jordanbierbrier/capstone/README.md

# Synesthesia Wear

Developer Names:
- Abraham Taha
- Azriel Gingoyon
- Jordan Bierbrier
- Taranjit Lotey
- Udeep Shah

Date of project start:
September 6, 2022

This project is to create a wearable device that can detect specific sounds from the environment and notify the user.

The folders and files for this project are as follows:

- docs: Documentation for the project
- refs: Reference material used for the project, including papers
- src: Source code
- test: Test cases
