jordanbierbrier/capstone/docs/ProblemStatementAndGoals/ProblemStatement.tex

\documentclass[12pt, titlepage]{article}

\usepackage{booktabs}
\usepackage{tabularx}
\usepackage{hyperref}
\usepackage[table,xcdraw]{xcolor}
\usepackage{longtable}
\usepackage{multirow}
\usepackage{graphicx}
\usepackage{float}
\hypersetup{
    colorlinks,
    citecolor=black,
    filecolor=black,
    linkcolor=red,
    urlcolor=blue
}
\usepackage[round]{natbib}
\usepackage{ulem}

\input{../Comments}
\input{../Common}

\begin{document}

\title{Problem Statement and Goals: \progname} 
\author{\authname}
\date{\today}

\maketitle

\pagenumbering{roman}

\section*{Revision History}

\begin{tabularx}{\textwidth}{p{3cm}p{2cm}X}
\toprule {\bf Date} & {\bf Version} & {\bf Notes}\\
\midrule
9/26/2022 & 1.0 & Added Section 1\\
9/26/2022 & 1.1 & Added Sections 2,3\\
4/4/2023 & 1.2 & Updated All Sections for Feedback and Consistency\\
\bottomrule
\end{tabularx}

\newpage

\tableofcontents

\listoffigures

\listoftables

\newpage

\section*{Symbols, Abbreviations and Acronyms}

\renewcommand{\arraystretch}{1.2}
\begin{tabular}{l l} 
  \toprule		
  \textbf{symbol} & \textbf{description}\\
  \midrule 
  Age groups & (15-30, 31-50, 51-75, 75+)\\
  \bottomrule
\end{tabular}\\

\newpage

\pagenumbering{arabic}

\section{Problem Statement}

\subsection{Problem}
In this day and age, communication is a very significant part of our day to day lives.
\sout{So, people who have difficulty in recognizing sounds within their surroundings are not 
able to live their lives to their fullest. For instance, hard of hearing (HoH) individuals 
are not able to always respond promptly whenever their loved ones are calling their name or
when a doorbell rings out for a package delivery. As a result, this can be rather unfortunate
for the HoH individual as inconveniencing loved ones for another appeal or missing a delivery
are both not ideal scenarios to be in. This can especially be the case for life-and-death 
situations where the importance of sound awareness is highlighted. With all this in mind, 
a device which will monitor your surroundings for you would encourage confidence within 
the users to complete daily tasks as well as notably improve their quality of life.}
\textcolor{red}{So, for people who have difficulty hearing sounds in their environment, they are unable to respond 
appropriately when said sounds require their attention. For example, important alerts/sounds such as 
your name being called or a doorbell ring could all be missed if the person of interest is unable to notice 
these sounds when they occur. This can especially be the case for life-and-death situations (such as a fire alarm) 
where the importance of sound awareness is greatly highlighted. With that being said, such instances could be because 
the person had headphones plugged in (which diminish noise from their surroundings) or they are deaf/hard of hearing 
where they may struggle to recognize sounds in their environment. With all this in mind, a wearable device that improves 
its users' auditory awareness by monitoring their environments for specific sounds would definitely help alleviate the 
issues stated before. Furthermore, after said specific sounds are detected, the device would then provide the users with 
an appropriate feedback that helps let them know that their attention is required.}
\subsection{Inputs and Outputs}

\subsubsection {Inputs}
\begin{itemize}
    \item Environment Sounds
    \item App Settings/Configurations
\end{itemize}
\subsubsection {Outputs}
\begin{itemize}
    \item Haptic Feedback (Vibrations)
\end{itemize}

\subsection{Stakeholders}
\begin{itemize}
    \item Individuals who are hard of hearing, deaf or that are in an environment where hearing can be obstructed
    \item Dr.\ Martin Von Mohrenschildt (Project Supervisor)
    \item STRONE Developers (Creators of the project)
\end{itemize}

\subsection{Environment}
\subsubsection{Hardware}
\begin{itemize}
    \item Device can be configured through the use of a personal computer, laptop or phone.
\end{itemize}
\subsubsection{Software}
\begin{itemize}
    \item The application will be supported on both Mac and Windows operating systems.
    \item The application will be supported on IOS and Andrioid mobile devices.   
\end{itemize}

\section{Goals}
\subsection{\sout{Finished device can withstand above moderate environmental conditions such as moisture and heat} \textcolor{red}{Device can withstand normal environmental conditions}}
\begin{itemize}
    \item \sout{The device will be a wearable technology which makes it a necessity that the user does not need to worry about damage in average daily conditions.} \textcolor{red}{The device should not be damaged from daily conditions such as rain, heat, moisture, etc.}
   \end{itemize} 

 \subsection{\sout{Device can collect and process data in real time while filtering out noise} \textcolor{red}{The device will be able to identify key sounds in the environment}}  
 \begin{itemize}
    \item \sout{A core functional aspect of the device is to process a continuous stream of data and react once a key data point is found.} \textcolor{red}{Fire Alarm}
    \item \sout{This permits our device to provide the necessary sensory outputs to the user.} \textcolor{red}{Doorbell Ring}
    \item \textcolor{red}{Names}
  \end{itemize} 

 \subsection{\sout{Finished product can communicate with an external device} \textcolor{red}{User can customize their experience}}
 \begin{itemize}
    \item \sout{Having the ability to directly communicate with external devices will allow the device to be uniquely programmable by different users.} \textcolor{red}{Product will communicate with external devices so that users can customize their keywords}
 \end{itemize}

 \subsection{\sout{Data collected will be processed and then deleted in real time} \textcolor{red}{Real-Time Data Processing}}
 \begin{itemize}
    \item \sout{This allows the product to be used in multiple environments without the risk of privacy concerns for the user.} \textcolor{red}{No delays in results and data storage is not needed.}
\end{itemize}  

 \subsection{Finished product \sout{will retain all functionalities in a form factor that} is wearable}
 \begin{itemize}
    \item Device will need to be appropriately small such that it can be worn comfortably and non-intrusively by the user.
 \end{itemize}

 \subsection{Finished product will be rechargeable and
 reusable}
 \begin{itemize}
    \item This will expand the usability of the device and help market growth.
    \item This will also contribute to reducing e-waste since the finished product will have a longer lifespan.
 \end{itemize} 

 \subsection{The finished product will have \sout{sufficient distinct sensory outputs such that the user can distinguish between them} \textcolor{red}{numerous distinct feedbacks}}
 \begin{itemize}
    \item This allows the device to have multiple programmable key data points that the user can choose to be notified by.
    \item This will also act to expand the usability \sout{of the product} and programmability of the device by the user. 
 \end{itemize} 

\section{Stretch Goals}

\subsection{Finished product will have \sout{a} water resistance \sout{rating of IPX5}}
\begin{itemize}
    \item This will increase usability of the product.
    \item This will also avoid the possibility that the device will become malfunctional under \sout{certain} wet weather conditions.
 \end{itemize} 

\subsection{Finished product can actively filter out noise in particularly loud environments}
\begin{itemize}
    \item This will expand the environments where
    the product can function as intended.
    This will also lead to more reliable
    outputs from the device in situations
    where hearing is more obstructed by
    noises in the surroundings. 
    \textcolor{red}{These environments can be places like a construction site, at a concert, or at the gym.}
\end{itemize}

\subsection{Finished product will support \sout{over the air} firmware updates}
\begin{itemize}
    \item As the product develops and is used in
    real world applications we predict that the
    noise detection algorithm we use will keep
    improving. Having the option to upgrade
    prior devices with better signal processing
    through software will aid in extending the
    usability of older products.
    
\end{itemize}

\end{document}
