jordanbierbrier/capstone/docs/DevelopmentPlan/DevelopmentPlan.tex

\documentclass[12pt, titlepage]{article}

\usepackage{booktabs}
\usepackage{tabularx}
\usepackage{verbatim}
\usepackage{ulem}
\title{Development Plan\\\progname}

\author{\authname}

\date{}

\input{../Comments}
\input{../Common}

\begin{document}
\title{Development Plan: \progname} 
\author{\authname}
\date{\today}
	
\maketitle

\pagenumbering{roman}

\section*{Revision History}

\begin{tabularx}{\textwidth}{p{3cm}p{2cm}X}
\toprule {\bf Date} & {\bf Version} & {\bf Notes}\\
\midrule
9/26/2022 & 1.0 & Initial commit\\
9/26/2022 & 1.1 & Updated Workflow Plan Section\\
9/26/2022 & 1.2 & Updated Major Milestones\\
9/26/2022 & 1.3 & Updated Technology Section\\
4/4/2023 & 1.4 & Updated formatting and revised POC content\\
\bottomrule
\end{tabularx}

\newpage

\tableofcontents

\listoffigures

\listoftables

\newpage
\section*{\textcolor{red}{Symbols, Abbreviations and Acronyms}}

\renewcommand{\arraystretch}{1.2}
\begin{tabular}{l l} 
  \toprule		
  \textbf{symbol} & \textbf{description}\\
  \midrule 
  Age groups & (15-30, 31-50, 51-75, 75+)\\
  \bottomrule
\end{tabular}\\

\newpage

\pagenumbering{arabic}

\section{Team Meeting Plan}
The team will meet in person on Wednesdays at 4:30pm on a weekly basis. These meetings will typically be done in person at Thode Library or in the capstone project room. However, additional meetings or daily checkups will be scheduled on a per-need basis depending on the status of the project and upcoming deliverables. Additional meetings may either be held in person or virtually through the use of the team’s Discord server.

\section{Team Communication Plan}
The team will have two primary sources of communication which include a Discord server as well as a Facebook messenger group chat. The Discord server is used for hosting virtual meetings as well as sharing files and useful links. Communication will also occur through commit messages and issues when collaborating on deliverables through GitHub. The purpose of using GitHub will also be for team collaboration as well as changing history and reverting opportunities. 

\section{Team Member Roles}
Although we are split up into different roles, which are based on the workload and our skills, we will work closely with one another and review each other's work thoroughly. It is important to communicate with other team members as all of our modules will be linked together. Additionally, roles can change depending on the amount of work and time required. 
% Please add the following required packages to your document preamble:
% \usepackage{graphicx}
\begin{comment}
\begin{table}[]
	\centering
	\begin{tabular}{| m{5em} | m{4cm}| m{5cm} |}
	\hline
	Member						 & Role                                           & Description                                                                                                                                                                                                                \\ \hline
	Abraham Taha                 & Application Developer                          & This position is focused on creating a web application for the end user. This will allow the end user to interface with the hardware and change the sounds to detect.  \\ \hline
	Jordan Bierbrier             & Signal Processing / Embedded Systems Developer &                                                                                                                                                                                                      \\ \hline
	Taranjit Lotey               & Application Developer                          & Communication between application and hardware / backend development to send physical signals to user                                                                                                                      \\ \hline
	Azriel Gingoyon              & Hardware Developer                             & Cost-effective component research, wristband design, motor/microcontroller integration                                                                                                                                     \\ \hline
	Udeep Shah                   & Signal Processing / Embedded Systems Developer & Noise filtering, signal isolation resource optimization and power optimization                                                                                                                      \\ \hline
	\end{tabular}
\end{table}
\end{comment}

\subsection*{Jordan Bierbrier}
\textbf{Embedded Systems Developer Lead} - The role of this position is to create the software for the microcontroller.

\subsection*{Azriel Gingoyon}
\textbf{Hardware Developer} - The focus of this position is to handle and design all the hardware components for the project.

\subsection*{Taranjit Lotey}
\textbf{Application Developer} - The role of this position is to assist in the creation of the application for the end user.
                                
\subsection*{Udeep Shah}
\textbf{Embedded Systems Developer} - The focus of this position is to create the software for the microcontroller.

\subsection*{Abraham Taha}
\textbf{Application Developer Lead} - The focus of this position is to create the application for the end user.

\section{Workflow Plan}

\begin{itemize}
	\item Git will be used for collaborating, sharing, tracking and saving our work (code and documents). We will include a main branch, which will consist of the most updated working code. The main branch will connect sub-branches of various hardware components, ideally, each hardware component will have its own sub-branch which will be connected via code in the development branch.
	
	\item Branches will be used when editing or adding code and documents to the repository. Branches will follow a naming convention for consistency and coherency. They will be created based on issues, for example, IssueNumber-Description-Branch. As a result, this allows easy branch linking. Additionally, comments or questions found within an issue can easily be traced to a particular branch. 
	
	\item When a group member wants to merge a branch, a pull request must be created. Pull requests will consist of a comprehensive description of the incoming changes, and additional comments, such as tests conducted. 
	
	\item We will also be using a pre-product branch giving the capability to test the functionality of referencing branches within each other before making a pull request into main.
	
	\item \sout{There will be a continuous integration (CI) test to see if the incoming changes are acceptable, by passing a linter check, for example. Furthermore, reviewers will be added to assess the changes and leave any comments which will be documented to review and store thought processes at that current stage of development. Once the CI test passes and the reviewers are satisfied with the changes, the reviewers can accept the changes and the branch can be merged into main. 
	}
	\item \sout{We will track issues within GitHub using the Kanban board, which will reference the issue to a designated branch during the pull request. We can tag issues by priority (low, medium, high), by milestone (hardware, application, firmware, etc) and labels. Issues can be assigned to designated group members, and have reviewers to check up on status and work. 
	}
\end{itemize}

\section{Proof of Concept Demonstration Plan}

The major areas where the project could face issues include: 
\begin{itemize}
	\item \textbf{Sound recognition} - We might not be able to isolate or classify signals accurately. This is especially hard when there is a lot of background noise. \textcolor{red}{This is the hardest part of our project where we are likely to face issues or make certain compromises on. Our POC will focus mainly on achieving or testing the feasibility of different sound recognition methods.}
	% \item \textbf{Vibration motor} - There is a risk of the motor not being powerful enough to get the user’s attention. This may seem easy to tackle by increasing the size and power of the motor but this issues a new issue of power consumption and size increase.
	\item \textbf{Integration of hardware onto a small footprint} - \sout{This is the biggest risk with our project}. We might not be able to fit all the components i.e the microcontroller, motor, microphone and battery in the small footprint that we desire. \textcolor{red}{Though given the limited resources and our team's tight budget, this will be lightly considered.} \sout{The reason why this is hard to tackle is that the smaller we go with our hardware, especially microcontroller and battery, the more cautious we have to be with power consumption and resource allocation. }
	\item \textbf{Bluetooth communication} - There is a  risk that we might not be able to implement the Bluetooth communication, especially with the amount of data we are sending.  
	\item \textbf{User Application} - There is a risk that the application developed will not be cohesive with the functionality of the device. 
\end{itemize} 
The risks associated with our project may change as our development is still ongoing. 
%Our proof of concept (PoC) will try to focus on the integration of major features into a small footprint (still bigger than the final prototype). The main features of the PoC will be sound recognition for three different sounds, vibration alerts and app communication. The proof of concept targets the above risks. Sound recognition will be first tested on a computer using the computer microphone and then transferred to our PoC. The vibration motor also will be tested out on a person through the thickness of a wristband. The PoC will also give us an idea of how small we can compress the device without losing functionality. The successful demonstration of the PoC will certainly reduce the likelihood of not being able to deliver on a final product.
Our proof of concept will try to individually implement a working example of the above features. The main goal of the POC will be to extract features from an audio file. The other part will be to develop a classification model based on the extracted features of a sample set of audio files.
We will also test out the sending and receiving of data using Bluetooth. Also, we will be creating a preliminary user application to showcase future features and expected useability. 

\section{Technology}

\begin{itemize}
	\item \textbf{Programming Languages} - C will be used for the embedded software on the microcontroller for the signal processing. A potential drawback of using C is that the libraries used for classification can be quite low level, making it difficult to integrate within our code. Although, by using C, we can assure that our code will be more efficient since it is programmed at a lower level. Additionally, Java will be used to create the application for the end user. It will be easy for our team members to review the C and Java code, since their syntax is quite similar.
	\item \textbf{Integrated Development Environment (IDE)} - Visual Studio Code will be used for software development, and primarily for the application. A benefit of using Visual Studio Code is that it includes several extensions, such as linters and git tracking. \sout{To add, Eclipse will be used for embedded programming.} \textcolor{red}{Also, Android studio will be used for development of the android application.} A potential issue will be using different IDEs for software, although they are two separate modules.
	\item \textbf{Linters} - Linters will be used to keep the code format consistent throughout our various modules. For C, we will use the Clang Format linter. For Java, we will use the Checkstyle linter.
	\item \textbf{CI} - \sout{CI will be included within our project. We will apply the linter during the CI to see if there are any issues with the format or obvious errors. Additionally, the C code can be compiled and built during the CI. The latter CI step may be redundant, as you can build the C code locally, although this will be determined after it is tested.}
	\item \textbf{Hardware} - Hardware that will be used include a microcontroller, analog-to-digital converter, microphone, motor, and a battery. The risks with the hardware components are finding small enough components that meet our goals. Additionally, we need to find a microcontroller with high enough processing power.
	\item \textbf{Testing} - Unit tests will be conducted on the modules that are added to the project. Unit tests will be done in both C and in Java.
\end{itemize}

\section{Coding Standard}
\begin{itemize}
	\item Leave concise and appropriate comments.
	\item Name variables in Camel case.
	\item Implement exception handling wherever possible.
	\item Do not use the same identifier for multiple purposes.
	\item Use proper indentation.
	\item Conform similar pieces of code into a function.
	\item Test the code whenever possible.
	\item Avoid lengthy lines of code.
\end{itemize}
\section{Project Scheduling}

The project will mainly be scheduled according to deadlines where a lot of effort
will be made to ensure that members will have enough time to complete tasks.
In terms of project scheduling software, we will be using Google Calendar.
The calendar will be populated with all of the project deadlines, as found in the
course outline, and shared with the team members. When decomposing large
tasks into smaller ones, the team will try to meet up in-person or virtually to
first analyze the task, discuss our thoughts/findings, and then have a vote to try
to account for everyone’s opinions as much as possible. During the analyzes, we
will create a list of the overall goal of the task and subgoals that can be summed
up to achieve the overall goal. For deciding who does what, the team will try to
meet up in-person or virtually to discuss firstly who wants to do what while also
keeping in mind the skills/expertise/knowledge of each individual. After taking
all of this into consideration, we will discuss, have a vote, and allocate the tasks
where splitting of tasks can be considered if need be. Furthermore, different
sizes of the tasks will also be taken into consideration and final decisions on task
allocation will also be dependent on equal shares of the work being completed by
each team member. In terms of our people resources, we believe that the most
effective and realistic way to use our people is to assign them tasks that best
suit their skills while also maintaining motivation by allowing team members to
try tasks that can expand their skill sets.
\subsection*{Major Milestones}

\begin{itemize}
	\item Researching required hardware components for the device.
	\begin{itemize}
		\item This encompasses finding components such as a vibration motor that fits under certain size constraints, a microcontroller that can support a sound recognition implementation, a bluetooth module for communication with software and a microphone for taking signal inputs. 
	\end{itemize}
\end{itemize}

\begin{itemize}
	\item Purchasing the hardware components.
	\begin{itemize}
		\item This is important for having the necessary time to get a working prototype of the device and get an understanding of our hardware. 
	\end{itemize}
\end{itemize}

\begin{itemize}
	\item Creating a communication path between the hardware and the software.
	\begin{itemize}
		\item Essential for determining which user chosen inputs our device will create outputs for. 
	\end{itemize}
\end{itemize}

\begin{itemize}
	\item Creating a PoC that provides a working model of the core requirements.
	\begin{itemize}
		\item This will demonstrate that the core requirements of our project are attainable before creating a finalized version of the device. 
	\end{itemize}
\end{itemize}

\begin{itemize}
	\item Implementing a graphical user interface that can be used to configure the hardware by individual users.
	\begin{itemize}
		\item This will give the users of the product a path to customize the device to their preferred use case without the need for a technical background. 
	\end{itemize}
\end{itemize}

\end{document}
