jordanbierbrier/capstone/docs/VnVReport/VnVReport.pdf

Verification and Validation Report: SE 4G06,

# TRON 4TB6

### Team 26, STRONE Jordan Bierbrier Azriel Gingoyon Taranjit Lotey Udeep Shah Abraham Taha

### April 6, 2023

## Revision History

Date | Version | Notes
3/7/2023 | 1.0 | Added Section 1, 2, and 3 - Purpose,
| | Scope, and Background
3/7/2023 | 1.1 | Added Section 4 - Functional Require-
| | ments Evaluation
3/7/2023 | 1.2 | Added Section 5 - Nonfunctional Require-
| | ments Evaluation
3/8/2023 | 1.3 | Added Section 6 - Unit Testing
4/4/2023 | 1.4 | Updated for final rev

i

## Contents

1 Purpose | 1
2 Scope | 1
3 Background | 1
4 Verification Plan | 1
5 Functional Requirements Evaluation | 2
6 Nonfunctional Requirements Evaluation | 7
7 Safety Requirements Testing | 17
8 Unit Testing | 20
9 Changes Due to Testing | 25
10 Traceability Matrices | 26
11 Appendix | 30

ii

## List of Figures

1 | Detection time for sound inputs | 30
2 | Histogram of 50 testing runs | 31

## List of Tables

1 | Functional Requirement Tests | | 7
2 | Manual Nonfunctional Requirement Tests | | 8
3 | Stress Nonfunctional Requirement Tests | | 9
4 | Performance Nonfunctional Requirement Tests | 12
5 | Security Nonfunctional Requirement Tests | 13
6 | Recovery Nonfunctional Requirement Tests | 14
7 | Visual Nonfunctional Requirement Tests | 15
8 | Load Nonfunctional Requirement Tests | 15
9 | Regulation Nonfunctional Requirement Tests | 16
10 | Upgrade Nonfunctional Requirement Tests | 17
11 | Safety Requirement Tests | 20
12 | Unit Tests | 25
13 | Traceability Between Test Cases and Requirements | 28
14 | Traceability between modules and unit tests | 29

iii

## Symbols, Abbreviations and Acronyms

symbol description

Age groups (15-30, 31-50, 51-75, 75+)

iv

## 1 Purpose

This VnV report’s establishment is to support development of the product Synesthesia Wear. Furthermore, the actions taken in the document are linked with testing to ensure reliability and robustness of the product for adequate detection of particular sounds.

## 2 Scope

The focus of this document is on the output results of Synesthesia Wear when given arbitrary test inputs. Furthermore, black box testing will be used on important aspects of the output and input rather than how the results are being generated. Lastly, these tests will be based on certain implementations we have put into place to handle unexpected inputs.

## 3 Background

Synesthesia wear is designed with a mobile application which allows customization to occur from their mobile devices and allows users to toggle certain sounds on and off to improve usability of the watch. Synesthesia wear will be able to detect key words and sounds that are customized to the users to aid them with their lack of hearing. As a result, this helps them know when someone is calling their name, during emergencies, and many other situations within their daily lives.

## 4 Verification Plan

### 4.1 SRS Verification Plan

- Review by teammates: The SRS was reviewed by teammates working in groups of two. This was done in groups so that teammates can discuss between each other to verify and validate our SRS. This also helped to iron out the previous issues and feedback we had received from our peers.
- Review by stakeholders: The key functional requirements and some key non-functional requirements were discussed with external stake-

1

holders. Some non-functional requirements were not discussed as they were not deemed to be important. The external stakeholders that were consulted for our project were Dr. Martin von. Mohrenschildt and Katherine Hesson-Bolton. Both offered valuable information for our project. Dr. Martin von. Mohrenschildt was consulted at the start and the middle of the project while Katherine Hesson-Bolton was consulted throughout the project.

### 4.2 Design Verification Plan

- Review by teammates: The design was reviewed by all the teammates together in a library meeting room. The feedback from our peers and the initial design goals were considered.
- Review by stakeholders: The design was also reviewed by our professor and our TAs during revision 0 demonstration. A lot of feedback about our design was received then, which has resulted in a couple of changes in key areas of our project.

## 5 Functional Requirements Evaluation

Id | Ref | Description | Input | Expected Result

Actual
Result

Result

Continued on next page

2

Id | Ref | Description | Input | Expected Result | Actual Result | Result
FRT1 | FR1, FR2 | Testing ability to differentiate sounds | Five different sounds | Device pro-duces five different feedbacks | Vibration motor was able to produce different feedbacks when con-figured with 5 different feedback settings | Pass
FRT2 | FR1 | Testing in different environments | Same sound in dif-ferent environ-ments | Same feed-back in all enviroments | Feedback was the same in different environ-ments | Pass
FRT3 | FR1 | Testing at dif-ferent ranges | Same sound at spec-ified dis-tances | Same feed-back at specified distances | Farther distances led to inconsis-tencies in the feedback | Fail

Continued on next page

3

Id | Ref | Description | Input | Expected Result | Actual Result | Result
FRT4 | FR1 | Testing its ability to ig-nore ambient noise | No input | No output | No vi-brations are occur-ing when back-ground noise is present in the envi-ronment | Pass
FRT5 | FR2 | Testing its ability to classify cor-rectly | Different spec-ified words | Feedback based on correct classi-fication | Feedback is correct with re-spect to the con-figured sound clas-sification settings | Pass
FRT6 | FR2 | Testing vari-ability in speech | Same word said by four different people | Same feed-back for all | Some inconsis-tencies in feedback for peo-ple with less train-ing data samples | Fail

Continued on next page

4

Id | Ref | Description | Input | Expected Result | Actual Result | Result
FRT7 | FR2 | Testing its ability to ignore high amplitude random sounds | Random not spec-ified sounds | No haptic feedback | No feed-back occurred for the random sound samples | Pass
FRT8 | FR3 | Testing newly set classifica-tions | A newly set classifi-cation sound | The speci-fied haptic feedback | The cor-rect feed-back for the newly configured sound occurred | Pass
FRT9 | FR3 | Testing removed classifications | A re-moved classifi-cation sound | No feedback | No feed-back took place for the clas-sification sound that was removed | Pass
FRT10 | FR3 | Testing re-boot and memory retention | Power switched on and off and test FRT5 run again | Feedback based on correct classi-fication | Correct feedback still oc-curred after the device was rebooted | Pass

Continued on next page

5

Id | Ref | Description | Input | Expected Result | Actual Result | Result
FRT11 | FR4 | Testing hap-tic feedback with the device worn | Specified sound | Haptic feed-back based on the sound’s classification | The ap-propriate feedback happened even when the device was being worn | Pass
FRT12 | FR4 | Testing vari-ability in hap-tic feedbacks | Three different spec-ified sounds | Different hap-tic feedbacks that convey the specified sounds | Proper feedbacks with re-spect to each input sound occurred | Pass
FRT13 | FR4 | Testing differ-ent wearable orientations | FRT12 run on different orien-ations | All orienta-tions give consistent output | The same feed-back was present for any device orientation that was used | Pass
FRT14 | FR4 | Testing in-tensity of feedback wearing dif-ferent clothes of varying thickness | FRT12 run on three different clothes | All clothes give consis-tent results | The thicker clothes lead to inconsis-tencies in feedback | Fail

Continued on next page

6

Id | Ref | Description | Input | Expected Result | Actual Result | Result
FRT15 | FR5 | Testing real-time applica-tion of device | Specified sound | Correct clas-sification within one second | Feedback had oc-curred within one second after an in-put sound had been said aloud | Pass

Table 1: Functional Requirement Tests

## 6 Nonfunctional Requirements Evaluation

### 6.1 Manual

Id | Ref | Description | Input | Expected Result | Actual Result | Result
NFRT3 | NFR1 | Testing but-ton function-ality based on button colour | Open Appli-cation | Different coloured buttons perform different functionali-ties | Buttons with simi-lar colour performed similar functions | Pass
NFRT6 | NFR1 | Testing usability, accessability, findability of application and device | N/A | Achieve av-erage score of 8 from 10 participants (rated out of 10) | | TBD

Continued on next page

7

Id | Ref | Description | Input | Expected Result | Actual Result | Result
NFRT7 | NFR2 | Testing user interface’s consistency in appearance | N/A | Achieve av-erage score of 4 out of all questions from partic-ipants | | TBD
NFRT12 | NFR4 | Testing abil-ity to config-ure different keywords on application | Click keyword selec-tion button | Keyword configura-tion screen | Reached keyword config-uration screen on application | Pass
NFRT13 | NFR4 | Testing abil-ity to select language of use on application | Preferred Lan-guage | Application translated to preferred language | | TBD
NFRT14 | NFR4 | Testing abil-ity to select language of use on al-ready set-up device | Change Lan-guage | Application translated to chosen language | | TBD
NFRT15 | NFR4 | Testing ac-curacy of translated languages on application | Team trans-lates manuals | Translated manuals | | TBD

Table 2: Manual Nonfunctional Requirement Tests

### 6.2 Stress

8

Id | Ref | Description | Input | Expected Result | Actual Result | Result
NFRT11 | NFR3 | Check if you can configure an unrec-ognizable keyword | Unreco-gnizable keyword | Keyword not sup-ported | Keyword not sup-ported | Pass
NFRT24 | NFR11 | Feed 6 sam-ples 50 times each with random noise added. Check if correctly classified 90 percent of the time | Sound clips | 90 percent correct clas-sification | 82 percent classifi-cation. See Fig-ure 2 in Appendix | Fail
NFRT25 | NFR12 | Check the av-erage battery life of the de-vice by timing when 10 dif-ferent device runs out of battery | 10 fully charged devices | Average battery life of 10 devices is more than 12 hours | | TBD
NFRT29 | NFR16 | Checking the durability of the device in-cluding mate-rial wear, bat-tery etc | Device | Lifetime of device should be 5 years | | TBD

Table 3: Stress Nonfunctional Requirement Tests

### 6.3 Performance

9

Id | Ref | Description | Input | Expected Result | Actual Result | Result
NFRT1 | NFR1 | Checking what the initial state of application is. | Open Appli-cation | Home Page of Applica-tion | Home Page of Applica-tion | Pass
NFRT2 | NFR1 | Can users find the pairing but-ton of the application. | Open the Appli-cation, Click pair button | User clicks pair button under 10 seconds | Users found pairing buttons under 10 seconds | Pass
NFRT4 | NFR1 | Checking if application correctly goes to pairing page. | Open the Appli-cation, Click pair button | Pairing page of Application | Pairing page of Applica-tion | Pass
NFRT5 | NFR1 | Checking if application correctly goes to keyword selection page. | Open the Appli-cation, Click keyword selec-tion button. | Keyword Selection page of Application | Keyword Selection page of Applica-tion | Pass

Continued on next page

10

Id | Ref | Description | Input | Expected Result | Actual Result | Result
NFRT8 | NFR3 | Check to see if the applica-tion connects to the device through blue-tooth out of scope | Open appli-cation, click pair button on both device and applica-tion | Device pairs to Phone | Device Pairs to Phone | Pass
NFRT16 | NFR5 | Checking if users can pair a device to phone in under 5 minutes | Open appli-cation, click pair button on both device and applica-tion | 3/4 Users fully pair device in under 5 minutes | 4/4 Users pair de-vice under 5 minutes | Pass
NFRT19 | NFR9 | A sound will be fed to the device that includes a keyword device should be able to provide feed-back in under 1 second 8/10 times | Sound that in-cludes a keyword | 8/10 key-words detected in under 1 second | 9/10 Key-words detected. See Fig-ure 1 in Appendix | Pass

Continued on next page

11

Id | Ref | Description | Input | Expected Result | Actual Result | Result
NFRT20 | NFR9 | Checking how fast the UI of application responds to user input | User In-put | Average of 100 inputs is under 1ms | | TBD
NFRT21 | NFR9 | Checking that appli-cation can separately connect to 5 independent devices | Pairing button on both applica-tion and device | 5/5 devices pair in under 1 minute | All 5 paired in under 1 minute each | Pass
NFRT30 | NFR17 | Let 10 people use device for 3 days record how many say it inhibits their lives | unpaired device and un-opened applica-tion | 8/10 par-ticipants do not the device to inhibit their lives | | TBD
NFRT32 | NFR17 | Check to see if users can install the application on IOS and Android | Click Install | installed application on IOS and Android | Installed on An-droid | Fail

Table 4: Performance Nonfunctional Requirement Tests

12

### 6.4 Security

Id | Ref | Description | Input | Expected Result | Actual Result | Result
NFRT9 | NFR3 | Checking if application pairs to de-vice that is not in pairing mode | Click pair Button | Device not found | Device not found | Pass
NFRT10 | NFR3 | Check if user can Login to application without a registered account | Invalid Login Credin-tials | Account not found | Account not found | Pass

Table 5: Security Nonfunctional Requirement Tests

### 6.5 Recovery

Id | Ref | Description | Input | Expected Result | Actual Result | Result
NFRT18 | NFR8 | Check to see if a initially paired device will automat-ically repair when taken out of range than put back into range | Take device in/out of range | device should rapair 90 percent of the time | device re-paired 100 percent of the time | Pass

Continued on next page

13

Id | Ref | Description | Input | Expected Result | Actual Result | Result
NFRT22 | NFR9 | Checking to see how long it takes a paired device to repair when brough back into range. | place device back into range | Average time of re-connection should be 10 seconds or less | Average time was 6 seconds | Pass

Table 6: Recovery Nonfunctional Requirement Tests

### 6.6 Visual

Id | Ref | Description | Input | Expected Result | Actual Result | Result
NFRT17 | NFR6 | people from different age groups will be shown icons found in application and asked if they can identify their meaning | N/A | All 5 icons named by 3/4 partic-ipants of each age group | | TBD
NFRT23 | NFR10 | Check if bat-tery is visual on the final device | N/A | Battery should not be visible | Battery is not visible | Pass

Continued on next page

14

Id | Ref | Description | Input | Expected Result | Actual Result | Result
NFRT31 | NFR17 | Check if the device is ad-justable such that it fits on different sized wrists | Adjust size | Should fit wrists of size 6-8.5 inches | Fits speci-fied Wrist sizes | Pass
NFRT34 | NFR25 | Check if the code has anything that would be offensive to any groups | N/A | There should not be anything offensive present | Nothing that is offensive was found | Pass

Table 7: Visual Nonfunctional Requirement Tests

### 6.7 Load

Id | Ref | Description | Input | Expected Result | Actual Result | Result
NFRT26 | NFR12 | Device will be turned on for a duration of 5 hours during which keywords will be fed at randon time intervals. Test passes if device re-acts at each interval | Sound clips | Device should react at each of teh 5 random intervals | device re-acts at 5/5 intervals | Pass

Table 8: Load Nonfunctional Requirement Tests

15

### 6.8 Regulation

Id | Ref | Description | Input | Expected Result | Actual Result | Result
NFRT35 | NFR26 | Team of lawyers will check if the project as a whole corre-sponds with all legal ru-lations and requirements. | N/A | Project fol-lows all le-gal require-ments | | TBD

Table 9: Regulation Nonfunctional Requirement Tests

### 6.9 Upgrade

Id | Ref | Description | Input | Expected Result | Actual Result | Result
NFRT27 | NFR12 | Helper code will be used to check if application is currently up if appli-cation goes down the developers will recieve an email | N/A | Application should have a continous uptime of 1 year | | TBD

Continued on next page

16

Id | Ref | Description | Input | Expected Result | Actual Result | Result
NFRT28 | NFR15 | Check if products sup-ports up to 10 keywords 2 years after launch. | 10 key-words | product will support at minimum 10 keywords | | TBD
NFRT33 | NFR20 | Try and us-ing the device 24 hours after a major up-date has been pushed to the application | Input a sound | Device should re-tain 100 percent functional-ity | | TBD

Table 10: Upgrade Nonfunctional Requirement Tests

## 7 Safety Requirements Testing

Id | Ref | Description | Input | Expected Result | Actual Result | Result
SRT1 | SIR1 | The powered device will be checked for live current at all possible contact loca-tions with the user’s hand. | Multimeter probe | No live cur-rent | No live current detected | Pass

Continued on next page

17

Id | Ref | Description | Input | Expected Result | Actual Result | Result
SRT2 | SIR2 | The device auto-shutoff feature will be checked, to protect against abnormal current char-acteristics. | VCC con-nected to 10 volts | The con-troller detects it and isolates itself | The con-troller was able to protect itself | Pass
SRT3 | SR3 | Check if the powered device stays within the allocated temperatures. | Thermocouple probe | Temperature difference is less than 5 degrees | Temperature difference was 3 degrees | Pass
SRT4 | SR4 | Check if the data and functionality of the device are retained if the power is cutoff abruptly. | Power discon-nected and con-nected | The device restarts correctly with any loss of func-tionality | The device restarted correctly | Pass
SRT5 | ACR1 | Check if the user can up-date the in-tensity of the vibration de-vice. Out of scope | N/A | N/A | N/A | TBD

Continued on next page

18

Id | Ref | Description | Input | Expected Result | Actual Result | Result
SRT6 | ACR2 | Check if the application can handle invalid in-puts and not break. | Invalid inputs | No reaction | No reac-tion | Pass
SRT7 | ACR3 | Check if the application is able to alert the user if an incompatible device has been used. Out of scope | N/A | N/A | N/A | TBD
SRT8 | IR3 | Check if the device syncs automati-cally when it is con-nected to the application. | New connec-tion | Settings up-dated | Settings updated | Pass
SRT9 | IR4 | Check if the application prevents the user from selecting the same vibration for two different classes. | Same vibra-tion setting for two different classes | Error mes-sage | Did not allow the change | Pass

Continued on next page

19

Id | Ref | Description | Input | Expected Result | Actual Result | Result
SRT10 | IR5 | Check if the application tries to sync only when it needs to. | Random appli-cation move-ment | No sync re-quest until a change in settings | Correct output | Pass
SRT11 | IR6 | Check if the device can handle a sound of 90dB without breaking. | 90 dB keyword sound | Correctly classified and retains functional-ity | Correct classifica-tion | Pass
SRT12 | IR7 | Check if the application can handle incorrect Bluetooth signals. | Corrupted Blue-tooth trans-mission received | Error mes-sage | Does not make any change | Pass
SRT13 | IR8 | Check if the device will alert the user if the phone has been randomly disconnected. | Abrupt discon-nection | Haptic and visual feed-back to the user | No output | Fail

Table 11: Safety Requirement Tests

## 8 Unit Testing

The following test cases were derived from the unit test section shown in Synesthesia Wear’s VnVPlan.pdf Document (https://github.com/jordanbierbrier/capstone/blob/main/docs/VnVPlan/VnVPlan.pdf) as well as the modules shown in the MIS.pdf Document. (https://github.com/jordanbierbrier/capstone/blob/main/docs/Design/SoftDetailedDes/MIS.pdf) Furthermore, inapplicable tests from the VnVPlan were not included in the following table as they were not feasible with our current implementation. To make the unit tests applicable we will make im-

20 provements to the sound classification module and bluetooth communication

Id | Ref | Description | Input | Expected Result | Actual Result | Result
UT1 | M4, M9 | Testing accu-racy of the microphone to detect sounds | 3 Dif-ferent Sample Record-ings | 3 Distinct Sample Recordings in mem-ory buffer that match the inputs respectively | The de-tected sounds matched the input sounds | Pass
UT3 | M8 | Testing bluetooth’s ability to send signals accurately | Sample classifi-cation signal asserted on software | Feedback signal as-serted on hardware | According to the classifi-cation signal, the correct feedback signal was sent to the vibration motor | Pass

Continued on next page

21

Id | Ref | Description | Input | Expected Result | Actual Result | Result
UT4 | M7 | Testing clas-sification module’s ability to accurately categorize sound data | Stored samples of sound data in the memory buffer | Accurately classified Sound Data | The clas-sification of the in-put sound samples were ac-curately catego-rized with a con-fidence level of 80% or more | Pass
UT5 | M7 | Testing clas-sification module’s ability to change its sound clas-sification settings | New Classi-fication settings | Classification settings have been changed on the app | The set-tings displayed on the set-tings page match the newly inputted classifi-cation settings | Pass

Continued on next page

22

Id | Ref | Description | Input | Expected Result | Actual Result | Result
UT6 | M4, M7 | Testing feed-back mod-ule’s ability to transmit accurate feed-back signals according to the settings | Feedback signal is asserted | Vibration detected in the bracelet that co-incides with the feedback signal | Vibration motor went off appropri-ately with respect to the settings configured on the app | Pass
UT9 | M2, M8 | Testing blue-tooth connec-tion ability | Enable blue-tooth connec-tion | Bluetooth connection connected in under a minute | Bluetooth connec-tion was estab-lished within 10 seconds | Pass

Continued on next page

23

Id | Ref | Description | Input | Expected Result

Actual
Result

Result

UT10 | M2, M9 | Testing blue- tooth connec- tion’s ability when devices go in and out of range | Separate the con- nected devices
10 | or
| | | more metres away, wait at
least | 5
| | | seconds, then bring the devices closer together

Bluetooth
will disconnect and
reconnect
when | de-
vices | are
back | in
range | to
each other

Bluetooth
was | un-
able | to
automatically
reconnect
when devices went
back in
range

Fail

UT11 | M4 | Testing noise filtering mod-
ule’s | ability
to | remove
| | noise from a sample sound

Digital
data
with
one or
more
sounds
Same | dig-
ital | sound
recording
but with
less noise
The | out-
put | still
had noise
but notably less
compared
to the
original
sound file

Pass

Continued on next page

24

Id | Ref | Description | Input | Expected Result | Actual Result | Result
UT15 | M5 | Testing app interface’s ability to re-spond quickly to a user input | User in-put | User In-terface response within 1ms | The app was appropri-ately able to respond as soon as a but-ton was clicked or an input was submitted | Pass
UT16 | M5 | Testing app interface’s ability to respond the same across differ-ent systems (Android, Windows, IOS) | User In-put | Same User Interface response on all the different devices | N/A (The app has not yet been im-plemented on differ-ent IOS systems) | N/A

Table 12: Unit Tests

## 9 Changes Due to Testing

Test results marked as Fail require revisions in future implementations.

### 9.1 Changes Due to Requirement Tests

- Add capability to detect sounds at greater distance (>15m)
- Update sound detection model performance by being more generalizable (i.e. detect sound from different individuals)

25

- Increase accuracy by adding sound clips with various environmental sounds.
- Change the confidence level of sound detection
- Intensity of haptic feedback

### 9.2 Changes Due to Unit Tests

- Add further bluetooth capability to reconnect device with mobile application after device goes in and out of range
- Increase sensitivity of microphone
- Allow for auto bluetooth connection

## 10 Traceability Matrices

All of our tests can be traced back to either functional requirements, nonfunctional requirements and modules.

Tests | Requirements
FRT1 | FR-2
FRT2 | FR-1, FR-2, FR-8
FRT3 | FR-1, FR-8
FRT4 | FR-1
FRT5 | FR-2, FR-8
FRT6 | FR-1, FR-2, FR-6, FR-7, FR-8
FRT7 | FR-1, FR-2, FR-8
FRT8 | FR-3, FR-8
FRT9 | FR-2, FR-3, FR-4
FRT10 | FR-2, FR-3, FR-4
FRT11 | FR-3
FRT12 | FR-2, FR-5
FRT13 | FR-4

26

FRT14 | FR-6
FRT15 | FR-6
FRT16 | FR-6
FRT17 | FR-6
FRT18 | FR-1, FR-2, FR-7
FRT19 | FR-1, FR-2, FR-4, FR-5, FR-7
NFRT1 | NFR-1
NFRT2 | NFR-1
NFRT3 | NFR-1
NFRT4 | NFR-1
NFRT5 | NFR-1
NFRT6 | NFR-1
NFRT7 | NFR-2
NFRT8 | NFR-3
NFRT9 | NFR-3
NFRT10 | NFR-3
NFRT11 | NFR-3
NFRT12 | NFR-4, NFR-25
NFRT13 | NFR-4
NFRT14 | NFR-4
NFRT15 | NFR-4
NFRT16 | NFR-5, NFR-7
NFRT17 | NFR-6
NFRT18 | NFR-8
NFRT19 | NFR-9
NFRT20 | NFR-9
NFRT21 | NFR-9
NFRT22 | NFR-9
NFRT23 | NFR-10
NFRT24 | NFR-11

27

NFRT25 | NFR-12
NFRT26 | NFR-12
NFRT27 | NFR-12
NFRT28 | NFR-15
NFRT29 | NFR-16
NFRT30 | NFR-17
NFRT31 | NFR-17
NFRT32 | NFR-17, NFR-21
NFRT33 | NFR-20
NFRT34 | NFR-25
NFRT35 | NFR-26, NFR-27
SRT1 | SR1
SRT2 | SR2
SRT3 | SR3
SRT4 | SR4
SRT5 | ACR1
SRT6 | ACR2
SRT7 | ACR3
SRT8 | IR3
SRT9 | IR4
SRT10 | IR5
SRT11 | IR6
SRT12 | IR7
SRT13 | IR8
Table 13: Traceability Between Test Cases and Requirements

28

Modules | Unit Tests
| T1 | T3 | T4 | T5 | T6 | T9 | T10 | T11 | T15 | T16
Login Module M1
Bluetooth connection Module M2 | | | | | | X | X

Keyword Selection Module M3

Output Sig-nal Module M4 | X | | | | X | | | X
Profile Module M5 | | | | | | | | | X | X

Battery Status Module M6

Sound Clas-sification Module M7 | | | X | X
Bluetooth Commu-nication Module M8 | | X | | | X | X
Microphone Module M9 | X | | | | | | X

Table 14: Traceability between modules and unit tests.

29

## 11 Appendix

### 11.1 Test Results

### Response Time

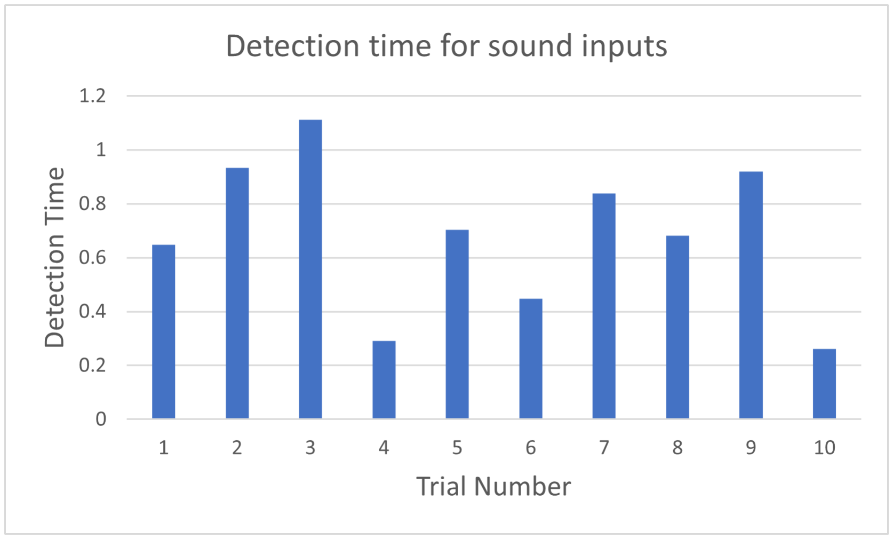
[picture p12: figure]

Figure 1: Detection time for sound inputs

30

### Model Accuracy Histogram


Figure 2: Histogram of 50 testing runs

### 11.2 Reflection

After reviewing both the VnV Plan and the VnV Report, it is clear that there are numerous differences between the predicted outputs shown within the VnV plan and the experimental results found in the VnV report. For example, functional requirement test 3 (FRT3) had a ’fail’ result in the VnV report compared to the VnV plan which had predicted the same haptic feedback at different distances. With this in mind, these kinds of differences indicate that some of the results were not part of the initial expectations and that the Synesthesia Wear team needs to work on finding ways to remove these inconsistencies to further improve and solidify the product.
In another regard, some of the differences were found to be based on surveys which will be conducted after the final revision is completed. An example is nonfunctional requirement test 17 (NFRT17) where a survey will

31 be taken for people in different age groups for icons found in the application. The icons are an aesthetic aspect to the app that have not been implemented yet, but by the time this test is run, they will be included before the survey is performed.
With all this in mind, to improve upon the differences between the two documents, the team will collaboratively brainstorm ideas for fixes/solutions to inconsistent results and possibly try to come up with even more test cases such that it prevents undesirable results from occurring in the first place. For example, testing that invalid sounds are being blocked so that it prevents undesirable haptic feedback from occurring to begin with. Questions that would arise from this train of thought would be concerns like ’what would be considered an invalid keyword?’. Furthermore, thinking about the consequences for the test failures and what the back up plan would have to be in those situations. Lastly, trying to look for alternative options to get the desired output would also be something that needs to be considered.

### 11.3 Synthesis

To conduct our tests, data was required to be collected. Our functional requirement, nonfunctional requirement, and unit tests were carried out to determine the quality and effectiveness of our project. A majority of our tests passed, some were not able to be tested at this point in the development of our project. Additionally, a few tests failed. These are areas in which we will focus our next revision to improve. For example, we could make our sound classification model more robust, since the data we collected (experiments we ran) did not pass expected results. Overall, our goal is to have all of our test results as passes.

32
