jordanbierbrier/capstone/docs/Design/SoftDetailedDes/MIS.pdf

# Module Interface Specification: SE 4G06, TRON 4TB6

### Team 26, STRONE Jordan Bierbrier Azriel Gingoyon Taranjit Lotey Udeep Shah Abraham Taha

### April 5, 2023

## Revision History

Date | Version | Notes
1/18/2023 | 1.0 | Added Content
4/5/2023 | 1.1 | Updated for feedback and consistency

i

## Contents

1 Introduction | 1
2 Notation | 1
3 Module Decomposition | 2
4 MIS of Login Module Design Decision - Removed | 3
5 MIS of Bluetooth Connection Module (M2) | 5
6 MIS of Keyword Selection Module (M3) | 7

ii

7 MIS of Output Signal Module (M4) | 9
8 MIS of Profile Module Design Decision - Removed | 10
9 MIS of Battery Status Out of Scope | 13
10 MIS of Battery Status Sound Classification (M5) | 15

iii

10.4 Semantics | | 15
| 10.4.1 State Variables | | 15
| 10.4.2 Environment Variables | | 15
| 10.4.3 Assumptions | | 15
| 10.4.4 Access Routine Semantics | | 16
| 10.4.5 Local Functions | | 16
11 MIS of Bluetooth Communication Module (M6) | 17
11.1 Module | | 17
11.2 Uses | | 17
11.3 Syntax | | 17
| 11.3.1 Exported Constants | | 17
| 11.3.2 Exported Access Programs | | 17
11.4 Semantics | | 17
| 11.4.1 State Variables | | 17
| 11.4.2 Environment Variables | | 17
| 11.4.3 Assumptions | | 17
| 11.4.4 Access Routine Semantics | | 17
12 MIS of Microphone Module (M7) | 19
13 MIS of Profile Module | 19
13.1 Module | | 19
13.2 Uses | | 19
13.3 Syntax | | 19
| 13.3.1 Exported Constants | | 19
| 13.3.2 Exported Access Programs | | 19
13.4 Semantics | | 19
| 13.4.1 State Variables | | 19
| 13.4.2 Environment Variables | | 19
| 13.4.3 Assumptions | | 19
| 13.4.4 Access Routine Semantics | | 19
14 Appendix | 21

## List of Figures

## List of Tables

1 | Data Notations | | 1
2 | Module Hierarchy | | 2

iv

## Symbols, Abbreviations and Acronyms

See SRS Documentation at SRS.pdf Document Link. (https://github.com/jordanbierbrier/capstone/blob/main/docs/SRS/SRS.pdf)

v

## 1 Introduction

The following document details the Module Interface Specifications for Synesthesia Wear, a wearable product device that assists users by using signal processing on gathered sounds to provide appropriate feedback (via vibrations) to the user according to inputted sound configuration settings. As a result, this gives the users peace of mind knowing that if their attention is needed (doorbell, ring, name call, etc.), Synesthesia Wear will be able to alert them.
Complementary documents include the System Requirement Specifications and Module Guide. The full documentation and implementation can be found at Team 26 Capstone GitHub Repository. (https://github.com/jordanbierbrier/capstone)

## 2 Notation

The structure of the MIS for modules comes from Hoffman and Strooper (1995), with the addition that template modules have been adapted from Ghezzi et al. (2003). The mathe-matical notation comes from Chapter 3 of Hoffman and Strooper (1995). For instance, the symbol := is used for a multiple assignment statement and conditional rules follow the form (c1 ⇒ r1|c2 ⇒ r2|...|cn ⇒ rn).
The following table summarizes the primitive data types used by SE 4G06, TRON 4TB6 STRONE.
Data Type | Notation Description
character | char | a single symbol or digit
integer | Z | a number without a fractional component in (-∞, ∞)
natural number N | a number without a fractional component
| | in [1, ∞)
real | R | any number in (-∞, ∞)

Table 1: Data Notations

The specification of SE 4G06, TRON 4TB6 STRONE uses some derived data types: sequences, strings, and tuples. Sequences are lists filled with elements of the same data type. Strings are sequences of characters. Tuples contain a list of values, potentially of different types. In addition, SE 4G06, TRON 4TB6 STRONE uses functions, which are defined by the data types of their inputs and outputs. Local functions are described by giving their type signature followed by their specification.

1

## 3 Module Decomposition

The following table is taken directly from the Module Guide Document (https://github.com/jordanbierbrier/capstone/blob/main/docs/Design/SoftArchitecture/MG.pdf) for this project.

Level 1 | Level 2
Hardware-Hiding | Module
(M1)

Behaviour-Hiding Module

Login Module (Design Decision was made to remove authentication/login aspects of the project)
Bluetooth connection Module (M2)
Keyword Selection Module (M3)
Output Signal Module (M4)
Profile Module
Battery Status Module Out of Scope

Software Decision Module

Sound Classification Module (M5) Bluetooth Communication Module (M6) Microphone Module (M7)

Table 2: Module Hierarchy

2

## 4 MIS of Login Module Design Decision - Removed

### 4.1 Module

Login Type

### 4.2 Uses

N/A

### 4.3 Syntax

### 4.3.1 Exported Constants

N/A

### 4.3.2 Exported Access Programs

Name | In | Out | Exceptions
authorize | keyInput | Authorized
login | keyInput | | Not A Character
switchCue | keyInput | | Not Cueable

### 4.4 Semantics

### 4.4.1 State Variables

Authorized: Authorized is a boolean that is true when the correct credentials are entered and false otherwise.

### 4.4.2 Environment Variables

keyInput: {key.Enter, key.AlphabetCharacters, key.LeftClick}

### 4.4.3 Assumptions

The Synesthesia Wear application is successfully installed on the user’s device and the login page has loaded onto the screen.

### 4.4.4 Access Routine Semantics

switchCue(key.LeftClick):

- transition: mouseLocation.navigate()

3

- output: None
- exception: Not Cueable

login(key.AlphabetCharacters):

- transition: username.addCharacter() or password.addCharacter()
- output: None
- exception: Not A Character

authorize(key.Enter):

- transition: login.submit()
- output: Authorized
- exception: None

4

## 5 MIS of Bluetooth Connection Module (M2)

### 5.1 Module

Bluetooth Connection Module (M2)

### 5.2 Uses

N/A

### 5.3 Syntax

### 5.3.1 Exported Constants

N/A

### 5.3.2 Exported Access Programs

Name | In | Out | Exceptions
Find Device | Boolean onClick | Device ID Array | device NotFound
Connect Device | (Boolean, onClick De- vice ID)

### 5.4 Semantics

### 5.4.1 State Variables

- known Device: Device ID N
- Paired Device

### 5.4.2 Environment Variables

N/A

### 5.4.3 Assumptions

We assume that the mobile device that the user has the application on has a bluetooth module.

5

### 5.4.4 Access Routine Semantics

Find Device(Boolean onClick):

- transition: (Onclick ≡ True) =⇒ Found Devices = =⇒ Found Devices.Add(known Devices) =⇒ Found Devices.Add(device id1)
- output: Found Devices(known Device, device id1, device id2 . . . device idN)
- exception: Device NotFound

Connect Device(Boolean onClick):

- transition: (Onclick ≡ True) =⇒ Paired Device = device id2
- output: None
- exception: None

6

## 6 MIS of Keyword Selection Module (M3)

### 6.1 Module

Keyword Selection Type (M3)

### 6.2 Uses

- Profile Module (Design Decision - Removed)
- Bluetooth Communication Module (M6)

### 6.3 Syntax

### 6.3.1 Exported Constants

N/A

### 6.3.2 Exported Access Programs

Name | In | Out | Exceptions
save | keyInput | Saved | Mouse Not On Save Button
keyword | keyInput | | Not A Character
switchCue | keyInput | | Not Cueable

### 6.4 Semantics

### 6.4.1 State Variables

Saved: Saved is a boolean that is true when the “Save” button has been pressed and false otherwise.

### 6.4.2 Environment Variables

keyInput: {key.AlphabetCharacters, key.LeftClick}

### 6.4.3 Assumptions

The Synesthesia Wear application is successfully installed on the user’s device, the user was able to log into the app, and the sound configuration settings page is loaded onto the screen.

7

### 6.4.4 Access Routine Semantics

switchCue(key.LeftClick):

- transition: mouseLocation.navigate()
- output: None
- exception: Not Cueable

keyword(key.AlphabetCharacters)char:

- transition: keyword.addCharacter()
- output: None
- exception: Not A Character

save(key.LeftClick):

- transition: keyword.save()
- output: Saved
- exception: Mouse Not On Save Button

8

## 7 MIS of Output Signal Module (M4)

### 7.1 Module

Output Signal Module (M4)

### 7.2 Uses

- Sound Classification Module (M5)

### 7.3 Syntax

### 7.3.1 Exported Constants

N/A

### 7.3.2 Exported Access Programs

Name | In | Out | Exceptions
onVolt | (Boolean, Class Id) | | Null class

### 7.4 Semantics

### 7.4.1 State Variables

current Volt: Integer of the current voltage being supplied to the motor

### 7.4.2 Environment Variables

N/A

### 7.4.3 Assumptions

We are assuming that when this module is called that the battery has sufficient charge to power the motor for the called upon number of requests

### 7.4.4 Access Routine Semantics

onVolt(Boolean onOFF, Class id Current):
- transition: Count = Current | While count ! = 0 =⇒ (current volt ≡ 0 ∧ onOFF)
=⇒ current Volt = 5 | count − = count | current Volt = 0
- output: None
- exception: Class id ≡ Null

9

## 8 MIS of Profile Module Design Decision - Removed

### 8.1 Module

Profile Module

### 8.2 Uses

Login Module

### 8.3 Syntax

### 8.3.1 Exported Constants

N/A

### 8.3.2 Exported Access Programs

Name | In | Out | Exceptions
Set First Name | String | | Type Error
Set Last Name | String | | Type Error
Get First Name | | String | Null Exception
Get Last Name | | String | Null Exception
change Password | String | | Type Error
Change Username | String | | Type Error
Get Username | | String | Null Exception

### 8.4 Semantics

### 8.4.1 State Variables

- first name
- last name
- password
- username

### 8.4.2 Environment Variables

key input(keyboard)

10

### 8.4.3 Assumptions

We are assuming that the user has either a touchscreen keyboard or an external keyboard.

### 8.4.4 Access Routine Semantics

Set first name(String Name):

- transition: first name = Name
- output: None
- exception: Type Error

Set last name(String Name):

- transition: last name = Name
- output: None
- exception: Type Error

Get first name():

- transition: None
- output: First name
- exception: Null Exception

Get last name():

- transition: None
- output: last name
- exception: Null Exception

Change password(String Name):

- transition: password = Name
- output: None
- exception: Type Error

Change username(String Name):

- transition: username = Name
- output: None

11

- exception: Type Error

Get username():

- transition: None
- output: username
- exception: Null Exception

12

## 9 MIS of Battery Status Out of Scope

### 9.1 Module

Battery Status

### 9.2 Uses

Indicator N/A

### 9.3 Syntax

### 9.3.1 Exported Constants

N/A

### 9.3.2 Exported Access Programs

Name | In | Out | Exceptions
Low | Bat-
tery
N/A | Low Status | Low | Bat-
tery
Battery
Level
N/A | Percentage | Battery
Status

### 9.4 Semantics

### 9.4.1 State Variables

N/A

### 9.4.2 Environment Variables

keyOutput : key.Low Battery, key.Battery Status

### 9.4.3 Assumptions

Battery will always have some charge on it.

### 9.4.4 Access Routine Semantics

- transition: N/A
- output: Battery level
- exception: N/A

13

### 9.4.5 Local Functions

- get level(int level)
- battery condition(int cond)

14

## 10 MIS of Battery Status Sound Classification (M5)

### 10.1 Module

Sound Classification (M5)

### 10.2 Uses

Categorize detected sounds

- Keyword Selection (M3)
- Bluetooth Communication (M6)
- Microphone (M7)

### 10.3 Syntax

### 10.3.1 Exported Constants

N/A

### 10.3.2 Exported Access Programs

Name | In | Out | Exceptions
Sound level | Microphone | decibels | High/Low Level

### 10.4 Semantics

### 10.4.1 State Variables

N/A

### 10.4.2 Environment Variables

keyOutput : key.microphone N keyOutput : key.decibels N

### 10.4.3 Assumptions

Surrounding sound levels are null compared to required input level.

15

### 10.4.4 Access Routine Semantics

- transition: N/A
- output: decibels
- exception: N/A

### 10.4.5 Local Functions

- sound level(float volume)
- sorting volume()

16

## 11 MIS of Bluetooth Communication Module (M6)

### 11.1 Module

BTComuModule Bluetooth Communication (M6)

### 11.2 Uses

None

### 11.3 Syntax

### 11.3.1 Exported Constants

DataTx:{ BT.send()}

### 11.3.2 Exported Access Programs

Name | In | Out | Exceptions
RecvNewClass | DataRx | - | Class Full
RmClass | DataRx | - | Class Empty
UpdatePref | DataRx | - | -
SendBattV | BattV | DataTx | -

### 11.4 Semantics

### 11.4.1 State Variables

None

### 11.4.2 Environment Variables

BattV: {AnalogRead(BatteryVolt)}
DataRx: {BT.recieve(T1),BT.recieve(T2),BT.recieve(T3)}N

### 11.4.3 Assumptions

Connection with the application is already establised. Bluetooth tries to automatically reconnect if the application is disconnected.

### 11.4.4 Access Routine Semantics

RecvNewClass():

- transition: if(DataRx == T1) then addclass(dataRx)

17

- output: None
- exception: Class Full

RmClass():

- transition: if(DataRx == T2) then rmclass(dataRx)
- output: None
- exception: Class Empty

UpdatePref():

- transition: if(DataRx == T3) then prefchange(DataRx.class,DataRx.pref)
- output: None
- exception: None

SendBattV(BattV):

- transition: None
- output: DataTx == BattV
- exception:

18

## 12 MIS of Microphone Module (M7)

## 13 MIS of Profile Module

### 13.1 Module

MicroMod Microphone (M7)
Bluetooth Communication (M6)

### 13.2 Uses

None

### 13.3 Syntax

### 13.3.1 Exported Constants

None

### 13.3.2 Exported Access Programs

Name | In | Out | Exceptions
updateData SoundIN,CLKINT | SoundData | -

### 13.4 Semantics

### 13.4.1 State Variables

SoundData - Array of sound inputs recorded at every sample interval

### 13.4.2 Environment Variables

SoundIN: { Digital.Read(Digital Microphone) }R CLKINT: {clk.interupt(sample time)}

### 13.4.3 Assumptions

Clock interrupt is already set up to issue interrupts every 1/(sample frequency)

### 13.4.4 Access Routine Semantics

- transition: N/A
- output: decibels

19

- exception: N/A

20

## References

Carlo Ghezzi, Mehdi Jazayeri, and Dino Mandrioli. Fundamentals of Software Engineering. Prentice Hall, Upper Saddle River, NJ, USA, 2nd edition, 2003.

Daniel M. Hoffman and Paul A. Strooper. Software Design, Automated Testing, and Maintenance: A Practical Approach. International Thomson Computer Press, New York, NY, USA, 1995. URL http://citeseer.ist.psu.edu/428727.html.

## 14 Appendix

21
