jordanbierbrier/capstone/docs/Design/SystDesign/SystDes.pdf

# System Design: SE 4G06, TRON 4TB6

### Team 26, STRONE Jordan Bierbrier Azriel Gingoyon Taranjit Lotey Udeep Shah Abraham Taha

### April 5, 2023

## Revision History

Date | Version | Notes
1/15/2023 | 1.0 | Added Template
1/16/2023 | 1.1 | Added sections 1, 2, 3
1/17/2023 | 1.2 | Added sections 4, 5, 6
1/18/2023 | 1.3 | Added sections 7, 8, 9, 10, Appendices
4/5/2023 | 1.4 | Updated for feedback and consistency

i

## Contents

1 Introduction | 1
2 Purpose | 1
3 Scope | 1
4 Project Overview | 3
5 System Variables | 6
6 User Interfaces | 8
7 Design of Mechanical Hardware | 10
8 Design of Electrical Components | 14
9 Design of Communication Protocols | 18
10 Timeline | 19

ii

Appendices | 22
A Mechanical Hardware | 22
A.1 Enclosure Drawings | | 22
A.2 Lid Drawings | | 23
A.3 Assembly | | 24
B Reflection | 24

## List of Figures

1 | System Context Diagram | | 3
2 | Component Diagram | | 5
3 | User Interface Mobile | | 9
4 | Enclosure isometric figures | | 10
5 | lid isometric figure | | 11
6 | Assembly isometric figure | | 12
7 | Exploded view of the assembly | | 13
8 | Complete electrical schematic | | 15
9 | Arduino schematic | | 16
10 | Battery system schematic | | 17
11 | Vibration motor schematic | | 18
12 | Bluetooth Connection between device and microcontroller | | 19
13 | Timeline | | 20

## List of Tables

1 | Requirements and Design Connections Table | | 6
2 | Monitored Variables Table | | 6
3 | Controlled Variables Table | | 7
4 | Constant Variables Table | | 7
5 | List of non-electrical components required | | 10
6 | Electrical Components List | | 14
7 | STRONE Member Responsibilities | | 20

iii

## Reference Material

This section records information for easy reference.

### Abbreviations and Acronyms

symbol | description

SE 4G06, TRON 4TB6 Explanation of program name

iv

## 1 Introduction

Synesthesia Wear is a wearable product device that assists users with certain vocal tasks that need attention. These tasks can be generic or custom to the user as needed. improves users’ auditory awareness of their surroundings. Furthermore, the product will use signal processing to gather and analyze information to determine the best and most appropriate feedback (via vibrations) to send to the user. As a result, this gives the users peace of mind knowing that if their attention is needed (doorbell, ring, name call, etc.), Synesthesia Wear will be able to alert them.

## 2 Purpose

The purpose of this document is to be able to identify and elaborate on all aspects of design involved in the creation of the Synesthesia Wear system. This involves decomposing the system into different categories and components that all have an impact on the system’s overall design and functionality.
To add on, this document is intended to be viewed in conjunction with the MG.pdf (https://github.com/jordanbierbrier/capstone/blob/main/docs/Design/SoftArchitecture/MG.pdf) (Software Architecture Design) and the MIS.pdf (https://github.com/jordanbierbrier/capstone/blob/main/docs/Design/SoftDetailedDes/MIS.pdf) (Detailed Design) documents so that readers may have a full comprehension on the many aspects of Synesthesia Wear’s design in its entirety.

## 3 Scope

### 3.1 Document Scope

As stated before, this document will split up the system design into different categories and components such that the readers may be able to better understand each components impact on the system’s functionality/completeness.

With the above in mind, the scope of this document will involve:

- Project Overview: This section goes over the system’s behaviour, undesired event handling, system components, and requirement-design connections.
- System Variables: As its name suggests, this section goes over variables/aspects to the system that has the potential to change.
- User Interfaces: This section involves elaborating on the interfaces that users interact with when using the Synesthesia Wear system.
- Design of Mechanical Hardware: In this section, details on what will be built, fabrication, materials, and drawings/sketches for mechanical components will be discussed in further detail.

1

- Design of Electrical Components: Similar to design of hardware, this section will instead involve details regarding electrical components.
- Design of Communication Protocols: For this section, details on the communication protocols used in the Synesthesia Wear system will be discussed.
- Timeline: This section will go over the schedules of all remaining tasks for Rev 0 and which team member will be responsible for each task’s completion.

### 3.2 Assumptions

The system is designed with the following assumptions:

A1 | Each user has a device and WIFI capable of installing the Synesthesia Wear application.
Rationale | Without a device and/or internet connection, the user will be unable to benefit from using Synesthesia Wear.
A2 | The users set their sound configurations to realistic daily-life sounds.
Rationale | The system would be inaccurate when trying to process imaginary or rare sounds with a lack of audio samples (like a meteor crash).

The following are in reference to the critical assumptions in Synesthesia Wear’s HazardAnalysis.pdf (https://github.com/jordanbierbrier/capstone/blob/main/docs/HazardAnalysis/HazardAnalysis.pdf) document:

A3 | The battery will not need to be replaced during product lifespan.
Rationale | It is undesirable and annoying for users if they had to replace the battery frequently during use.
A4 | The microphone is not blocked and has realistic access to the environment.
Rationale | If the microphone is intentionally blocked or put into an en-vironment that hinders its detection (anechoic chamber), it is unreasonable to expect accurate results.

2

### 3.3 System Context

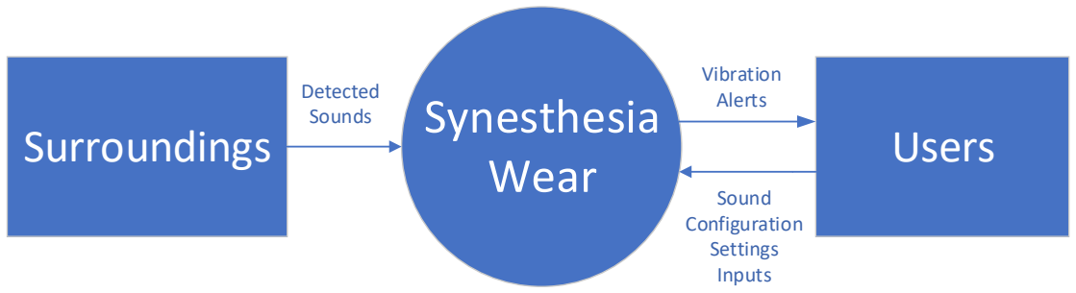
[picture p14: figure]
Synesthesia Wear Surroundings; Detected Sounds; Users; Vibration Alerts; Sound Configuration Settings Inputs

Figure 1: System Context Diagram

## 4 Project Overview

### 4.1 Normal Behaviour

When starting off, the users should strap the Synesthesia Wear bracelet onto either of their wrists as it was intended. Afterwards, users would have to install the Synesthesia Wear app onto a device of their choice and possibly look through the app to get more familiar with its features and user interface. When ready, the user would then input their desired sound configuration settings into the app and then save them so that the app can send these settings over to the bracelet for configurations. Once recieved, the bracelet can then start to detect for sounds where its built-in microcontroller will process these sounds and try to match it with the sounds configured in the settings. Lastly, once a detected sound has “accurately” (according to Machine Learning Algorithm) matched a configured sound, a vibration alert signal will be sent to the built-in vibration motor which will notify the user that their attention is needed.

### 4.2 Undesired Event Handling

Currently, there are only a few undesired events that can be indentified. However, as time progresses, more undesired events will be recognized and dealt with appropriately. So for now, any undesired events not yet discovered will be resolved by setting the Synesthesia Wear system into a dormant state and alerting the user. This makes it so that potential system issues are prevented while also keeping the user informed that the system is in a dormant state and needs a reset for continued use.

With the above in mind, an undesired event that has been identified is in regards to the bracelet trying to detect/process sounds before sound configuration settings have been set.

3

To deal with this, similar to unidentified events, the Synesthesia Wear system will be created such that it is in a dormant/inactive state until sound configuration settings have been inputted. However, one exception would be that there is no need to alert the user for a reset since they have just started using Synesthesia Wear in its refreshed/new state.

Another undesired event would be in regards to the components breaking or malfunctioning. In these cases, the system will be made such that it tests connections/signals between components (like microncontroller, application, etc.) and alerts the user when a connection test has consistently failed. Afterwards, the user would need to contact the Synesthesia Wear team and they would then try to fix the components or order new parts to replace the broken ones.

A third undesired event would be in regards to intentionally covering/hindering the bracelet to detect sounds via holding the bracelet or going into a anechoic (soundless) chamber. In this situation, the microphone in the bracelet will be unable to accurately detect sounds in the environment while its functionality is obstructed. With this in mind, it is believed that there is not really any resolution needed for this situation considering once the user reenters a “normal” or unhindered environment, so long as the components are undamaged, the system’s functionality should still work as intended.

4

### 4.3 Component Diagram

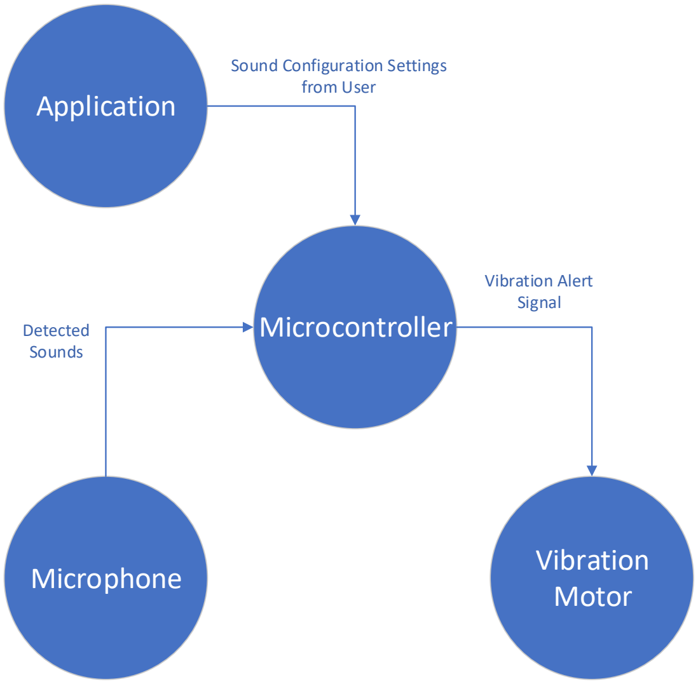
[picture p15: figure]
Microcontroller; Vibration Motor; Application; Microphone; Sound Configuration Settings from User; Detected Sounds; Vibration Alert Signal

Figure 2: Component Diagram

### 4.4 Connection Between Requirements and Design

The following requirements were taken from Synesthesia Wear’s SRS.pdf (https://github.com/jordanbierbrier/capstone/blob/main/docs/SRS/SRS.pdf) document:

5

Requirements | Design Decision
Capability to pick up sounds. | Need to purchase and integrate a mi-crophone.
Capability to classify different sounds. | Need to purchase and integrate a pro-grammable microcontroller that can run machine learning classification al-gorithms.
Ability to set/change sound classifica-tions. | Need to create an application that al-lows users to change classification set-tings.
Ability to effectively give the user feed-back on a sound classification match. | Need to purchase and integrate a vibra-tion motor into the Synesthesia Wear bracelet.
Battery of the device should be shielded to prevent any direct contact with the user. | Need to design/build/purchase a case around the bracelet where the battery will be stored to prevent damage and any contact between user and battery.
The product dimensions should allow fitment on wrist of the user. | Need to purchase and integrate a small microcontroller with built-in modules (bluetooth, microphone, etc.) to reduce product dimensions such that the product dimensions are reduced as much as possible.

Table 1: Requirements and Design Connections Table

## 5 System Variables

### 5.1 Monitored Variables

Monitored Name | Monitored Type | Description
detectedSounds | Sound | Sounds in the environment are being monitored and collected via a microphone in the Synesthesia Wear bracelet.

Table 2: Monitored Variables Table

6

### 5.2 Controlled Variables

Controlled Name | Controlled Type | Description
keyword(s) | String/Word | The keywords are se-lected, viewed, inputted, or changed via the Sound Configuration Settings on the Synesthesia Wear application.
feedback | Vibrations | The vibrations are con-trolled since they only occur once the detected and key-word sounds match to a cer-tain degree.
loginInfo (Design Decision was made to remove login aspects of the project) | Strings/Words | The username and password of the users. This information can be viewed, set, and changed whenever the user desires.

Table 3: Controlled Variables Table

### 5.3 Constant Variables

Constant Name | Constant Type | Description
power | Power | The power required from the battery to activate the Synesthesia Wear bracelet.
deviceOS | Operating System | The operating system of the device that has the Synes-thesia Wear application in-stalled.

Table 4: Constant Variables Table

7

## 6 User Interfaces

### 6.1 System Context

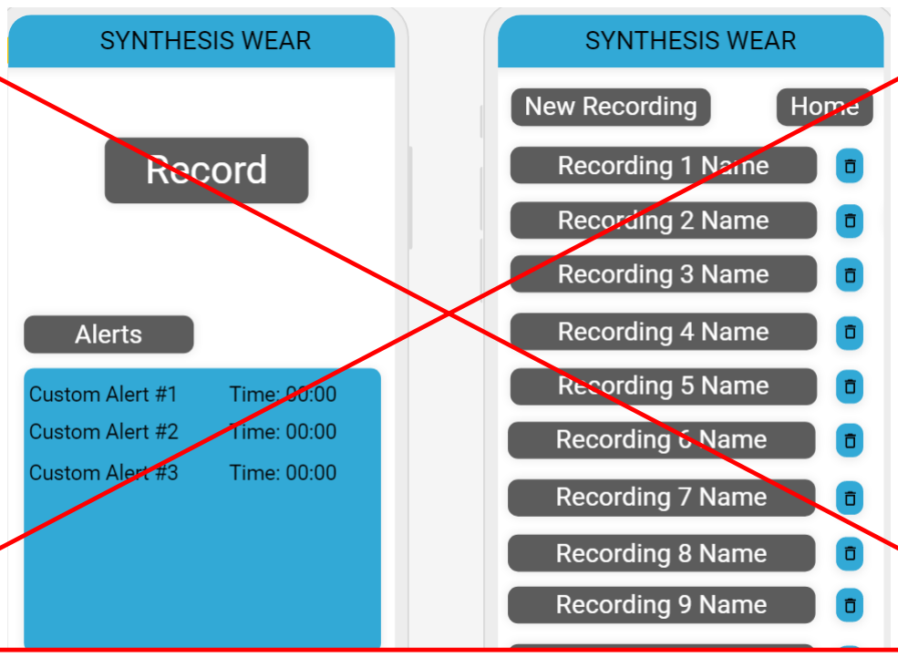
[picture p16: figure]

Record | Allows users to record new audio to be stored
Alters | Notifies user of which alter and the timing
New Recording | Alternative button to change a existing recording
Recording Name | Name of stored recording
Delete | Deletion of stored recording
Home | To go back to main screen

8

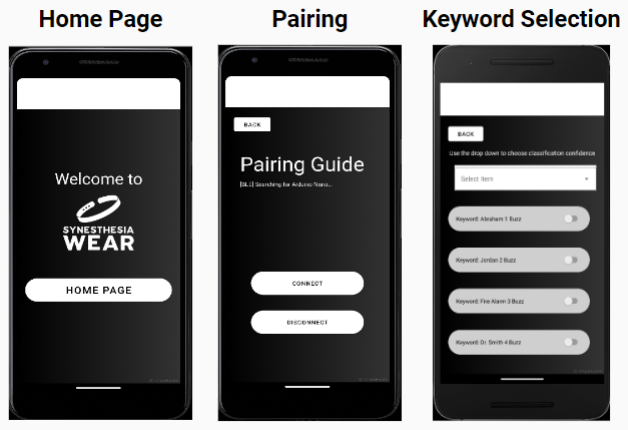
[picture p17: figure]

Figure 3: User Interface Mobile

Home Page | Button that transitions to other features of the app
Connect/Disconnect Buttons that enable or disable the connection between app and hardware
Back | Button that reverts the current page to the previous page
Select Item | Drop down menu that provides a list of numbers for the minimum confi- dence level that the sound classification must adhere to
Keyword | Keywords that are toggled on/off to enable/disable them in the sound classification of the device

9

## 7 Design of Mechanical Hardware

For our project there is limited mechanical hardware required. Most of the components are electrical componets. Regardless the non-electrical componets required are. For our project, most of the components are electrical components where there is some mechanical hardware required. With this in mind, the necessary non-electrical components are:

S.No Component | Material Link | Cost
1 | Base enclosure | PLA | In house | 5
2 | Base lid | PLA | In house | 3
3 | 20mm Watch strap Silicon | shorturl.at/hEFM1 16.99
4 | Super glue | Glue | shorturl.at/CFG09 | 6.27

Table 5: List of non-electrical components required

### 7.1 Base Enclosure

This is the main housing for all the electrical components. It houses the microcontroller, the vibration motor, the battery and the battery management system. It will be 3D printed using PLA as the Material. This housing also provides the additional ability to attach 20 mm watch straps to it. Below are two isometric views of the Base enclosure.


Figure 4: Enclosure isometric figures

There are specifc slots for all the major componets components like the microcontroller, vibration motor, battery, etc. There are also cutouts for the usb C charging port for the battery and a cutout for the battery enable switch. For a detailed drawing refer to the

10

Appendix. The drawing does not show all the dimensions for clarity reasons but it does show the outer dimensions. An explosed exploded diagram with all the components will be shown later in the section.

### 7.2 Enclosure lid

This is the lid for the enclosure that was shown above. It will also be made in house on a 3D printer with PLA plastic. It will be secured to the enclosure using super glue once proper functioning of all the components is achieved. Below is an isometric diagram for view of the lid.

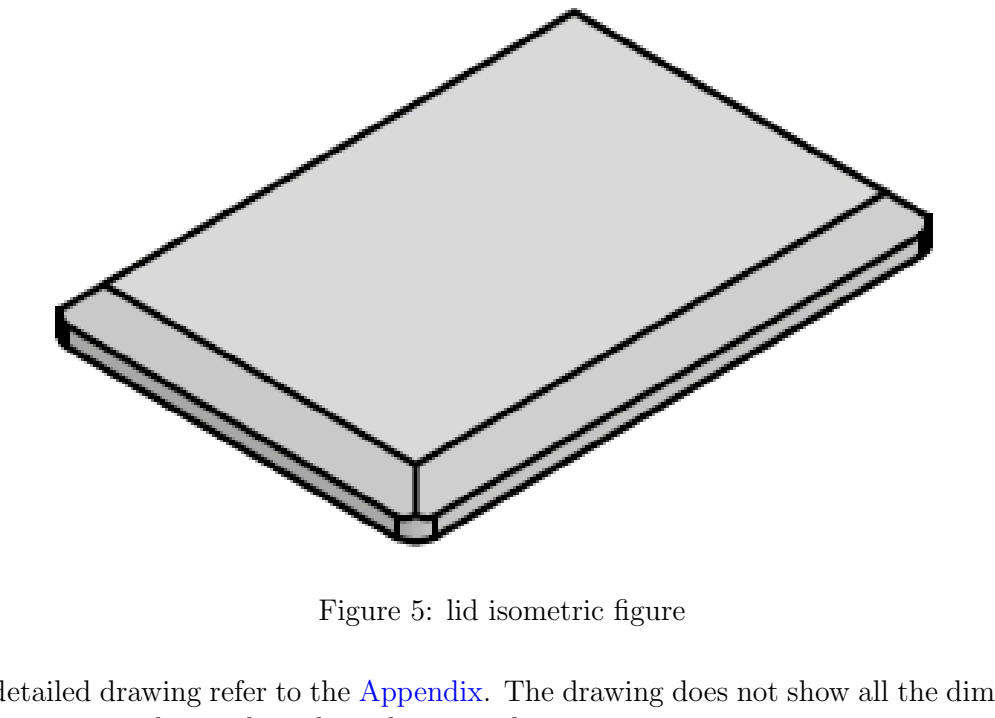
[picture p18: figure]
Figure 5: lid isometric figure

For a detailed drawing refer to the Appendix. The drawing does not show all the dimensions for clarity reasons but it does show the outer dimensions.

### 7.3 Watch straps

A pair of standard 20 mm watch straps will be aquired from external sources. For the material, we have selected silicone rubber as it would be the most durable along with it being cost effective. It is estimated to cost 16.99 CAD. This will attach to the base enclosure using standard 1.5 mm spring jumper lugs that come included with the watch straps. This should enable the user to have the device mounted on the user their wrist without the user having to carry it in the user’s hand their hands.

11

### 7.4 Super glue

Super glue will be used to secure most of the componets in place either directly or indirectly. For the lid it can be directly attached using super glue. However, for the PCBs they have to be attached using plastic dowels with a lid and super glue. There are already holes placed in the enlosure for these fastners fasteners. The use of threaded fasterners was Threaded fasteners were not used due to the difficulty of adding threads accuratly accurately to the plastic enclosure. The disadvange of using the super glue along with the plastic dowels is that once secured, they are permenent.

### 7.5 Complete assembly

The entire hardware is enclosed All of the hardware is contained between the enslosure and the lid. An isometric view of the complete assembly is shown below.

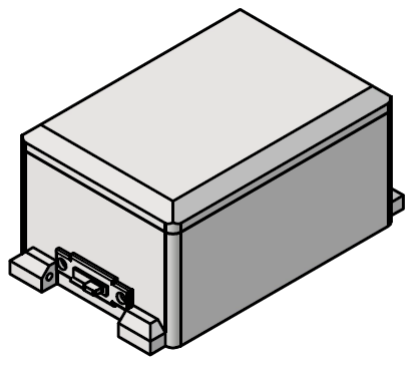
[picture p19: figure]

Figure 6: Assembly isometric figure

The exploded assembly is shown below.

12


Figure 7: Exploded view of the assembly

For a detailed drawing refer to the Appendix. The drawing does not show all the dimensions for clarity reasons but it does show the outer dimensions.

13

## 8 Design of Electrical Components

A list of electrical components required is listed below.

Component | Amount | Cost (in CAD$) | Dimensions | Link
Arduino Nano 33 BLE | 2 | 80 | 48 * 18 | https://www.amazon.ca/Arduino-Nano-33-BLE-Sense/dp/B07WV5GF17 (https://www.amazon.ca/Arduino-Nano-33-BLE-Sense/dp/B07WV5GF17)
Lithium-Ion Polymer (LiPo) Battery (3.7V 1000mAh) | 1 | 10 | 50*32*5 | https://www.canadarobotix.com/products/588 (https://www.canadarobotix.com/products/588)
0.1 microfarad capacitor | 2 | 1.11 | 5*3 | https://rb.gy/vyewya
Resistor 1000 ohm | 1 | NA | 5*3 | At home
Resistor 20 ohm | 1 | NA | 5*3 | At home
Vibration motor | 5 | 10 | 10*2 | https://www.amazon.ca/dp/B089NTLLWB?ref =cm sw r apin dp YEQ7CS0SNQV7HKHZZVFD (https://www.amazon.ca/dp/B089NTLLWB?ref_=cm_sw_r_apin_dp_YEQ7CS0SNQV7HKHZZVFD)
Transistor NPN - PN2222 | 1 | NA | 5*3 | At home
Diode - IN4007 | 1 | NA | 5*3 | At home
Power Management module | 2 | 17.5 | 35*22 | https://www.digikey.com/en/products/detail/sparkfun-electronics/PRT-14411/1568-1723-ND/7725301 (https://www.digikey.com/en/products/detail/sparkfun-electronics/PRT-14411/1568-1723-ND/7725301)
E-Switch Slide switch | 1 | 1.04 | 19*6*5 | https://www.shorturl.at/jMN791

Table 6: Electrical Components List

### 8.1 Complete electrical layout

The entire electrical system can be split into 3 parts

- Microcontroller
- Battery System
- Vibration motor and related electrical components

The complete layout of the electrical componets components are shown below, explanations for the components will come in the later sections.

14

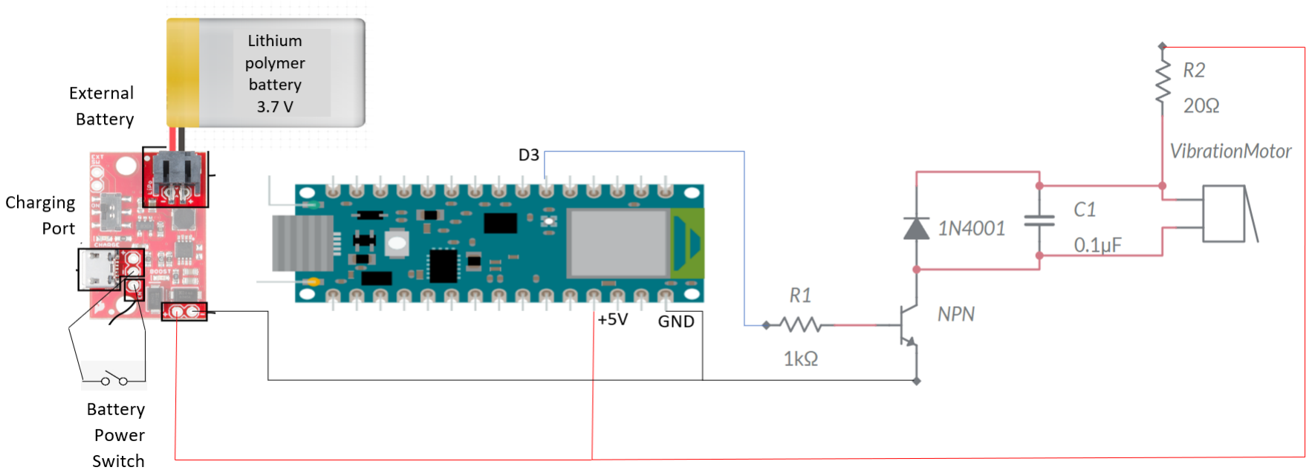
[picture p20: figure]

Figure 8: Complete electrical schematic

### 8.2 Microcontroller

The microcontroller is responsible for most of the the application of the device. It will handle audio dectection, audio processing classification and bluetooth communication. The microcontroller selected is an Arduino nano 33 BLE. This was selected as it is relatively compact with bluetooth and microphone already built into the device. It will be supplied by an external power source of 5V connected directly to the +5V and GND of the Arduino. A digital pin (D3) will be used to control the vibration motor. Below is the schematic of the microcontroller.

15

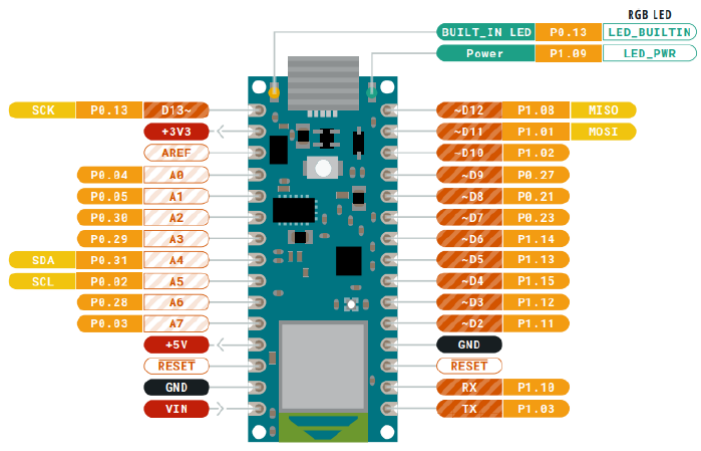
[picture p21: figure]

Figure 9: Arduino schematic

### 8.3 Battery/Power System

The Arduino will be powered by a 5 Volt battery system that can supply up to 1A of current. This should be well within the operating region of the Arduino. The battery system consists of a 3.7 Volt 1000mAh LiPo battery, a SparkFun LiPo Charger/Booster and a small slide switch. The 3.7 Volt LiPo was selected as it is small enough to fit within the design and has enough capacity for a day of usage. The SparkFun LiPo Charger/Booster is used to boost the voltage from 3.7 to 5 Volts as since that is required by the Arduino. It also provides the additional benifit benefit of protecting the battery from high currents. The battery can also be charged using the usb C port on the SparkFun LiPo Charger/Booster. A switch will be soldered on to the enable pin of the charger/booster, this will to provide a way to isolate the battery from the microcontroller and can act like a reset switch. The Ardunio power input will have to be soldered onto the booster output connection. The battery can either be attached using a JST connector or can be soldered on. Below is the schematic for the battery system.

16


Figure 10: Battery system schematic

### 8.4 Vibration motor and related components

The user will be alerted using the vibration motor that is recessed into the enclosure. The vibration motor needs a significant amount of current that the digital output pin cannot supply. Hence the digital pin is just used as an enable pin and the current for the motor is drawn from the 5V pin. To achieve this, an NPN transistor (PN2222) is used as a switch with the digital output pin being its enable enabler. Resistors are also used to limit the current draw of the motor. A capacitor is used to protect from high current impluses impulses and a diode is used to protect the Arduino from backflow in case the motor stalls. The schematic for the circuit is given below. The components will be soldered together with little some wires and while heat shrink will be used over them to prevent shorts. The componets components will be placed next to the vibration motor which is right below the battery booster board.

17


Figure 11: Vibration motor schematic

## 9 Design of Communication Protocols

In regards to communication protocols, the only relevant aspect of Synesthesia Wear would revolve around the bluetooth functionality of the system. As stated in Table ??, the microcontroller used for Synesthesia Wear has a built-in bluetooth module that was purchased for the purposes of reducing product dimensions as much as possible. With this in mind, the system was set up so that this same bluetooth module would be able to connect to the Synesthesia Wear application on the user’s device and thus be able to communicate between each other.

18

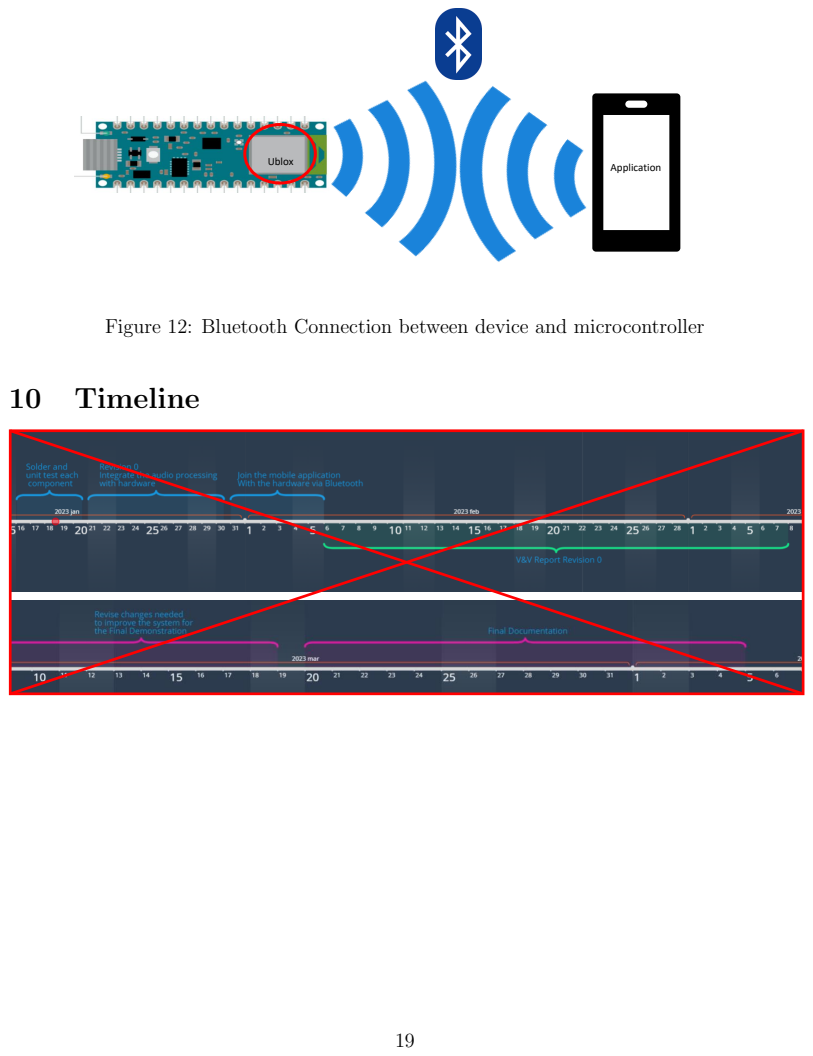
[picture p22: page 24]
Ublox; Application; 10 Timeline

Figure 12: Bluetooth Connection between device and microcontroller

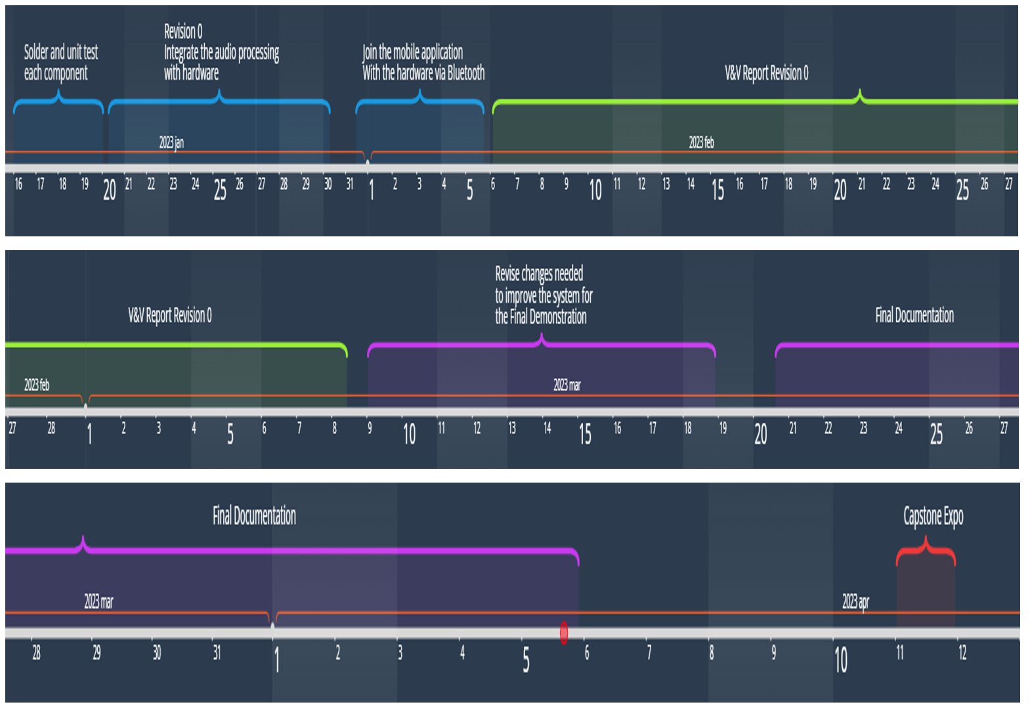
[picture p23: figure]

Figure 13: Timeline

Jordan Bierbrier | Sound classification module development: responsible for getting the machine learning model properly implemented and trained.
Azriel Gingoyon | Sound classification module development: responsible for getting de-sirable sound recognition functionality integrated with the hardware
Taranjit Lotey | Mobile App development: responsible for getting the application pages properly designed and implemented.
Udeep Shah | Hardware Development: responsible for 3D printing as well as putting all of the hardware together.
Abraham Taha | Mobile App Development: responsible for getting the bluetooth con-nection and application features working.

Table 7: STRONE Member Responsibilities

20

### 10.1 Solder and Unit Testing

- Connect and test micro controller with vibrating motor.
- Use module ”Start” as part of Arduino library to test the vibrating motor.
- Use module ”Record” as part of Arduino library to test the microphone.

### 10.2 Integrate Audio Processing

Listed in order of high priority:

- Create module ”Bluetooth Connection”, establish a successful connection
- Create module ”Output Signal”, what will be the output signal for each signal
- Create module ”Sound Classification”, category categories of sound produced
- Create module ”Battery Status”, indication of low battery status
- Create module ”Microphone”, collect the audio recording

### 10.3 Mobile Application and Hardware Connection

- Create module ”Login”, create a personalized login (Design decision was made to remove Authentication/Login aspects of the project)
- Create module ”Keyword Selection”, categorize the recordings
- Create module ”Profile Module”, load the user data
- Create module ”Bluetooth Communication”, communication integrator

21

# Appendices

## A Mechanical Hardware

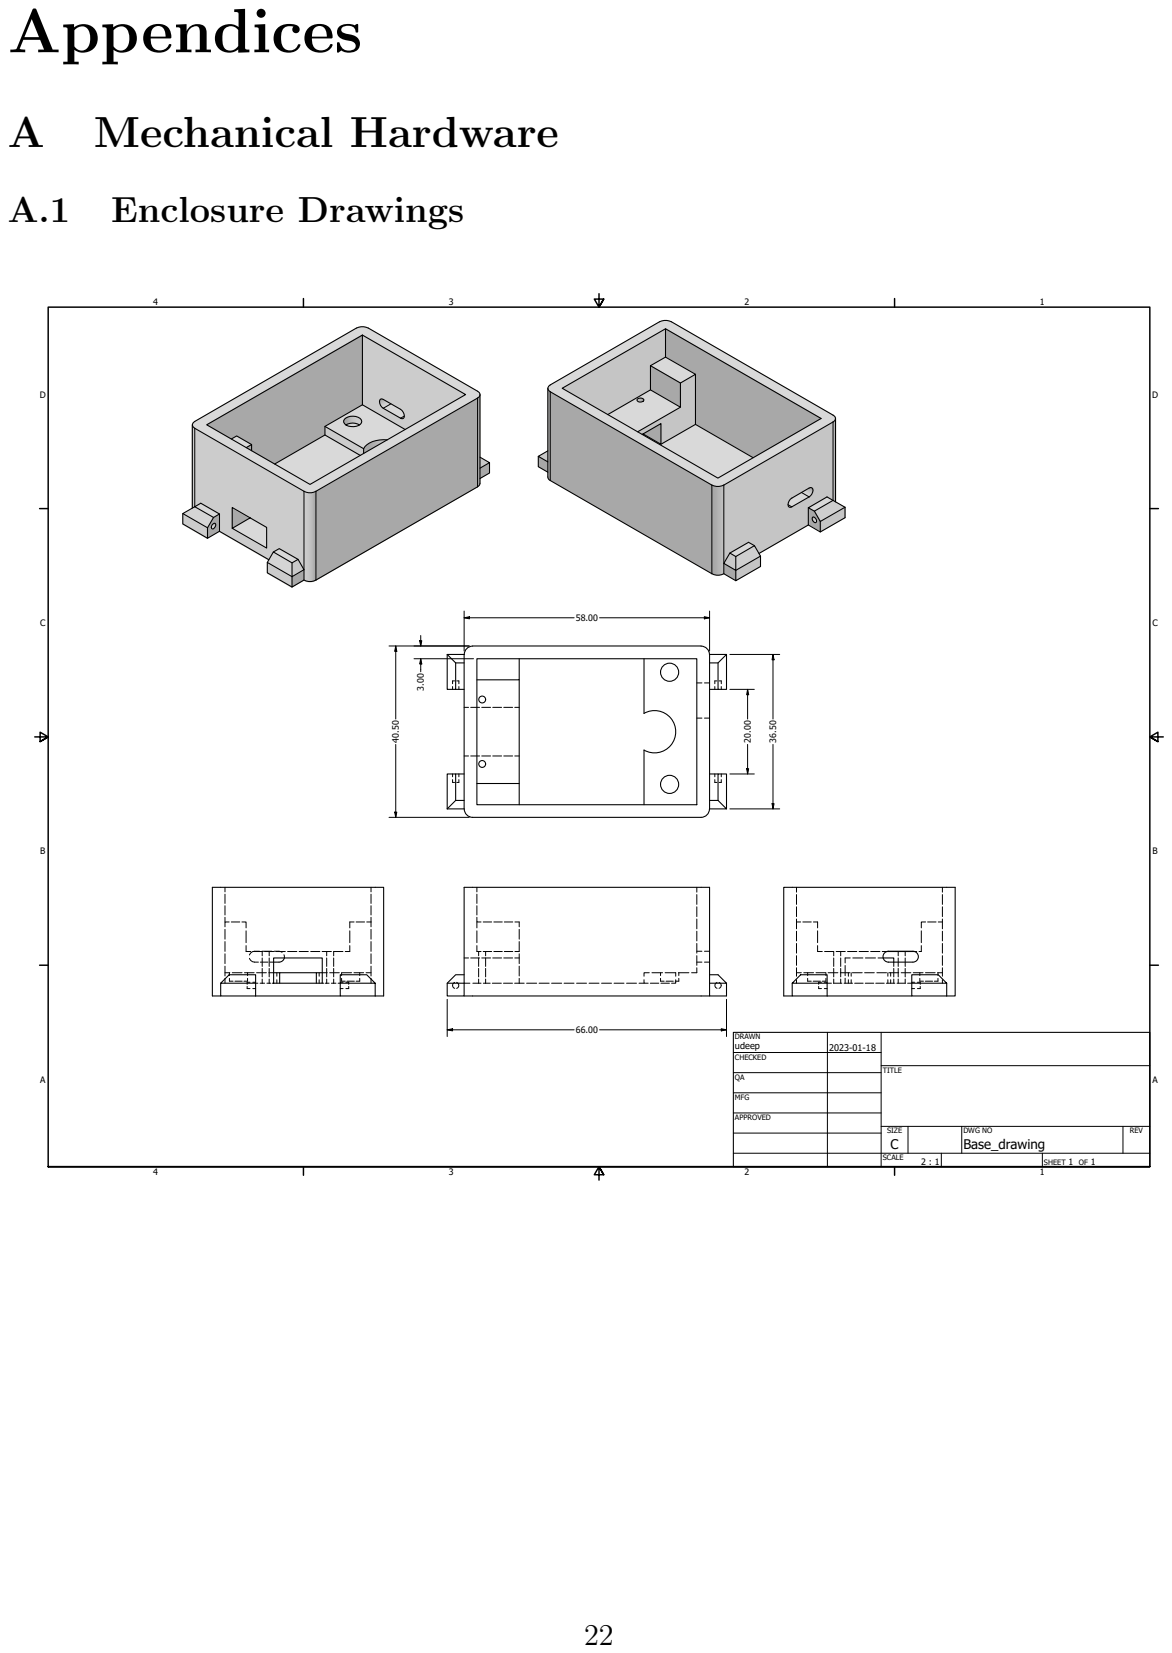
[picture p24: page 27]
Enclosure Drawings; SHEET 1 OF 1; DRAWN; CHECKED; MFG; APPROVED; udeep; DWG NO Base_drawing; TITLE; SIZE C; SCALE; REV

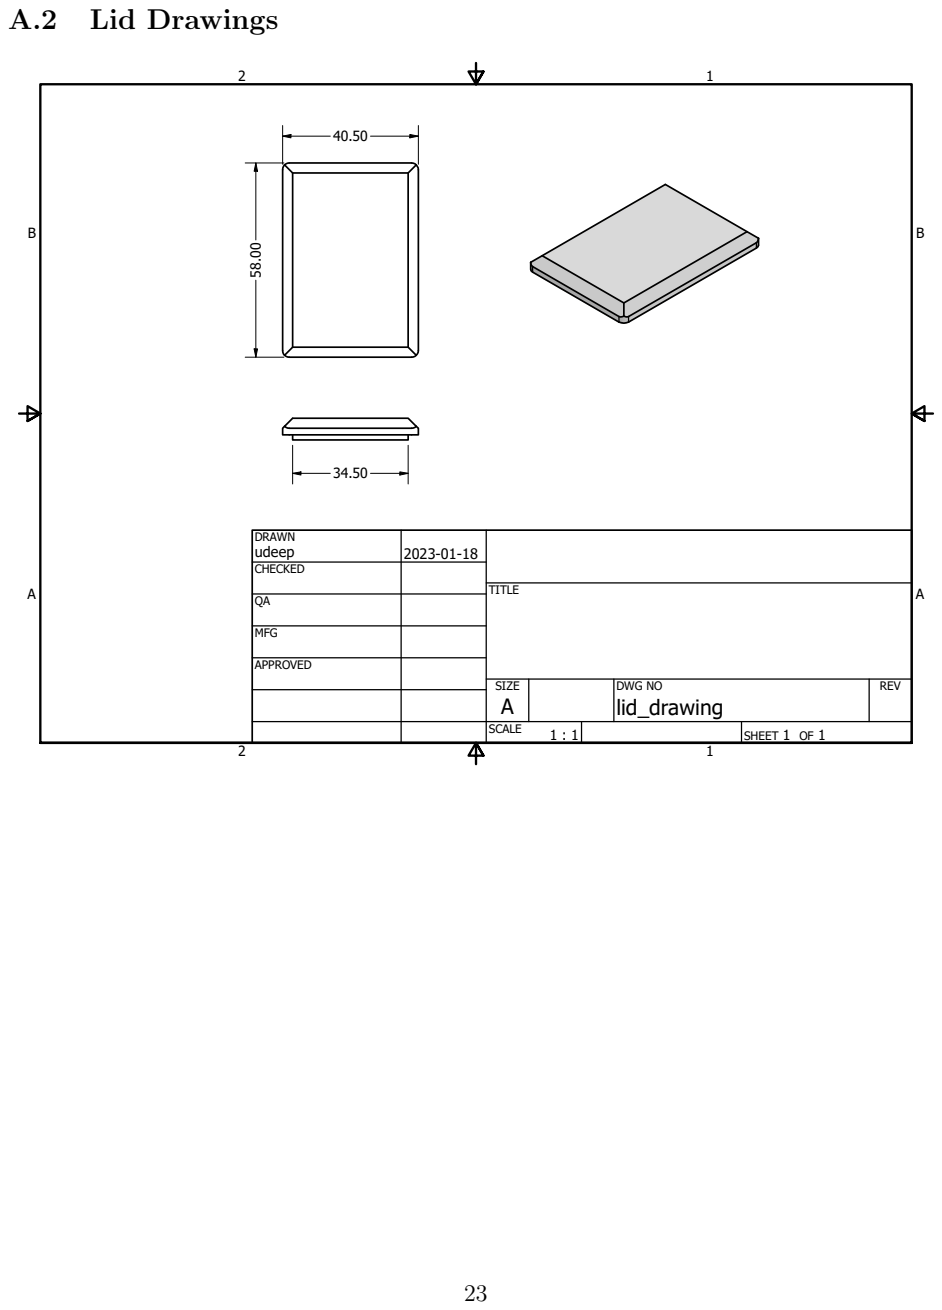
[picture p25: page 28]
Lid Drawings; DRAWN; CHECKED; MFG; APPROVED; udeep; TITLE

SIZE A | | DWG NO lid_drawing | REV

SCALE 1 : 1 | | SHEET 1 OF 1

### A.3 Assembly

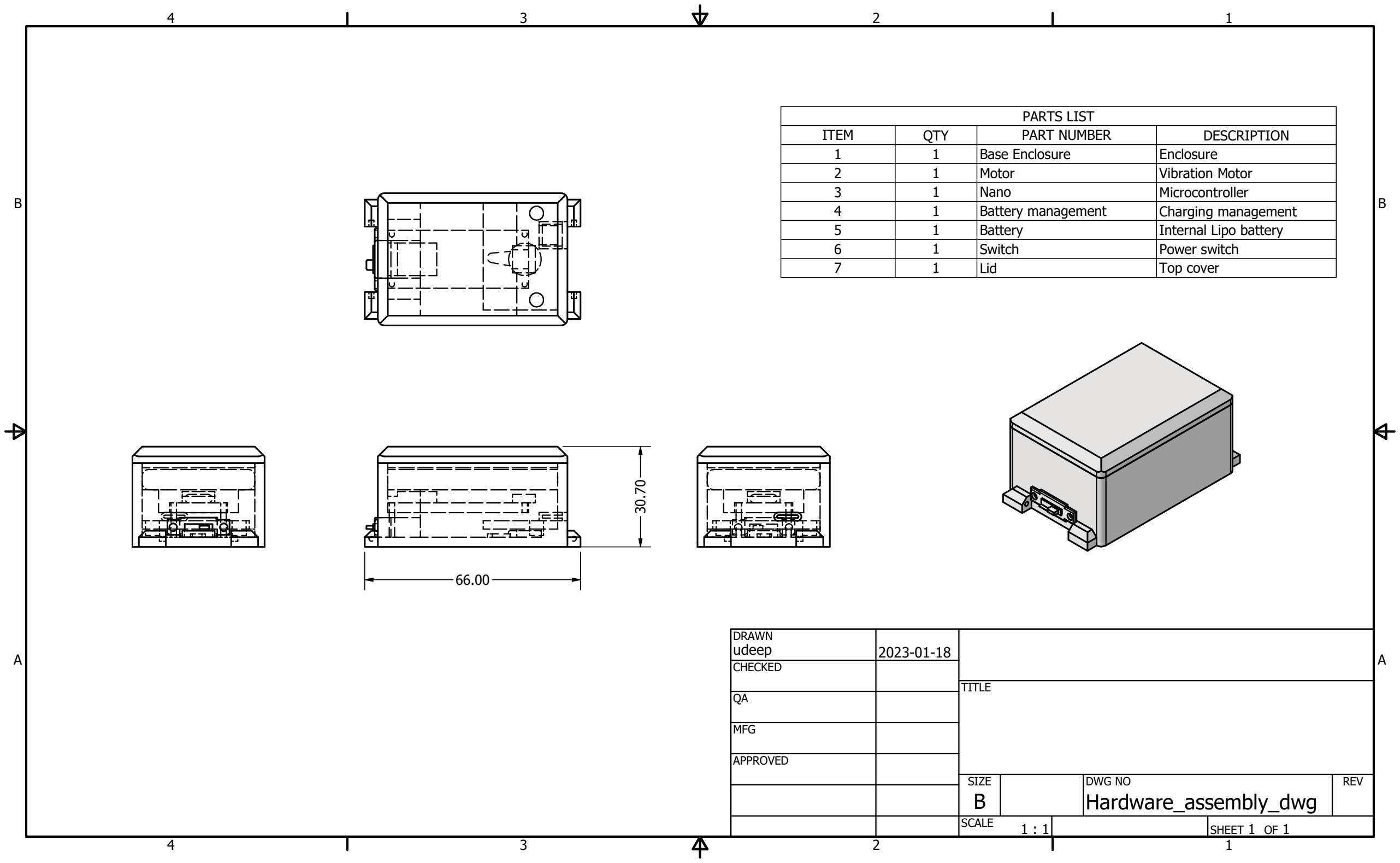
[picture p26: figure]
PARTS LIST; ITEM; QTY; PART NUMBER; DESCRIPTION; Base Enclosure; Enclosure; Motor; Vibration Motor; Nano; Microcontroller; Battery management; Charging management; Battery; Internal Lipo battery; Switch; Power switch; Lid; Top cover; SHEET 1 OF 1; DRAWN; CHECKED; MFG; APPROVED; udeep; DWG NO Hardware_assembly_dwg; TITLE; SIZE B; SCALE; REV

## B Reflection

1. Limitations of the design

Currently the product is quite bulky in terms of size as it is at least 6.5cm in length, 6cm in width, and 3cm in height. It might not seem like much but the final goal was to make the product the size of a small watch instead of a large bulky object. Furthermore, the system cannot function for a long time (at most a day) because the vibration motor and the microphone draw a significant amount of current. Lastly, there are also severe limitations in terms of maintainabilty because once the product is assembled, it cannot be separated.

If given enough resources, a custom PCB with inbuilt bluetooth, microphone, motor, charging slot, and LiPo support can be acquired. This would make the overall design more efficient, both in terms of power and size. Furthermore, maintainabilty can be increased by changing the enclosure to an insulated metal enclosure with threaded inserts to hold all the components in place.

2. Other Solutions

24

A potential design solution could have been to use the microphone and processor of a phone to do the sound recording and classification. It would then send a signal to the microcontroller if any distinct sounds were detected. Furthermore, the benefit of this is that the actual hardware could have been smaller and more compact. On another note, this solution has a drawback where the microphone might not be able to hear sounds accurately since the phone might be inside someone’s trousers or be too far away from the user (i.e phone is charging). With the above in mind, this solution relies heavily on the smartphone, but having this design work efficiently for all phone types might not be feasible.

Another design solution would be to use the microphone on the hardware and to then transmit the sound to the smartphone. From there, the sound will be processed and classified before transmitting the classifed signal back to the microcontroller. With this in mind, this does not have the disadvantage of the smartphone being stuck in trousers as the microphone is near the user while the Synesthesia Wear bracelet is being worn. Lastly, an additional benefit is that the microcontroller can be less powerful and thus more power-efficient. However, the major disadvantage to this is that the smartphone needs to be in range all of the time.

In comparison, the current design does all of the processing, recording, and sound classification on the hardware itself which results in a bit more of a bulky bracelet. Furthermore, it only communicates with the smartphone when the user desires to update their preferences. Thus, this is a major advantage of this design because it can work independently (after initial configuration) and does not have to rely on an external smartphone. With this in mind, this was the main reason this design was selected since the product would be independent and self-sufficient.

25
