jordanbierbrier/capstone/docs/Presentations/FinalPresentation/Synthesia Wear.pdf

# Synesthesia Wear

Feel the Sound

# Agenda

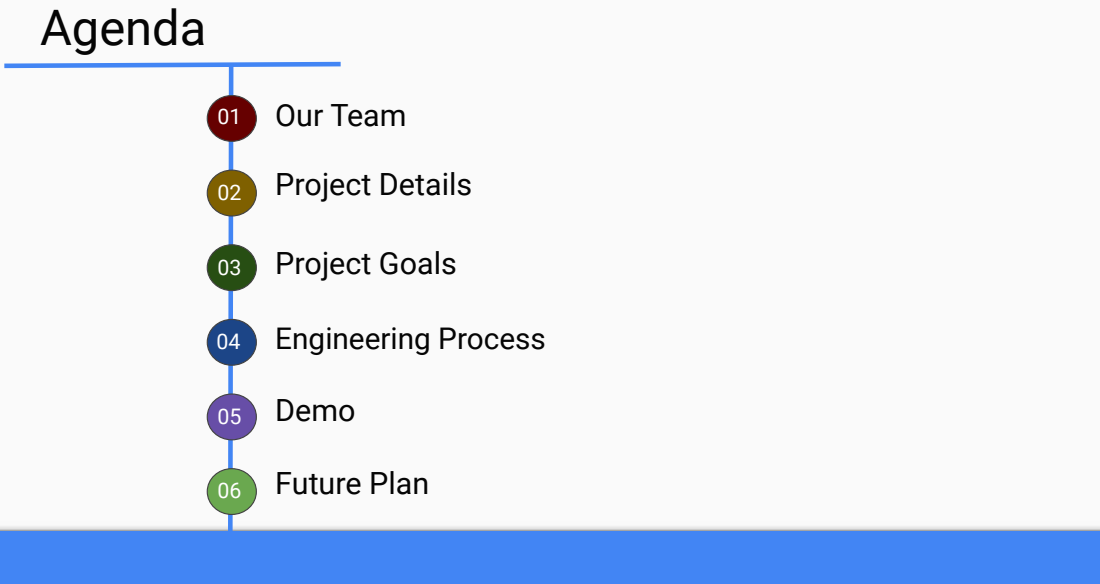
[picture p30: page 2]
Our Team; Project Details; Project Goals; Engineering Process; Demo; Future Plan

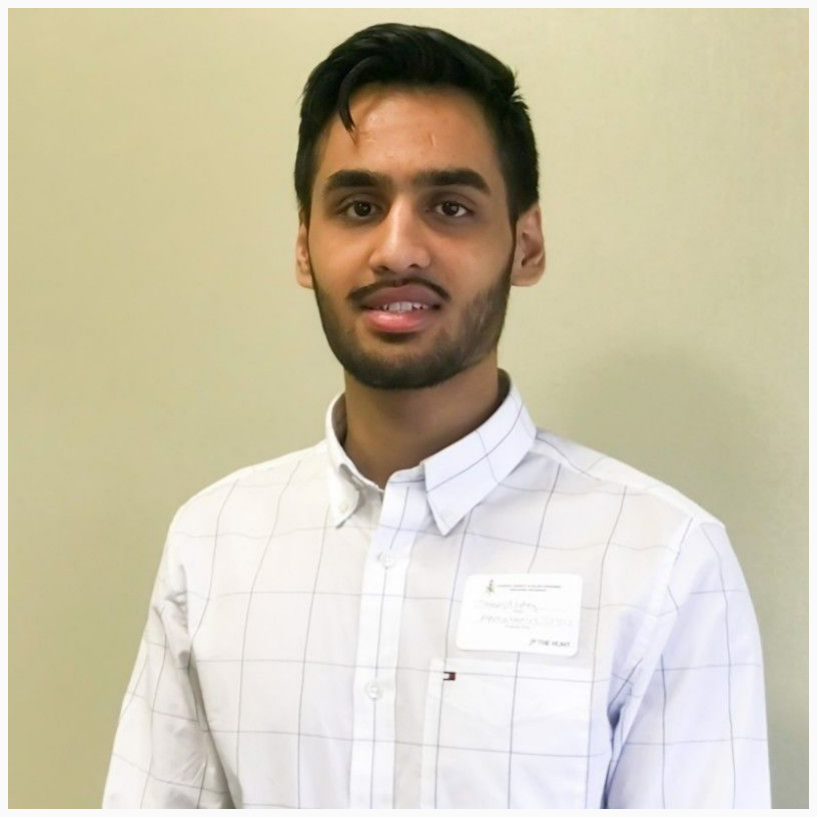
[picture p31: figure]

Taranjit Lotey

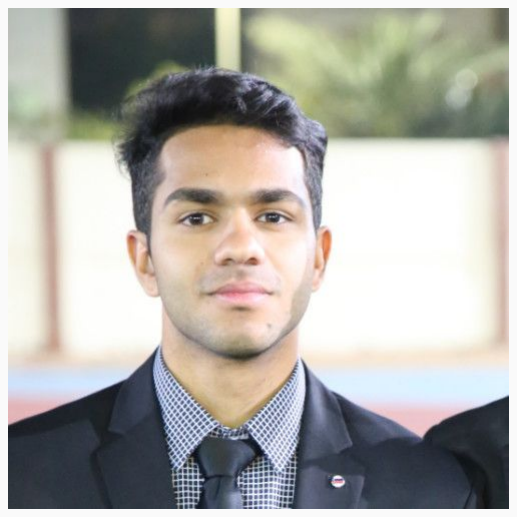
[picture p32: figure]
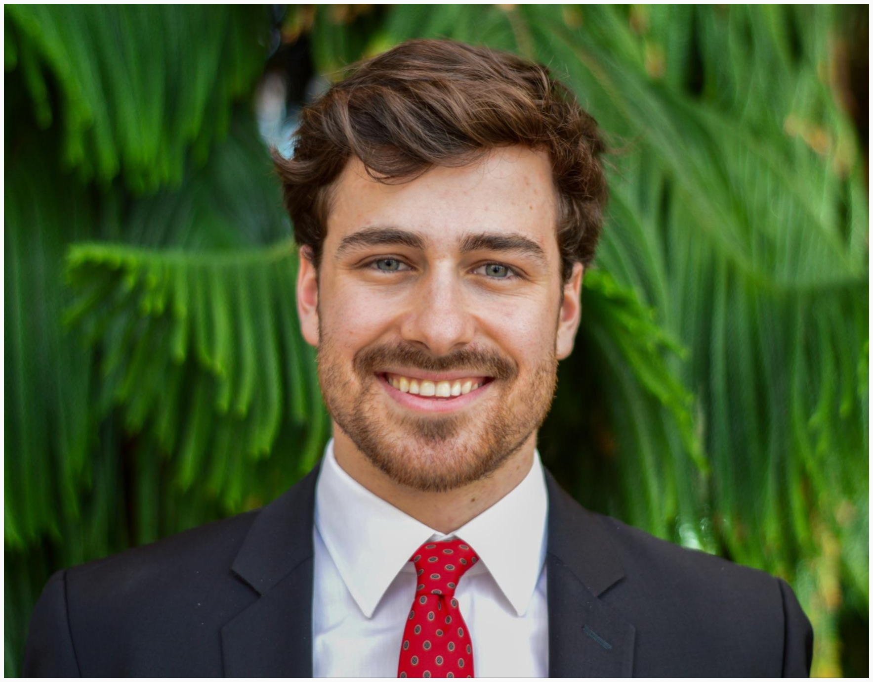
[picture p33: figure]
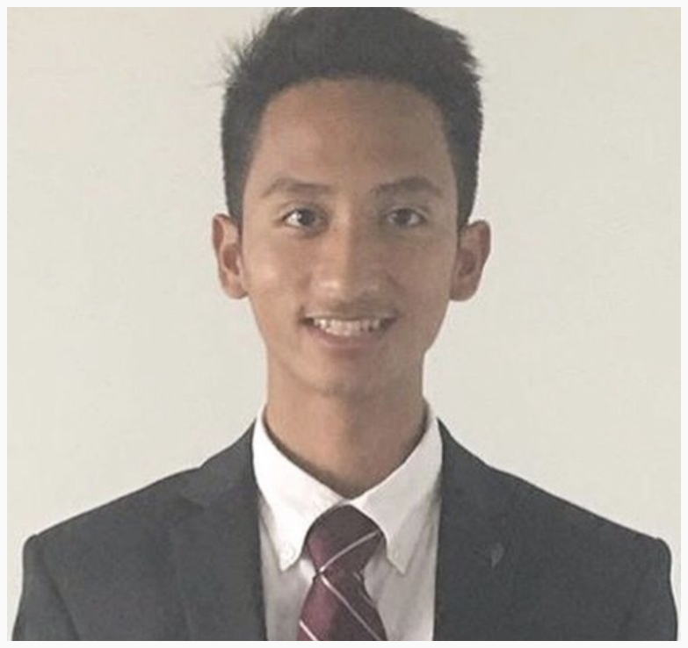
[picture p34: figure]

Jordan Bierbrier | Azriel Gingoyon | Udeep Shah

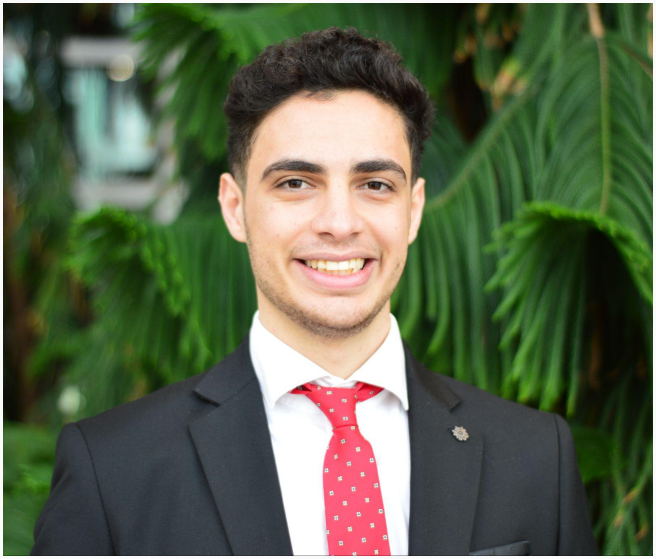
[picture p35: figure]

Abraham Taha

# Meet the Team!

# Problem

- Communication is crucial in daily life
- People who are Deaf or hard of hearing may struggle to recognize sounds in their environment
- Lead to missing important alerts / sounds
- Name called
- Fire alarm
- Doorbell

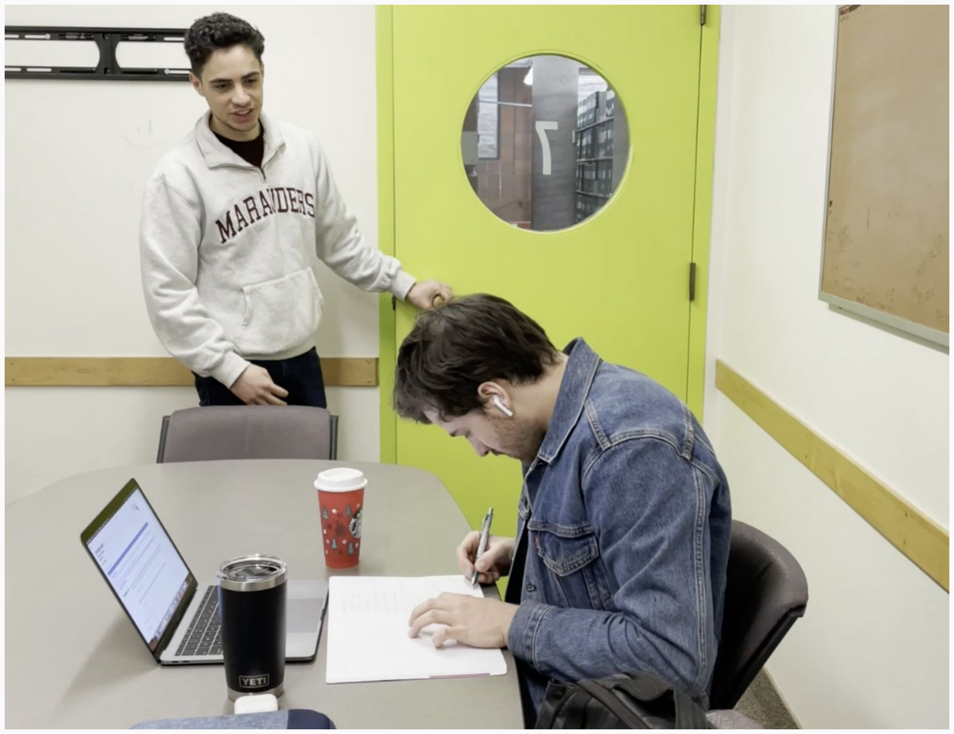
[picture p36: figure]
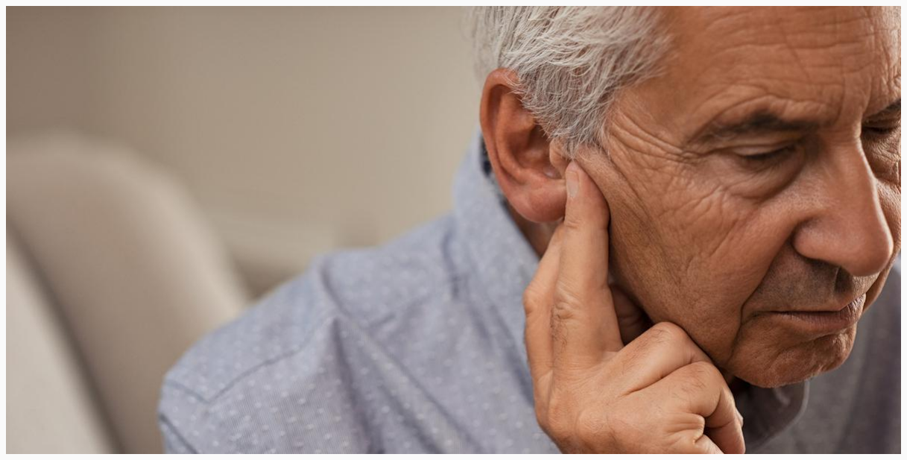
[picture p37: figure]

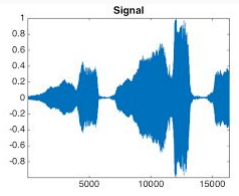
[picture p38: figure]

Create device that monitors environment for specific sound and alerts user (increase auditory awareness)

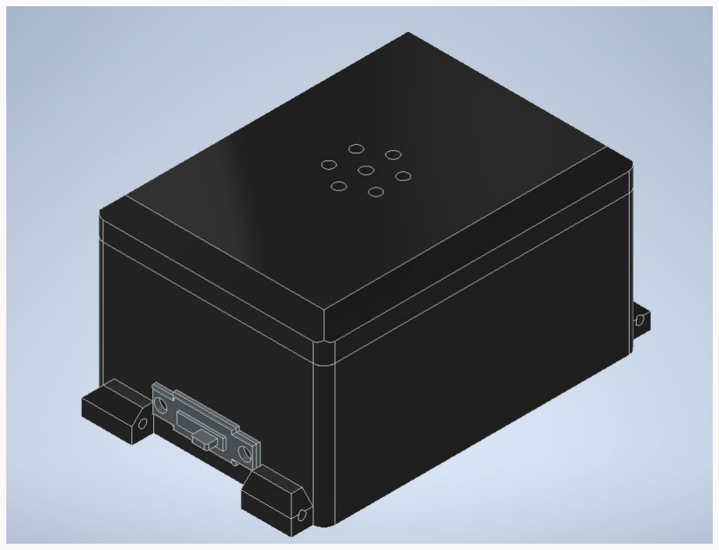
[picture p39: figure]

- Software → Sound Recognition
- Physical Device → Notification
- Application → Interface

# Abstract Solution

Preliminary Technologies

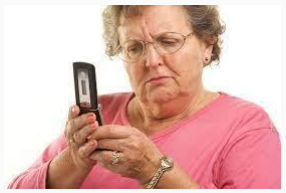
[picture p40: figure]

Project Goals | Inexpensive

## Portable

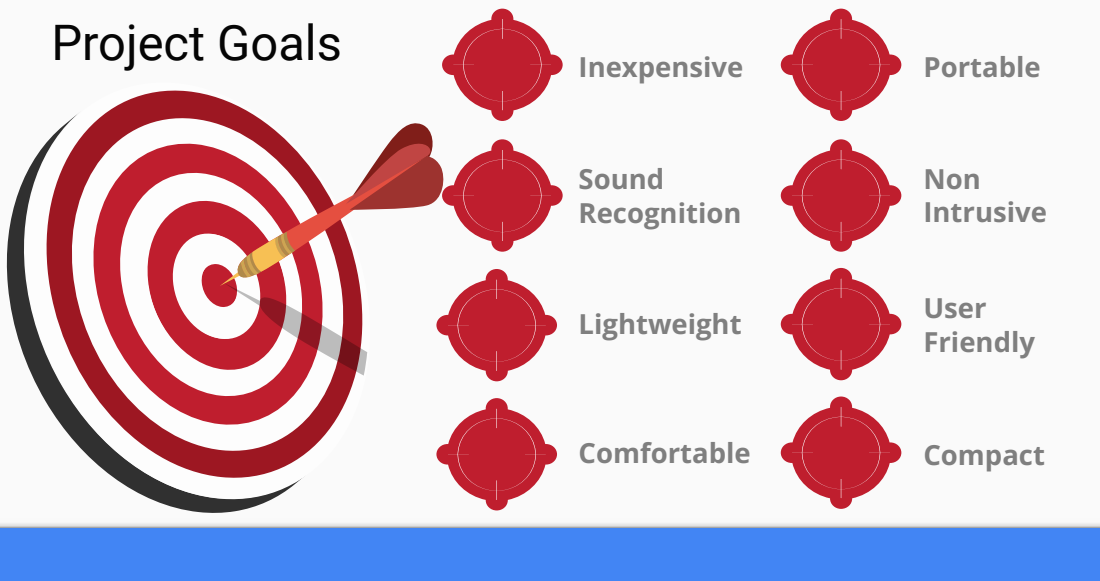
[picture p41: page 6]
Sound Recognition; Lightweight; Comfortable; Non Intrusive; User Friendly; Compact

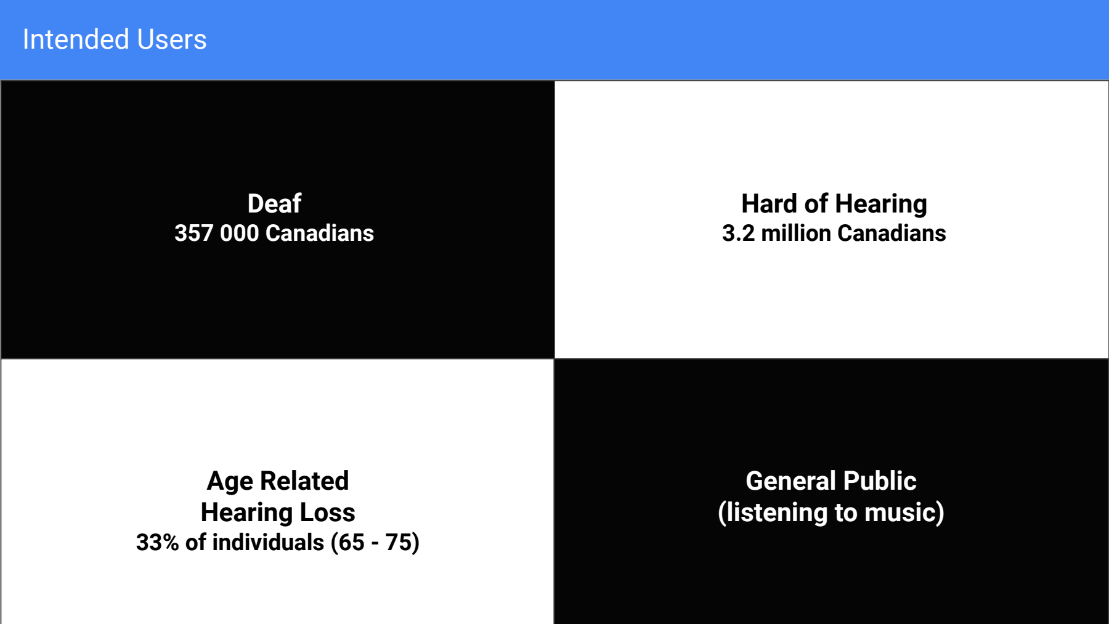
[picture p42: figure]
Intended Users; Hard of Hearing 3.2 million Canadians; Age Related Hearing Loss 33% of individuals (65 - 75); Deaf 357 000 Canadians; General Public (listening to music)

# The Engineering Process

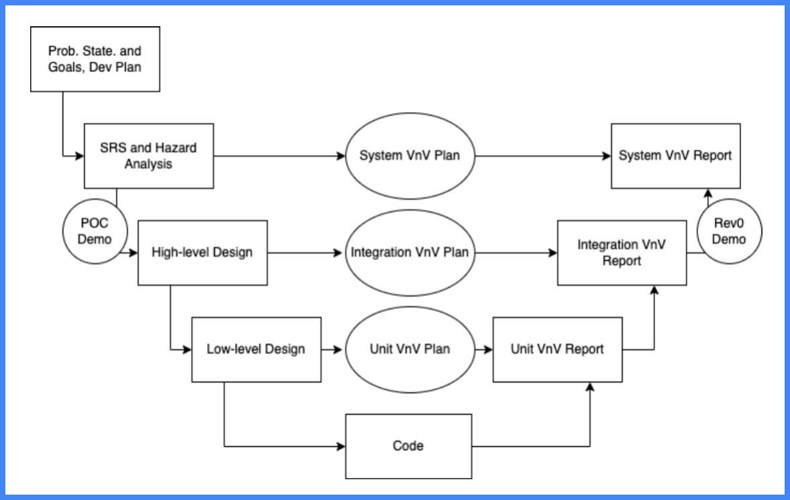
[picture p43: figure]

# Initial Stages

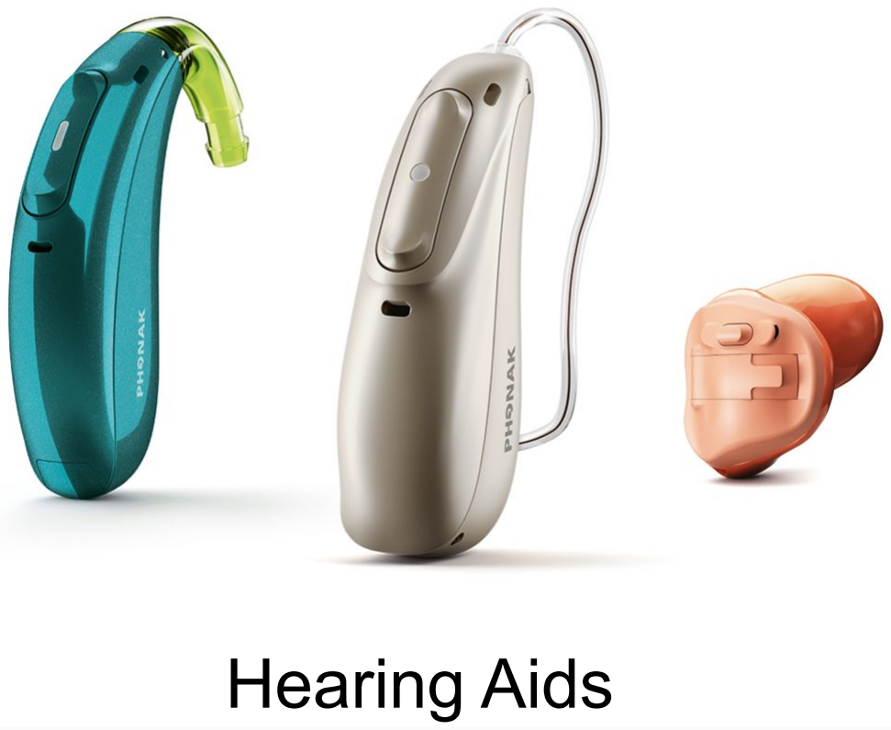
[picture p44: figure]
Hearing Aids
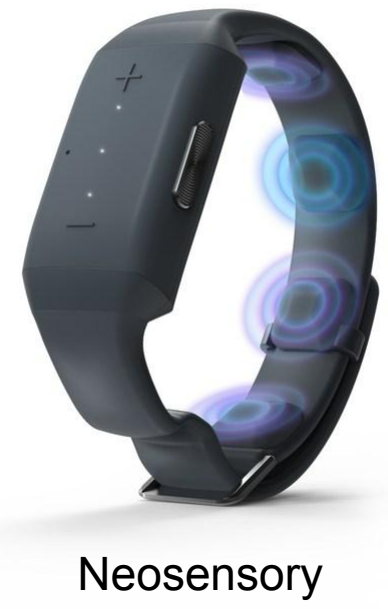
[picture p45: figure]
Neosensory

- Researched current solutions
- Spoke with relevant experts
- Katherine Hesson-Bolton
- Dr. Martin von Mohrenschildt
- Initial design decisions
- Classify specific sounds
- Mobile application for user interface
- Bracelet

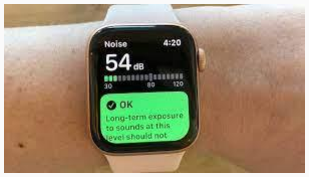
[picture p46: figure]

Apple Watch

# Proof-of-Concept

- Python script to extract MFCCs and detect sound
- Interactive Android App
- Feedback
- Real-Time Sound Processing
- Hardware
- Connectivity (via Bluetooth)

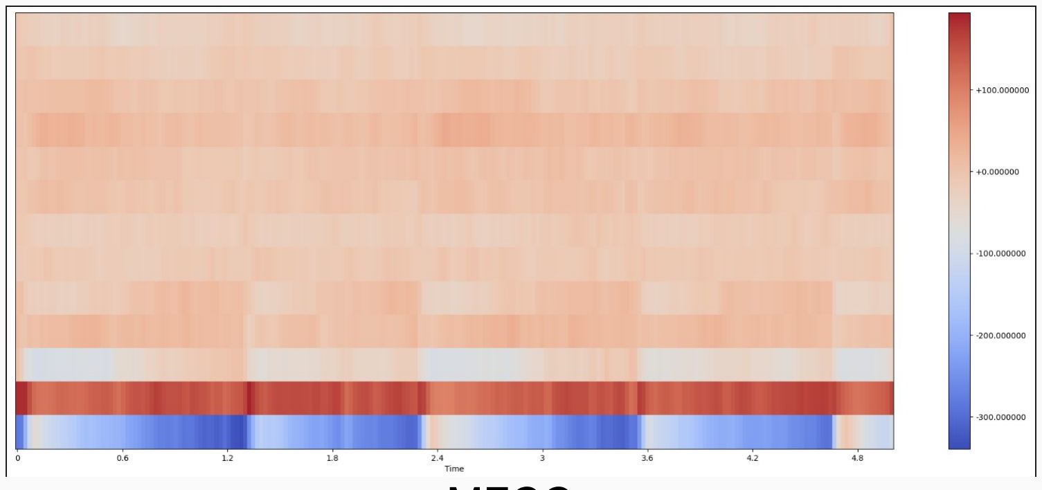
[picture p47: figure]

MFCCs

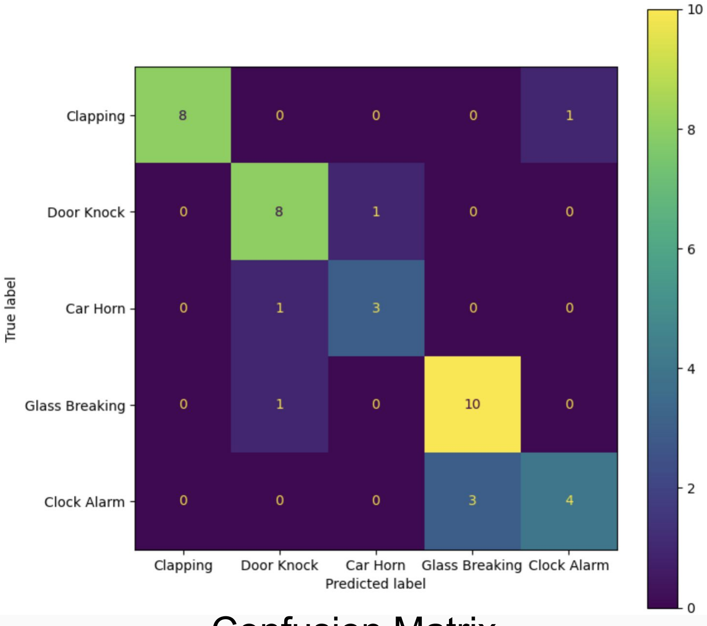
[picture p48: figure]

Confusion Matrix

# Physical Device (Component selection)

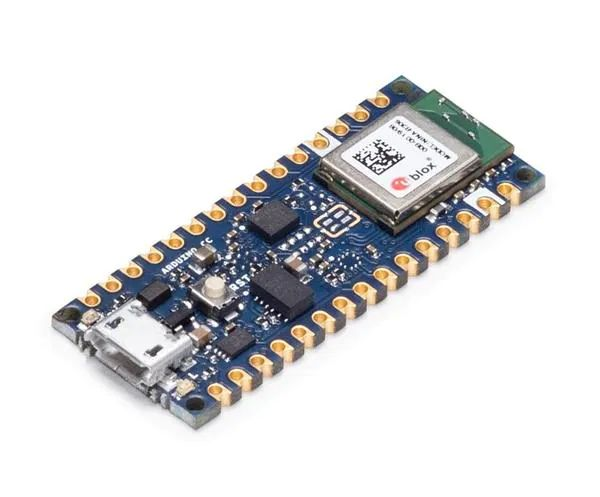
[picture p49: figure]

Arduino Nano BLE

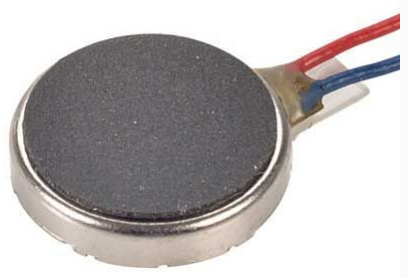
[picture p50: figure]

Vibration Motor

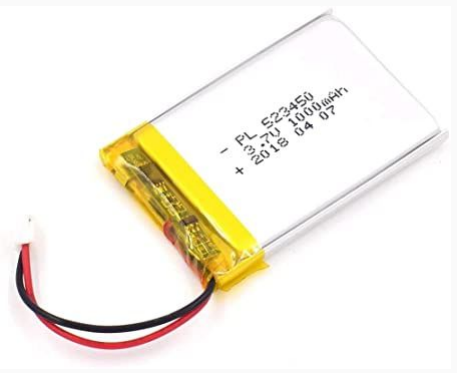
[picture p51: figure]

3.7V Lipo Battery

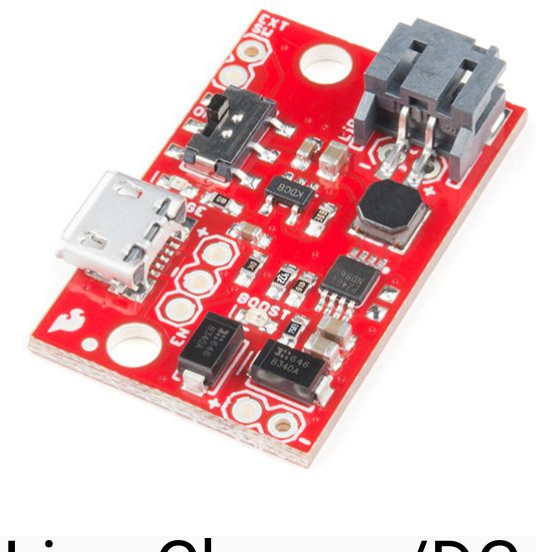
[picture p52: figure]

Lipo Charger/DC
Voltage Converter

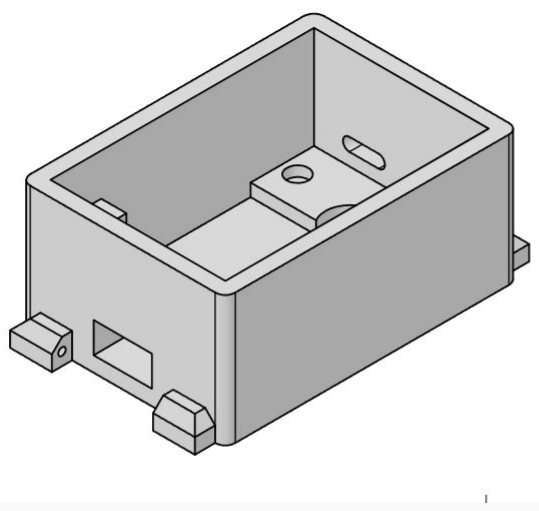
[picture p53: figure]

3D Printed PLA Enclosure

# Changes for Rev0

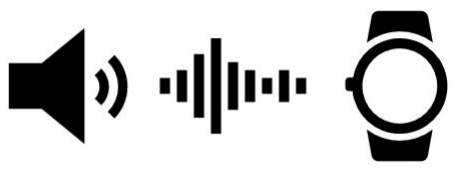
[picture p54: figure]

Sound processing to be done on the hardware

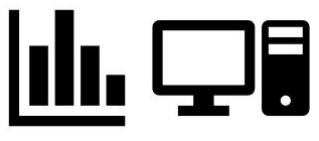
[picture p55: figure]

Training to be done externally

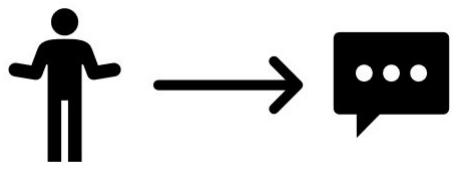
[picture p56: figure]

Speech-to-text eliminated

# Testing / Feedback

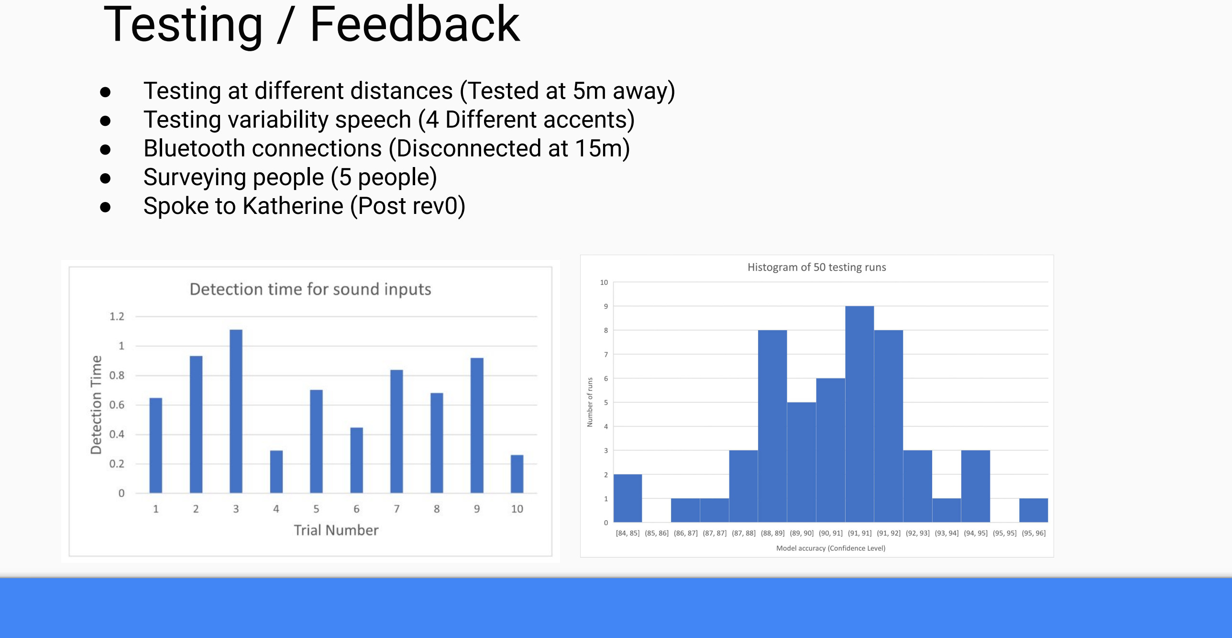
[picture p57: page 13]

- Testing at different distances (Tested at 5m away)
- Testing variability speech (4 Different accents)
- Bluetooth connections (Disconnected at 15m)
- Surveying people (5 people)
- Spoke to Katherine (Post rev0)

# The Current Solution

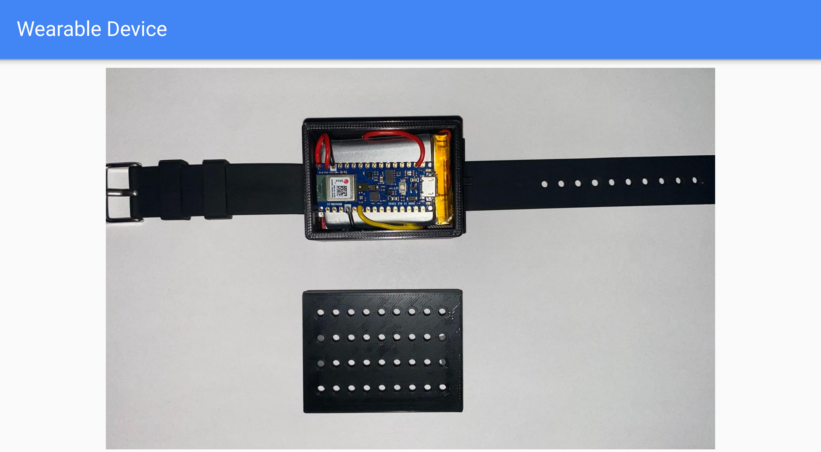
[picture p58: page 15]

Wearable Device

The Application

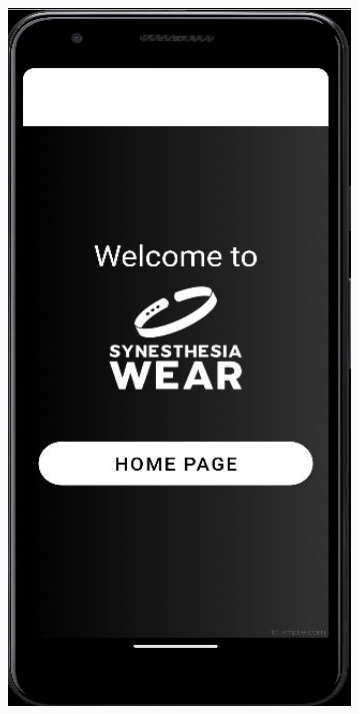
[picture p59: figure]

- Developed using Android Studio

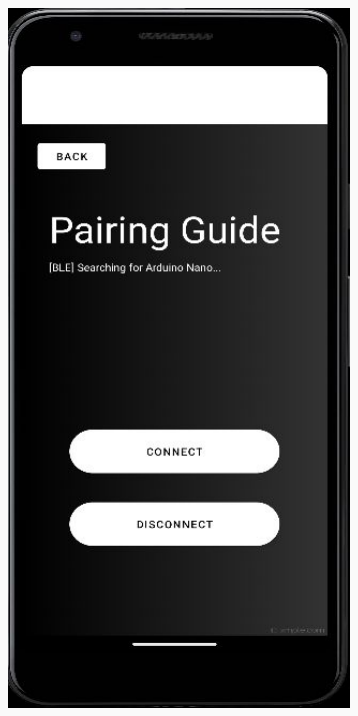
[picture p60: figure]
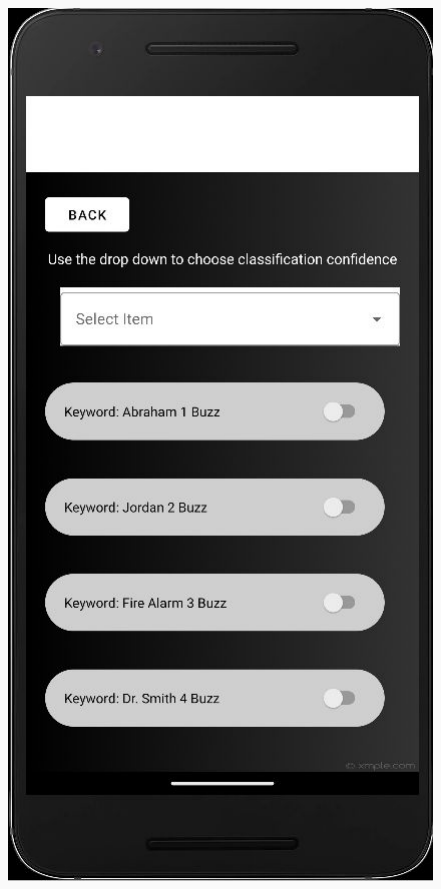
[picture p61: figure]

Home Page | Pairing | Keyword Selection
- | Written in Java | ● | Uses the in-platform Bluetooth Low Energy API

Audio Processing

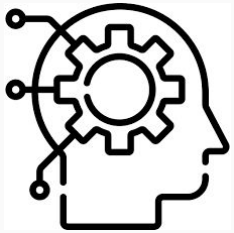
[picture p62: figure]

- Improved machine learning model (added early stopping in training)
- Added training samples (included new class)

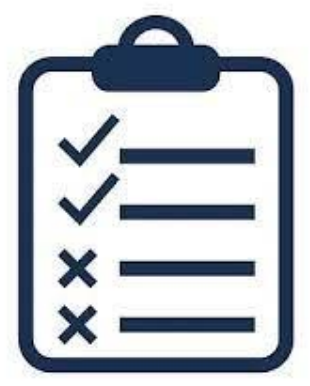
[picture p63: figure]
Make the device more compact

- Real-time confidence level change
- Training samples at farther distances

# Demo

## 8/10 Portability

$85

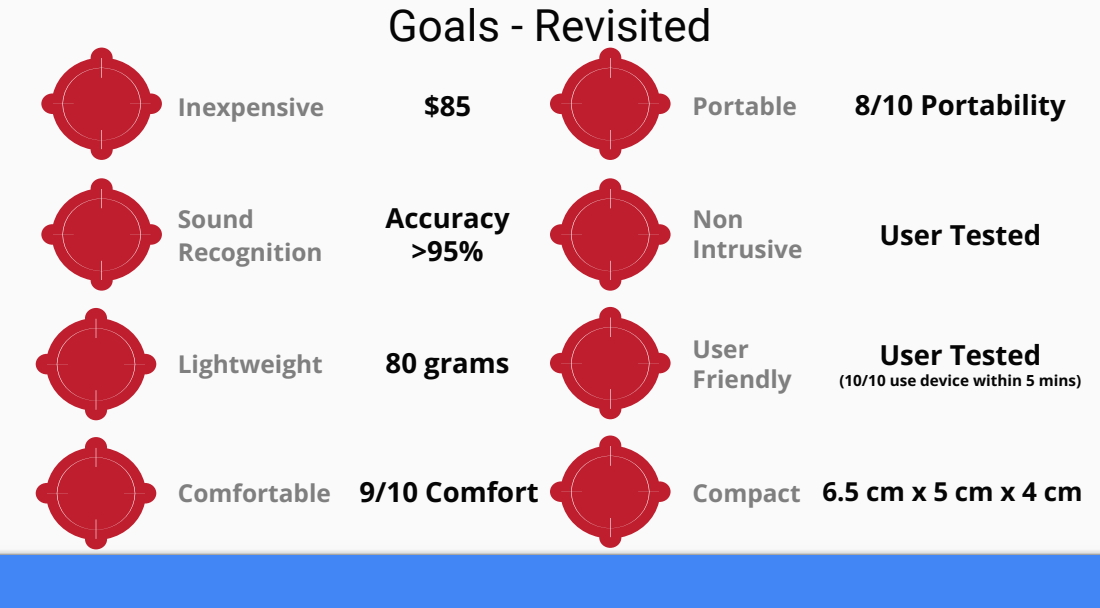
[picture p64: page 19]
Inexpensive; Sound Recognition; Lightweight; Comfortable 9/10 Comfort; Portable; Non Intrusive; User Friendly; Compact; User Tested; Accuracy >95%; 80 grams; Goals - Revisited

User Tested
(10/10 use device within 5 mins)

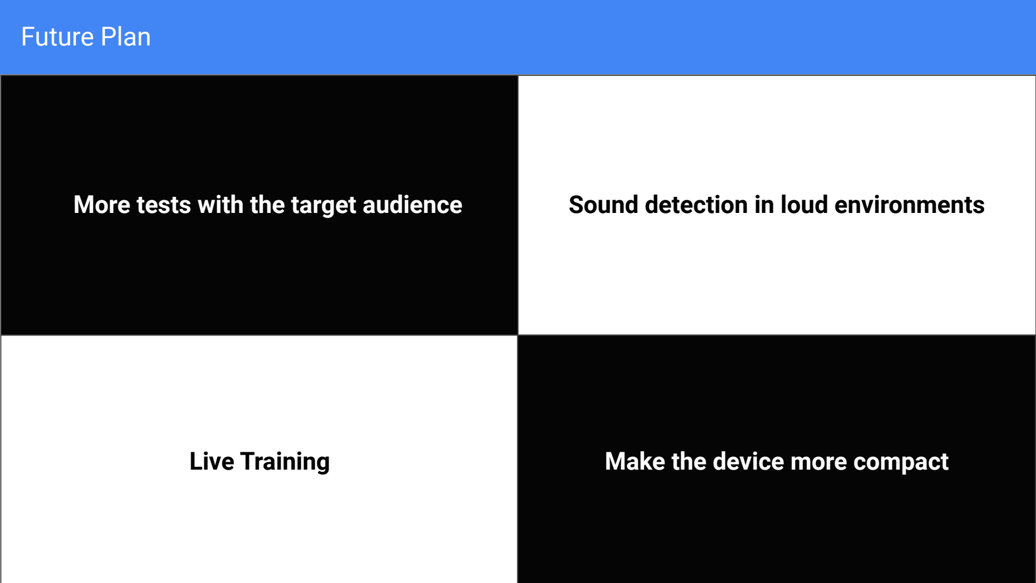
[picture p65: figure]
Future Plan; Sound detection in loud environments; Live Training; More tests with the target audience; Make the device more compact

# Thank You!

## Questions?
