jordanbierbrier/capstone/docs/Design/SystDesign/UserInterface2.pdf

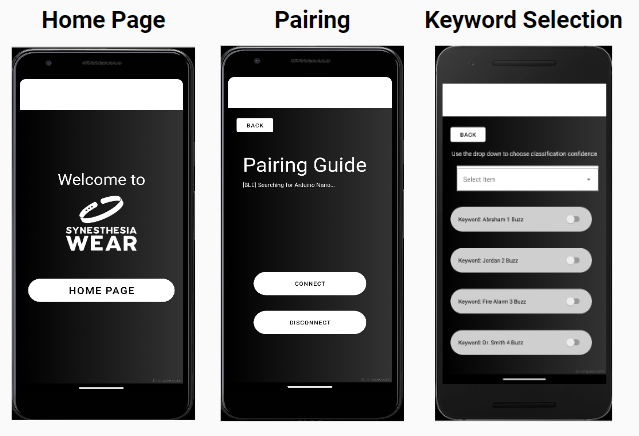
[picture p66: page 1]
