jordanbierbrier/capstone/docs/Design/SystDesign/ContextDiagram.pdf

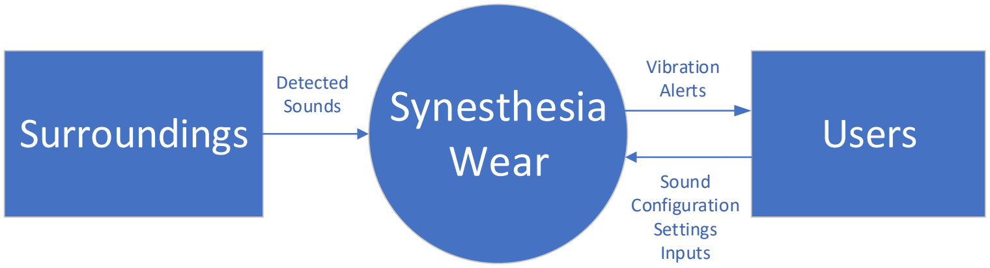
[picture p67: figure]
Synesthesia Wear Surroundings; Detected Sounds; Users; Vibration Alerts; Sound Configuration Settings Inputs
