jordanbierbrier/capstone/docs/Design/SystDesign/Communication.pdf

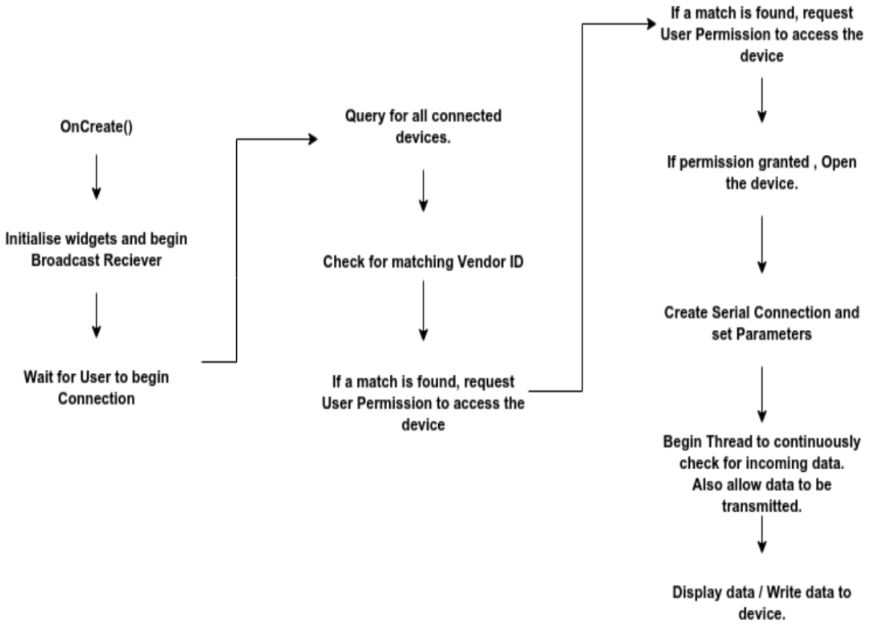
[picture p68: page 1]
