jordanbierbrier/capstone/docs/Design/SystDesign/Timeline.pdf

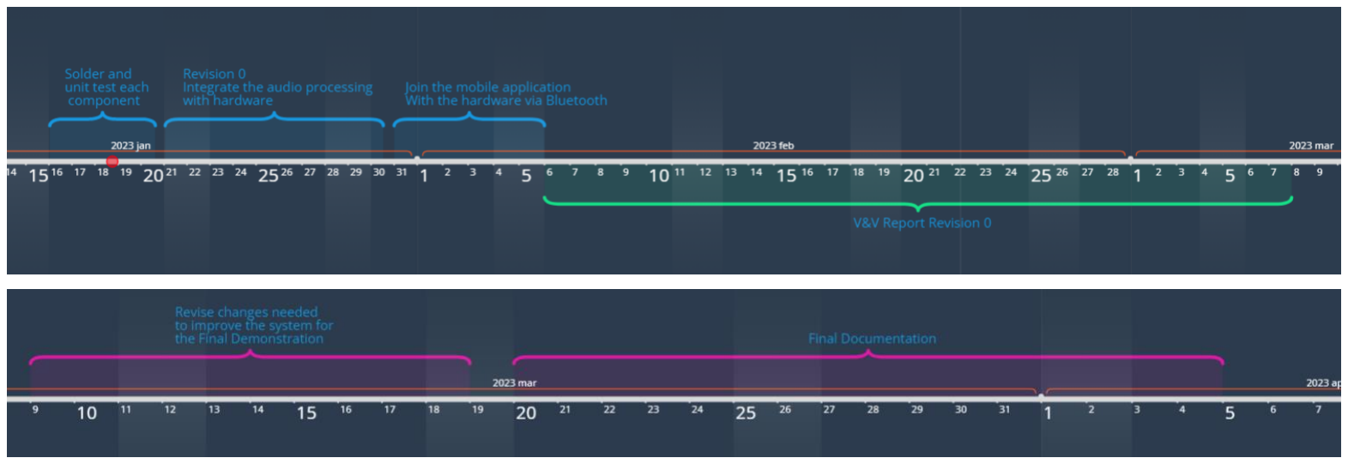
[picture p69: page 1]
