jordanbierbrier/capstone/docs/Design/SystDesign/UserInterface.pdf

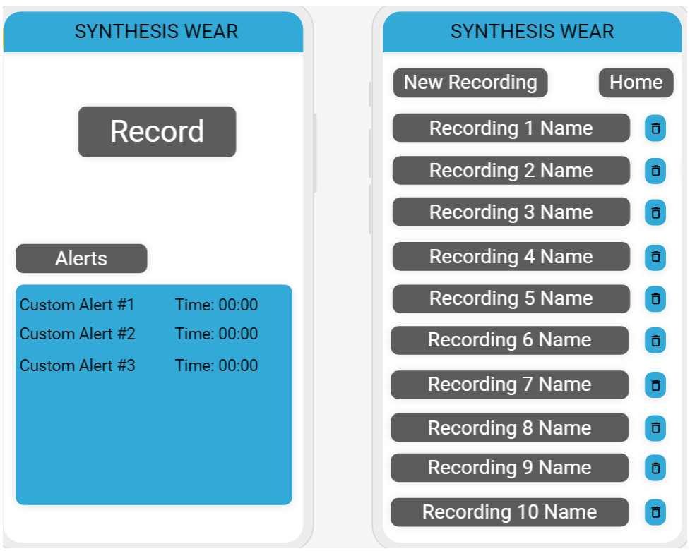
[picture p70: figure]
