jordanbierbrier/capstone/docs/SRS/P-diagram.pdf

Requirement | Phase In Dat e | Priority ✓ ✓ ✓ | ✓ ✓ | ✓
1 FR - | October 31st 202 2 | ✓ ✓ ✓
2 FR - | November 3rd 202 2 | ✓ ✓ ✓
FR -3 | nd 2022 December 2 | ✓ ✓
4 FR - | November 5th 2022 | ✓ ✓ ✓
5 FR - | November 9th 2022 | ✓ ✓ ✓
1 NFR - | January 24th 2022 | ✓ ✓
NFR -2 | January 2 6 th 2022 | ✓ ✓
NFR -3 | February 10th 2022 | ✓ ✓
NFR -4 | February 10th 2022 | ✓ ✓
NFR -5 | March 1 st 2022 | ✓
NFR -6 | January 26th 2022 | ✓ ✓
NFR -7 | March 1st 2022 | ✓ ✓
NFR -8 | January 31st | ✓ ✓ ✓
NFR -9 | February 2 1 st 2022 | ✓ ✓ ✓
NFR -10 | March 1 st 2022 | ✓
NFR -11 | February 28th | ✓ ✓ ✓
NFR -12 | March 1st 2022 | ✓
NFR -13 | February 17th 2022 | ✓ ✓
NFR -14 | February 17th 2022 | ✓ ✓
NFR -15 | March 10th | ✓
NFR -16 | N/ A | ✓
-17 NFR | March 1st 2022 | ✓ ✓ ✓
NFR -18 | st 2022 March 1 | ✓ ✓ ✓
NFR -19 | N/A | ✓
NFR -20 | N/A | ✓
NFR -21 | March 10th 2022 | ✓ ✓
-22 NFR | March 1st 2022 | ✓ ✓ ✓
NFR -23 | th 2022 December 1 0 | ✓ ✓ ✓
-24 NFR | March 1st 2022 | ✓
NFR -25 | March 5th 2022 | ✓ ✓
NFR -26 | October 31st 2022 | ✓ ✓ ✓
NFR -27 | October 31st 2022 | ✓ ✓ ✓
NFR -28 | November 11th 2022 | ✓ ✓
