jordanbierbrier/capstone/docs/Checklists/ProbState-Checklist.pdf

# Problem Statement and Goals Checklist

### Spencer Smith

### September 20, 2022

- The source for the document

The source is text-based, like LATEX, or markdown, or emaccs org mode, etc.

- Follows writing checklist (https://github.com/smiths/capTemplate/blob/main/docs/Checklists/Writing-Checklist.pdf)
- Overall qualities of documentation

Scope is clear

Document is abstract (for instance, it does not mention the programming language (unless this is a true constraint) or the algorithm choices (unless the algorithm is the “what” rather than the “how”))

Output of software is unambiguous

Inputs to software are unambiguous

Document is simple (for instance, there is no need for a table of contents)

Stakeholders are clearly identified

Environment is clearly identified

Importance of the problem is convincingly stated

Goals provide selling features of the product

Goals are measurable

1
