jordanbierbrier/capstone/docs/VnVReport/confusion_matrix.png

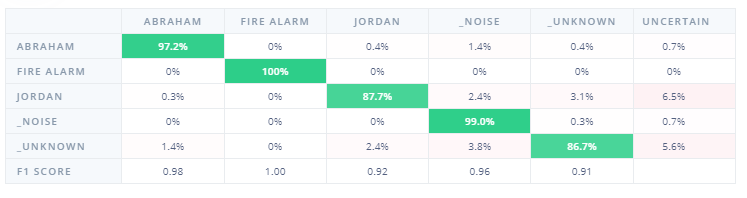
docs/VnVReport/confusion_matrix.png
