jordanbierbrier/capstone/docs/Design/SystDesign/ComponentDiagram.pdf

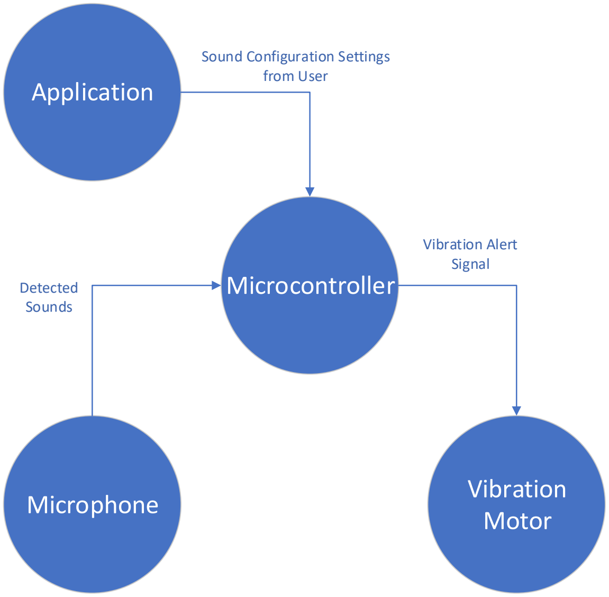
[picture p72: figure]
Microcontroller; Vibration Motor; Application; Microphone; Sound Configuration Settings from User; Detected Sounds; Vibration Alert Signal
