jordanbierbrier/capstone/docs/HazardAnalysis/HazardAnalysis.tex

\documentclass[12pt, titlepage]{article}

\usepackage{booktabs}
\usepackage{tabularx}
\usepackage{hyperref}
\usepackage{pdflscape}
\usepackage[table,xcdraw]{xcolor}
\usepackage{float}
\usepackage{longtable}
\usepackage{multirow}
\usepackage{graphicx}
\usepackage{vcell}
\usepackage{ulem}
\usepackage[margin=1in]{geometry}
\hypersetup{
    colorlinks=true,       % false: boxed links; true: colored links
    linkcolor=red,          % color of internal links (change box color with linkbordercolor)
    citecolor=green,        % color of links to bibliography
    filecolor=magenta,      % color of file links
    urlcolor=cyan           % color of external links
}
\usepackage[round]{natbib}

\input{../Comments}
\input{../Common}

\begin{document}

\title{Hazard Analysis: \progname} 
\author{\authname}
\date{\today}
	
\maketitle

\pagenumbering{roman}

\section*{Revision History}

\begin{tabularx}{\textwidth}{p{3cm}p{2cm}X}
\toprule {\bf Date} & {\bf Version} & {\bf Notes}\\
\midrule
10/14/2022 & 1.0 & Added sections 1, 2, and 3\\
10/19/2022 & 1.1 & Worked on Sections 5 / General Editing\\
4/4/2023 & 1.2 & Updated according to Feedback and Formated Table\\
\bottomrule
\end{tabularx}

\newpage

\tableofcontents

\listoffigures

\listoftables

\newpage

\section*{Symbols, Abbreviations and Acronyms}

\renewcommand{\arraystretch}{1.2}
\begin{tabular}{l l} 
  \toprule		
  \textbf{symbol} & \textbf{description}\\
  \midrule 
  Age groups & (15-30, 31-50, 51-75, 75+)\\
  \bottomrule
\end{tabular}\\

\newpage

\pagenumbering{arabic}

\section{Introduction}
This document is the hazard analysis for the entirety of Synesthesia Wear.
For context, Synesthesia Wear is an inexpensive and non-intrusive \sout{hearing aid} 
wearable device with a purpose of improving \sout{quality of life by providing users} \textcolor{red}{the users' auditory awareness} with 
an alternate channel for sound recognition within their surroundings. Furthermore, 
this wearable device will have a corresponding application that will be made to be 
user-friendly so that users can easily access and configure their wearable devices to 
whatever settings they so desire. Lastly, for the purposes of this document, the 
Synesthesia Wear developers believe that the definition of a hazard is one that is 
derived from Nancy Leveson's work. With that in mind, a hazard is any property or 
condition within the Synesthesia Wear system where after pairing up with any 
conditions in the environment, a potential for loss to the system now exists.

\section{Scope and Purpose of Hazard Analysis}
The scope of this document is to identify any and all possible hazards within 
the system, clarify the mitigation steps of each identified hazard, determine 
the causes and effects of all failures, and define all safety and security requirements 
that have resulted from the overall analysis.

\section{System Boundaries and Components}
The hazard analysis will be conducted on the Synesthesia Wear system which will be 
comprised of the following components:
\begin{enumerate}
    \item The wearable device consists of:
    \begin{enumerate}
        \item Vibration Motor
        \item Microphone
        \item Microcontroller
        \item Bluetooth module
        \item \textcolor{red}{Battery}
    \end{enumerate}
    \item The Application to be installed on the users' devices consists of:
    \begin{enumerate}
        \item User Interface
        \item Wearable device Settings Configuration
    \end{enumerate}
    \item The Device that runs the application
    \begin{enumerate}
        \item Operating System
    \end{enumerate}
\end{enumerate}

\noindent With the above in mind, the system boundary is limited to the above 3 components with 
each having their own respective subcomponents. Furthermore, it is important to note 
that not all components in the above list can be controlled (i.e. Device's Operating 
System) by the Synesthesia Wear developers. However, these components still needed to 
be listed down in the system boundary as the potential for a hazard can still be 
correlated to them.

\section{Critical Assumptions}

CA1. The battery will not need to be replaced during product lifespan.
\\CA2. Signal input devices will be consistent with the results they produce.
\\CA3. Software application failure will not diminish usage of product.
\\CA4. The microphone is not blocked and has full access to the environment. 
\\ \textcolor{red}{CA5. The device will be used in indoor conditions.}

\section{Failure Mode and Effect Analysis}
\textcolor{red}{Put the table in landscape mode}

\begin{landscape}
\begin{table}[H]
\centering
	
    \begin{tabular}{| p{0.1\textwidth} | p{0.08\textwidth}  | p{0.12\textwidth} | p{0.145\textwidth} | p{0.17\textwidth} | p{0.19\textwidth} | p{0.11\textwidth} | p{0.07\textwidth} | p{0.06\textwidth} |}
    \hline
    
    \multicolumn{9}{|l|}{System: Wearable Device} \\
    \multicolumn{9}{|l|}{Phase/Mode: System Requirements} \\ \hline
    \textbf{Sub-System} & \textbf{Design Function} & \textbf{Failure Mode} & \textbf{Effects of Failure} & \textbf{Causes of Failure} & \textbf{Recommended Actions} & \textbf{Risk Priority Number (RPN)} & \textbf{Safety Requirement} & \textbf{Ref} \\ \hline

    Battery & Power the various components of the device  & Battery stops delivering power to the device & Device loses all functionalities & \sout{1.Battery was not charged} \newline 1.Battery fails and stops holding charge \newline 2.Battery gets disconnected from the controller \newline \textcolor{red}{3.Battery was not charged} & 1.Inform users of best charging practices to avoid battery failure i.e (only charge to 80\%, don't leave it plugged in when battery is full etc.) \newline 2.Microcontroller should throw error code if it detects battery disconnection \newline 3.Have CMOS battery in the Micocontroller incase of power loss & Severity: 10 \newline Occurrence Likelihood: 3 \newline Detection Likelihood: 1 \newline Total: 30 & SIR4, SIR2 & H1-1 \\ \cline{1-9}
    
    \end{tabular}

    \caption{Wearable Device Failure Modes and Effects Analysis}

\end{table}
    
\begin{table}[H]
    \centering
        %\caption[] {Continuation Wearable Device Failure Modes and Effects Analysis}

        \begin{tabular}{| p{0.11\textwidth} | p{0.08\textwidth}  | p{0.12\textwidth} | p{0.145\textwidth} | p{0.17\textwidth} | p{0.19\textwidth} | p{0.1\textwidth} | p{0.07\textwidth} | p{0.06\textwidth} |}
        \hline
        
        \multicolumn{9}{|l|}{System: Wearable Device} \\
        \multicolumn{9}{|l|}{Phase/Mode: System Requirements} \\ \hline
        \textbf{Sub-System} & \textbf{Design Function} & \textbf{Failure Mode} & \textbf{Effects of Failure} & \textbf{Causes of Failure} & \textbf{Recommended Actions} & \textbf{RPN} & \textbf{SR} & \textbf{Ref} \\ \hline

        Battery & Power the various components of the device & Battery supplies incorrect power & Devices may lose some functionality or may work incorrectly. The internal components may get damaged & 1.Battery Failure \newline 2.Low charge in the battery \newline 3.Issue in the battery management system (BMS) & 1.Hardware should be able to cut off the battery in case of excess current draw \newline 2.Microcontroller can signal the user in case of low battery & Total: 32 & SIR2 & H1-2 \\ \cline{3-9}

        & &  Battery overheats & 1.Device container can melt \newline 2.Battery can melt other components of wearable device \newline 3.Burn the user \newline 4.Damage future battery performance & 1.Device operates in temperatures outside the operating conditions of the battery \newline 2.Battery failure \newline 3.Excessive current draw \newline 4.Loose connections  & 1.Insure proper cooling or heat dissipation of the microcontroller \newline 2.Refer to H1-2 \sout{a} \textcolor{red}{1)} \newline 3.Install a battery that can operate in the working conditions of the device \newline 4.refer to H1-1 \sout{b} \textcolor{red}{2)} & Total: 40 & SIR3 & H1-3 \\ \hline

        \end{tabular}

        \vspace*{0.3cm}
        Table 1 Continued: Wearable Device Failure Modes and Effects Analysis
\end{table}

\begin{table}[H]
    \centering
        \begin{tabular}{| p{0.11\textwidth} | p{0.08\textwidth}  | p{0.12\textwidth} | p{0.145\textwidth} | p{0.17\textwidth} | p{0.19\textwidth} | p{0.1\textwidth} | p{0.07\textwidth} | p{0.06\textwidth} |}
        \hline
        
        \multicolumn{9}{|l|}{System: Wearable Device} \\
        \multicolumn{9}{|l|}{Phase/Mode: System Requirements} \\ \hline
        \textbf{Sub-System} & \textbf{Design Function} & \textbf{Failure Mode} & \textbf{Effects of Failure} & \textbf{Causes of Failure} & \textbf{Recommended Actions} & \textbf{RPN} & \textbf{SR} & \textbf{Ref} \\ \hline
    
        Microphone & Sound detection & Sound is not detected & \sout{Device is not able to perform the primary function}\textcolor{red}{Device is unable to receive sounds}  & 1.Loose connections \newline 2.Microphone is damaged  & 1.Microcontroller can throw an error code in case of microphone disconnect \newline 2.User can check the microphone output on the app to see if it is functioning correctly & Total: 30  & IR6  & H2-1 \\ \cline{3-9}
    
         & & Sound is falsely detected & Device functions incorrectly & 1.Loose connections \newline 2.Microphone is damaged & 1.Refer to H2-1 \sout{b} \textcolor{red}{1)} \newline \textcolor{red}{2.Refer to H2-1 2)} & Total: 80 & IR6 & H2-2 \\ \hline
     
        \end{tabular}

        \vspace*{0.3cm}
        Table 1 Continued: Wearable Device Failure Modes and Effects Analysis
\end{table}

\begin{table}[H]
    \centering
        \begin{tabular}{| p{0.11\textwidth} | p{0.08\textwidth}  | p{0.12\textwidth} | p{0.145\textwidth} | p{0.17\textwidth} | p{0.19\textwidth} | p{0.1\textwidth} | p{0.07\textwidth} | p{0.06\textwidth} |}
            \hline
        
        \multicolumn{9}{|l|}{System: Wearable Device} \\
        \multicolumn{9}{|l|}{Phase/Mode: System Requirements} \\ \hline
        \textbf{Sub-System} & \textbf{Design Function} & \textbf{Failure Mode} & \textbf{Effects of Failure} & \textbf{Causes of Failure} & \textbf{Recommended Actions} & \textbf{RPN} & \textbf{SR} & \textbf{Ref} \\ \hline
    
         Bluetooth Module & Provide a communication stream between mobile phone and wearable device & Mobile device loses connection with  bluetooth module & 1.Sound processing capabilities are lost \newline 2.Vibration motor wont receive signal to provide/not provide haptic feedback  & 1.Signal between mobile phone and  device is lost due to higher than rated distances \newline 2.Signal is blocked due to external factors such as a faraday cage \newline 3.Other signals such as wifi, microwave etc. cause interference with bluetooth signal \newline 4.Connected phone loses power  & 1.Provide a notification to the user when the signal strength is diminished \newline 2.Include auto-reconnection with the device and phone when signal is found \newline 3.Ensure final design of the product has adequate clearing for the bluetooth antennas such that it maximizes signal strength \newline \textcolor{red}{4.Refer to H3-1 1)}  &  Total: 20 & \sout{NFR8} \textcolor{red}{IR8} & H3-1 \\ \cline{1-9}
        
        \end{tabular}

        \vspace*{0.3cm}
        Table 1 Continued: Wearable Device Failure Modes and Effects Analysis
\end{table}

\begin{table}[H]
    \centering

        \begin{tabular}{| p{0.11\textwidth} | p{0.08\textwidth}  | p{0.12\textwidth} | p{0.145\textwidth} | p{0.17\textwidth} | p{0.19\textwidth} | p{0.1\textwidth} | p{0.07\textwidth} | p{0.06\textwidth} |}
            \hline
        
        \multicolumn{9}{|l|}{System: Wearable Device} \\
        \multicolumn{9}{|l|}{Phase/Mode: System Requirements} \\ \hline
        \textbf{Sub-System} & \textbf{Design Function} & \textbf{Failure Mode} & \textbf{Effects of Failure} & \textbf{Causes of Failure} & \textbf{Recommended Actions} & \textbf{RPN} & \textbf{SR} & \textbf{Ref} \\ \hline

        Bluetooth Module & Provide a communication stream between mobile phone and wearable device & Invalid message & \sout{1.}Unexpected or incorrect output from device & 1.Message corrupted during transmission \newline 2.Message corrupted during reception & 1.Add a checksum into the bluetooth signal to check for message integrity \newline 2.Only accept predefined messages, discard foreign/ undefined messages & Total: 15 & IR7 & H3-2 \\ \hline
         
        Vibration Motor & Provide haptic notification to user & Vibrations not noticeable by user & \sout{1.}User does not get alerted & 1.Not enough power supplied & 1.User can calibrate the intensity of the motor & Total: 7 & ACR1 & H4-1 \\ \cline{3-9}
    
         & & Motor does not vibrate & \sout{1.}User does not get alerted & 1.Loose connections \newline 2.Defective vibration motor  & 1.Microcontroller can signal the user in case of motor disconnect \newline 2.Refer to  H4-2 \textcolor{red}{1)} & Total: 20 & SIR4 & H4-2 \\ \cline{1-9}
     
        \end{tabular}

        \vspace*{0.3cm}
        Table 1 Continued: Wearable Device Failure Modes and Effects Analysis

\end{table}

\begin{table}[H]
    \centering
        \begin{tabular}{| p{0.11\textwidth} | p{0.08\textwidth}  | p{0.12\textwidth} | p{0.145\textwidth} | p{0.17\textwidth} | p{0.19\textwidth} | p{0.1\textwidth} | p{0.07\textwidth} | p{0.06\textwidth} |}
            \hline
        
        \multicolumn{9}{|l|}{System: Wearable Device} \\
        \multicolumn{9}{|l|}{Phase/Mode: System Requirements} \\ \hline
        \textbf{Sub-System} & \textbf{Design Function} & \textbf{Failure Mode} & \textbf{Effects of Failure} & \textbf{Causes of Failure} & \textbf{Recommended Actions} & \textbf{RPN} & \textbf{SR} & \textbf{Ref} \\ \hline
         
        Vibration Motor & Provide haptic notification to user &  Incorrect vibration & \sout{1.}User incorrectly identifies the sound & 1.Defective vibration motor & 1.User can calibrate the vibration intensity and check the output  & Total: 18 & SIR4 & H4-3 \\ \cline{3-9}
     
         & & Vibration too intense & \sout{1.}Painful or annoying to the user & 1.Motor drawing excess current & \sout{1.Refer to H4-3 \newline 2.}\textcolor{red}{1.}Hardware connection is current limited & Total: 8 & ACR1 & H4-4 \\ \hline
     
         Signal Processing & Classify sound & Sound is incorrectly classified & 1.Incorrectly notify user about sound \newline 2.No notification for detected sound & 1.Insufficient training data \newline 2.Model parameters not fully optimized \newline 3.Outlier sound received  & 1.User can help with calibration by adding more samples \newline \textcolor{red}{2.Add more model training samples for better optimization} \newline \sout{2.} \textcolor{red}{3.}Filter outlier noise  & Total: 168 & \sout{ACR2}, IR6 & \sout{S1-1} \textcolor{red}{H5-1} \\ \cline{3-9}
    
     & & Sound is not classified & \sout{1.}No notification for detected sound & 1.Error/bug with signal processing code & 1.Refer to \sout{S1-1 a} \textcolor{red}{H5-1 1)} & Total: 105 & IR6 & \sout{S1-2} \textcolor{red}{H5-2} \\ \hline

        \end{tabular}

        \vspace*{0.3cm}
        Table 1 Continued: Wearable Device Failure Modes and Effects Analysis
\end{table}

\begin{table}[H]	
    \centering
    \begin{tabular}{| p{0.11\textwidth} | p{0.08\textwidth}  | p{0.12\textwidth} | p{0.145\textwidth} | p{0.17\textwidth} | p{0.19\textwidth} | p{0.1\textwidth} | p{0.07\textwidth} | p{0.06\textwidth} |}
        \hline
    
    \multicolumn{9}{|l|}{System: Mobile Application } \\
    \multicolumn{9}{|l|}{Phase/Mode: System Requirements} \\ \hline
    \textbf{Sub-System} & \textbf{Design Function} & \textbf{Failure Mode} & \textbf{Effects of Failure} & \textbf{Causes of Failure} & \textbf{Recommended Actions} & \textbf{RPN} & \textbf{SR} & \textbf{Ref} \\ \hline

    Graphical User Interface & Give visual representation of the application to the end user & Incompatibility between different mobile devices  & 1.Formatting errors when resizing \newline 2.Unable to download application \newline 3.Loss of functionality or crashing & \sout{1.Button hit box detection may be lost/compromised} \newline \sout{2.}\textcolor{red}{1.}Mobile OS may not support application \newline \textcolor{red}{2.Button hit box detection may be lost/compromised} \sout{3.Processing power of phone may be too  inadequate for required signal processing} \newline \sout{4.}\textcolor{red}{3.}Mobile phone may not support bluetooth connections  & 1.Provide end users with a list of certified compatible devices \newline 2.Code/Style the application such that resizing is done automatically as the application detects screen size \newline 3.\sout{Update the application on a regular basis to ensure compatibility with latest releases of the OS} \textcolor{red}{N/A}   & Total: 20 & \sout{NFR17} \textcolor{red}{ACR4} & \sout{S2-1} \textcolor{red}{S1-1} \\ \cline{1-9}

    \end{tabular}

    \caption{Application Failure Modes and Effects Analysis}
\end{table}

\begin{table}[H]
    \centering
    
    \begin{tabular}{| p{0.11\textwidth} | p{0.08\textwidth}  | p{0.12\textwidth} | p{0.145\textwidth} | p{0.17\textwidth} | p{0.21\textwidth} | p{0.1\textwidth} | p{0.06\textwidth} | p{0.05\textwidth} |}
     \hline
    
    \multicolumn{9}{|l|}{System: Mobile Application } \\
    \multicolumn{9}{|l|}{Phase/Mode: System Requirements} \\ \hline
    \textbf{Sub-System} & \textbf{Design Function} & \textbf{Failure Mode} & \textbf{Effects of Failure} & \textbf{Causes of Failure} & \textbf{Recommended Actions} & \textbf{RPN} & \textbf{SR} & \textbf{Ref} \\ \hline

    Graphical User Interface & Give visual representation of the application to the end user & Combination of user inputs & 1.Loss of saved data \newline 2.Abrupt crashing of the application  &  1.User chooses incorrect bluetooth device to connect to \newline 2.User force closes application before applying changes  &  1.System should recognize invalid inputs from users and provide helpful error messages \newline 2.Application should provide warning when entries are not saved before allowing a force close. Warnings should require user confirmation before allowing the event  & Total: 48 & ACR3 & \sout{S2-2} \textcolor{red}{S1-2} \\ \cline{3-9}

     & & Abnormal closing of application & 1.Loss of saved data \newline 2.Incorrect communication of data  & 1.User closes application while data is being transferred \newline 2.System preemptively forces the application to close & 1.Communication protocol between the device and the application should have error handling in case of errors in data transmission \newline \textcolor{red}{2. Refer to S1-3 1)}  & Total: 40 & IR3 & \sout{S3-3} \textcolor{red}{S1-3} \\ \hline
    
    \end{tabular}

    \vspace*{0.3cm}
    Table 2 Continued: Application Failure Modes and Effects Analysis	
\end{table}

\end{landscape}

\section{Safety and Security Requirements}

\sout{Bold statements are an extension of the SRS document safety requirements which should have been included in revision 1.}

\subsection{System Isolation Requirements}

SIR1. Product is isolated from electrical components at contact locations.
\\SIR2. Auto shut-off when electrical malfunction detected. 
\\SIR3. Product has sufficient heat dissipation such that all the electrical components stay in their working temperatures.
\\SIR4. System can perform a hard reboot to reset all hardware components.

\subsection{Access Requirements}

ACR1. \sout{Authorized users} \textcolor{red}{Users} can access preferred vibration/sensitivity settings through application site.
\sout{\\ACR2. Authorized users can retrain the device through application site.}
\\\sout{ACR3.} \textcolor{red}{ACR2.} Users given error message if invalid inputs are entered in application.
\\\sout{ACR4.} \textcolor{red}{ACR3. Application will notify the user with an error message if application is installed on an incompatible device.}

\subsection{Integrity Requirements}

\sout {IR1. Only required variables will be given access to change.}
\sout{\\IR2. Data will be accessible by \sout{authorized} users.}
\\ IR3. After synchronization, a copy of \sout{data is loaded to system application.} \textcolor{red}{the Arduino signal data is loaded to system application.}
\\IR4. No pairs of modes allowed identical settings.
\\IR5. Stored data overridden only at synchronization request.
\\IR6. \sout{Application} \textcolor{red}{Device} can detect if there is an issue with the microphone.
\\IR7. Unknown messages from Bluetooth module prompt an error to the user and are rejected.
\\\textcolor{red}{IR8. Device will alert the user in the case of poor Bluetooth connection or if the phone has disconnected.}
\subsection{Privacy Requirements}
\sout{
PPR1. Personalized access code will be created for user application accessibility. 
\\PRR2. Data is not transferable between accounts.
}

\section{Roadmap}

The requirements implemented according to the hardware research milestone created in the development plan are as listed, system isolation requirements and privacy requirements. With access requirements, integrity requirements and privacy requirements being researched in the future development plan.

\end{document}
