jordanbierbrier/capstone/(threads)

Thread 1 (2022-10-07):

Team 23 Review: SRS

LemonU-mcmaster, 2022-10-07:
@samm82

1. NFR12 seems a bit unachievable since for any server applications the best achievable availability in the industry (or so called SLA) is 99.99999%, and for less critical applications the availability is usually between 99.8% and 99.99%
2. NFR23 sounds like a FR since it talks about what the system should be able to do
3. NFR-21 Sounds like a FR since it mentions what the product is expected to do, i.e. interface with mobile devices
4. NFR-25 Seems ambiguous, it mentions "[striving] to include more languages", it should specify in clear terms whether English will be the only supported language or if they intend to support multiple languages
5. Interfacing with a mobile device through bluetooth seems to be a main component of the system and is mentioned throughout the document and depicted in the context diagram however there is no functional requirement that talks about this feature.
6. NFR2 mentions the responsiveness of the buttons and that the process will begin as the button is pressed. The fit criterion seems to also be related to the response from the buttons. This is shouldn't be a style requirement.
7.  For NRF3 It mention's that the user should be able to operate the device for the sample there is little description of this sample group. As well as the age range for the sample group.

LemonU-mcmaster, 2022-10-07:
For some reason Github does not allow me to choose a label for this issue. I'd assume that one of the collaborators of this repo needs to do the label assignment.

jordanbierbrier, 2022-10-09:
@LemonU-mcmaster Thank you for the detailed feedback! I have added the label to the issue.

smiths, 2022-10-10:
@LemonU-mcmaster, next time, please create separate issues.  Separate issues are better for tracking and for closing issues.  This issue can't be closed until all 7  items have been dealt with.

UdeepShah, 2023-04-04:
Updated NFR 2, 12, 21, 23, and 25.

Closed 2023-04-04.

Thread 2 (2022-10-24):

Team 22 Review Hazard Analysis - Section 5

qureshe00, 2022-10-24:
In the FMEA table for the microphone component, the failure effects could be more descriptive. Instead of saying "device is unable to perform primary function" or "device functions incorrectly" it would be helpful to address exactly what the primary function that fails is, or what the incorrect behaviour is expected to be.  For example, "device is unable to receive/process sound" This way the reader will be able to understand the effect of the failure from the table itself.

Azriel-Gingoyon, 2023-04-05:
"Device is unable to receive sound" was added to Microphone - Effects of Failure column in Table 1: FMEA

Closed 2023-04-05.

Thread 5 (2022-10-24):

Team 22 Review Hazard Analysis - Difficult to match recommended action to causes of failures

fahmed8383, 2022-10-24:
For some rows in the table which have multiple causes of failures, the number of recommended actions do not match the causes of failures. Thus, it is difficult to track which recommended action is for which cause, for example for S1-1, by default someone would assume that recommended action 3 is for cause of failure 3, however it is actually for cause of failure 4.

Azriel-Gingoyon, 2023-04-05:
The FMEA entries have been updated so that the numbered recommended actions will correspond to their respective numbered cause of failure. (Essentially action 1 is for cause 1, etc.)

Closed 2023-04-05.

Thread 9 (2022-11-04):

Team 21 Review: Issues with System Test FRT2

snusselder, 2022-11-04:
In the System Test for Functional Requirements, test FRT2 discusses that the device will be tested in different environments. Which kind of environments specifically? Indoors? Outdoors? Will the tests be performed with different background noise or in various weather environments if performed outside? Will the testing environments change for this test or will it be the same pre-selected 5 environments for example?

@tomashetMcMaster

UdeepShah, 2023-04-05:
The test has been updated to include 4 specified environments with different specifications.

Closed 2023-04-05.

Thread 10 (2022-11-05):

Team 21 Review: Issues with System Test NFRT29

purefisher, 2022-11-05:
The system test NFRT29 is not very clear. This test states that testers will be given a device to stress test. Stress tests include battery drain, material wear, or extensive microphone use. The test then states that the device should be rated for 5 years of use. This test case is first of all way too long to be tested as a system test. The case also does not explain how much wear and tear should be put on the phone, how often it should be used in the 5 years, etc. This test case should be updated.

UdeepShah, 2023-04-05:
The team is reviewing the test and is most likely to be removed because it is beyond our project's scope.

Closed 2023-04-05.

Thread 11 (2022-11-07):

Team 21 Review: Issues With Plan Section

PeterMinbashian, 2022-11-07:
Wouldn't it be more beneficial to have scheduled meet-ups with stakeholders throughout the development of the prototype? This would be to ensure that any compromises made are approved by the stakeholders and ensure that the project does not go out of scope. It would save time as extra work could be avoided if an issue was raised earlier.

UdeepShah, 2023-04-05:
We did intend on having our project looked at and reviewed by an external stakeholder at different stages of the design process (Before POC, before Rev 0, and after Rev 0). However, this was not a formalized review and we failed to mention this in our report.

Closed 2023-04-05.

Thread 18 (2023-03-10):

Team 19 VnV Report Review: Nonfunctional Requirement Evaulation

TommYlw, 2023-03-10:
Everything looks good, except for following suggestions:
1. For section 5.1, the "manual" doesn't sound like a non-functional quality, maybe can change to corresponding words such as usability, accessibility etc.
2. In my opinion, stress test should be used a large amount of data etc. For example, for NFRT 25, I am a bit doubt whether using 10 devices is fulfilling the concept of using large amount of data.

Taranjit-lotey, 2023-04-06:
Fixed the non-functional quality

Closed 2023-04-06.

Thread 20 (2023-03-12):

Team 19 Review: VnV Report

A454545, 2023-03-12:
Great job on the document it is very descriptive and detailed. If I could make a suggestion is to have another go at your performance metrics because the tests seem to be testing functionality of the device achieving something correctly which is more of a functional requirement evaluation than non functional requirement evaluation.

Taranjit-lotey, 2023-04-06:
More details of the functional requirements

Closed 2023-04-06.
