jordanbierbrier/capstone/docs/SRS/WC.pdf

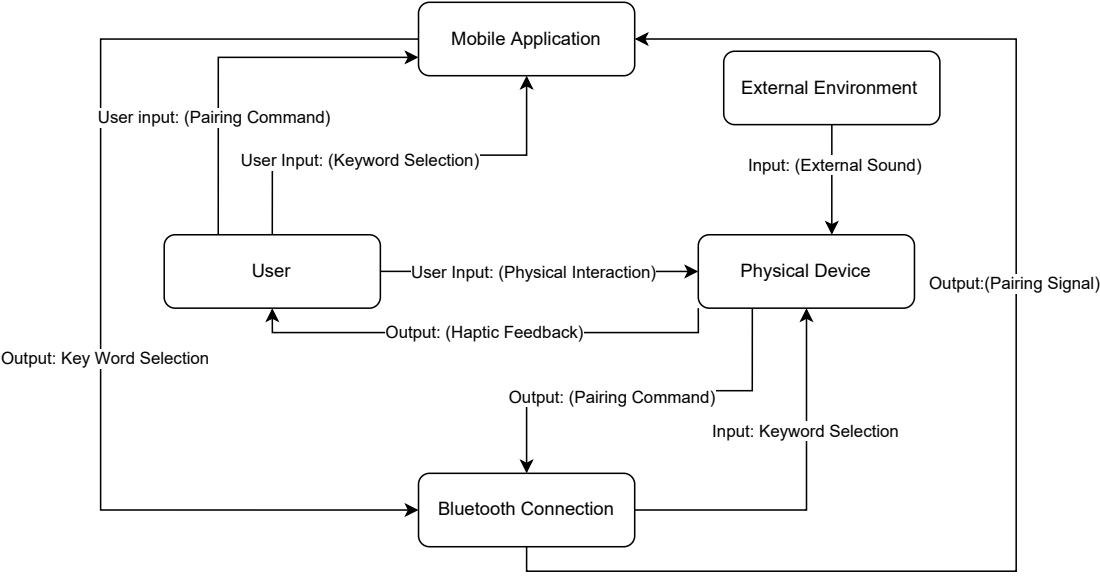
[picture p77: page 1]
Bluetooth Connection; User; Mobile Application; Physical Device; External Environment

User input: (Pairing Command)

User Input: (Keyword Selection)

Input: (External Sound)

User Input: (Physical Interaction)

Output:(Pairing Signal)

Output: (Haptic Feedback)

Output: Key Word Selection

Output: (Pairing Command)

Input: Keyword Selection
