jordanbierbrier/capstone/docs/Design/SystDesign/BluetoothConnection.pdf

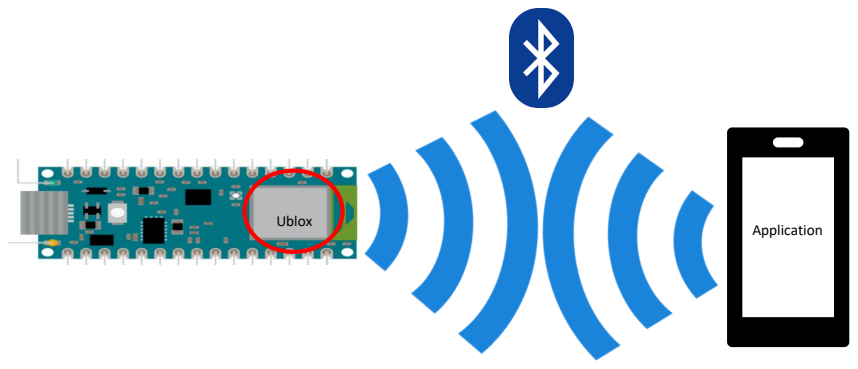
[picture p78: page 1]
Ublox; Application
