jordanbierbrier/capstone/docs/Design/SystDesign/Lid_drawing.pdf

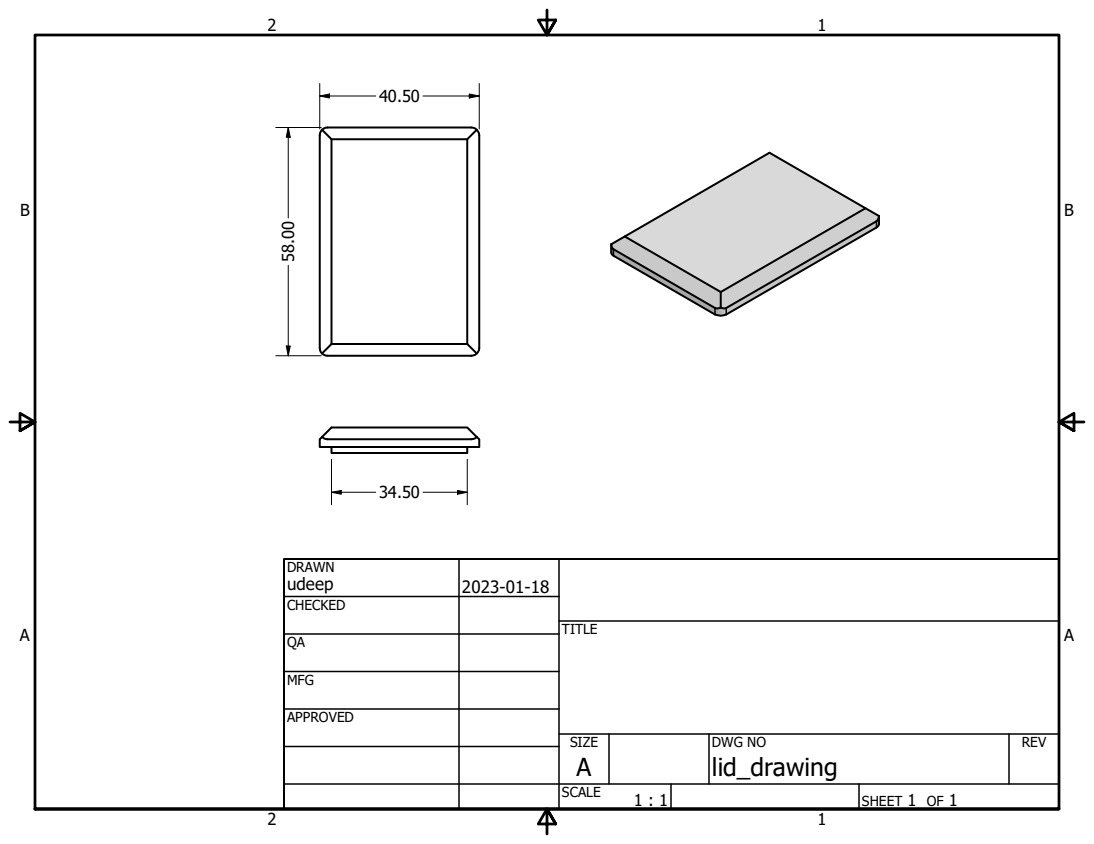
[picture p79: page 1]

DRAWN udeep | 2023-01-18

CHECKED

MFG

APPROVED

SIZE A | DWG NO lid_drawing | REV

SCALE 1 : 1 | | SHEET 1 OF 1
