jordanbierbrier/capstone/docs/Design/SystDesign/Base_drawing.pdf

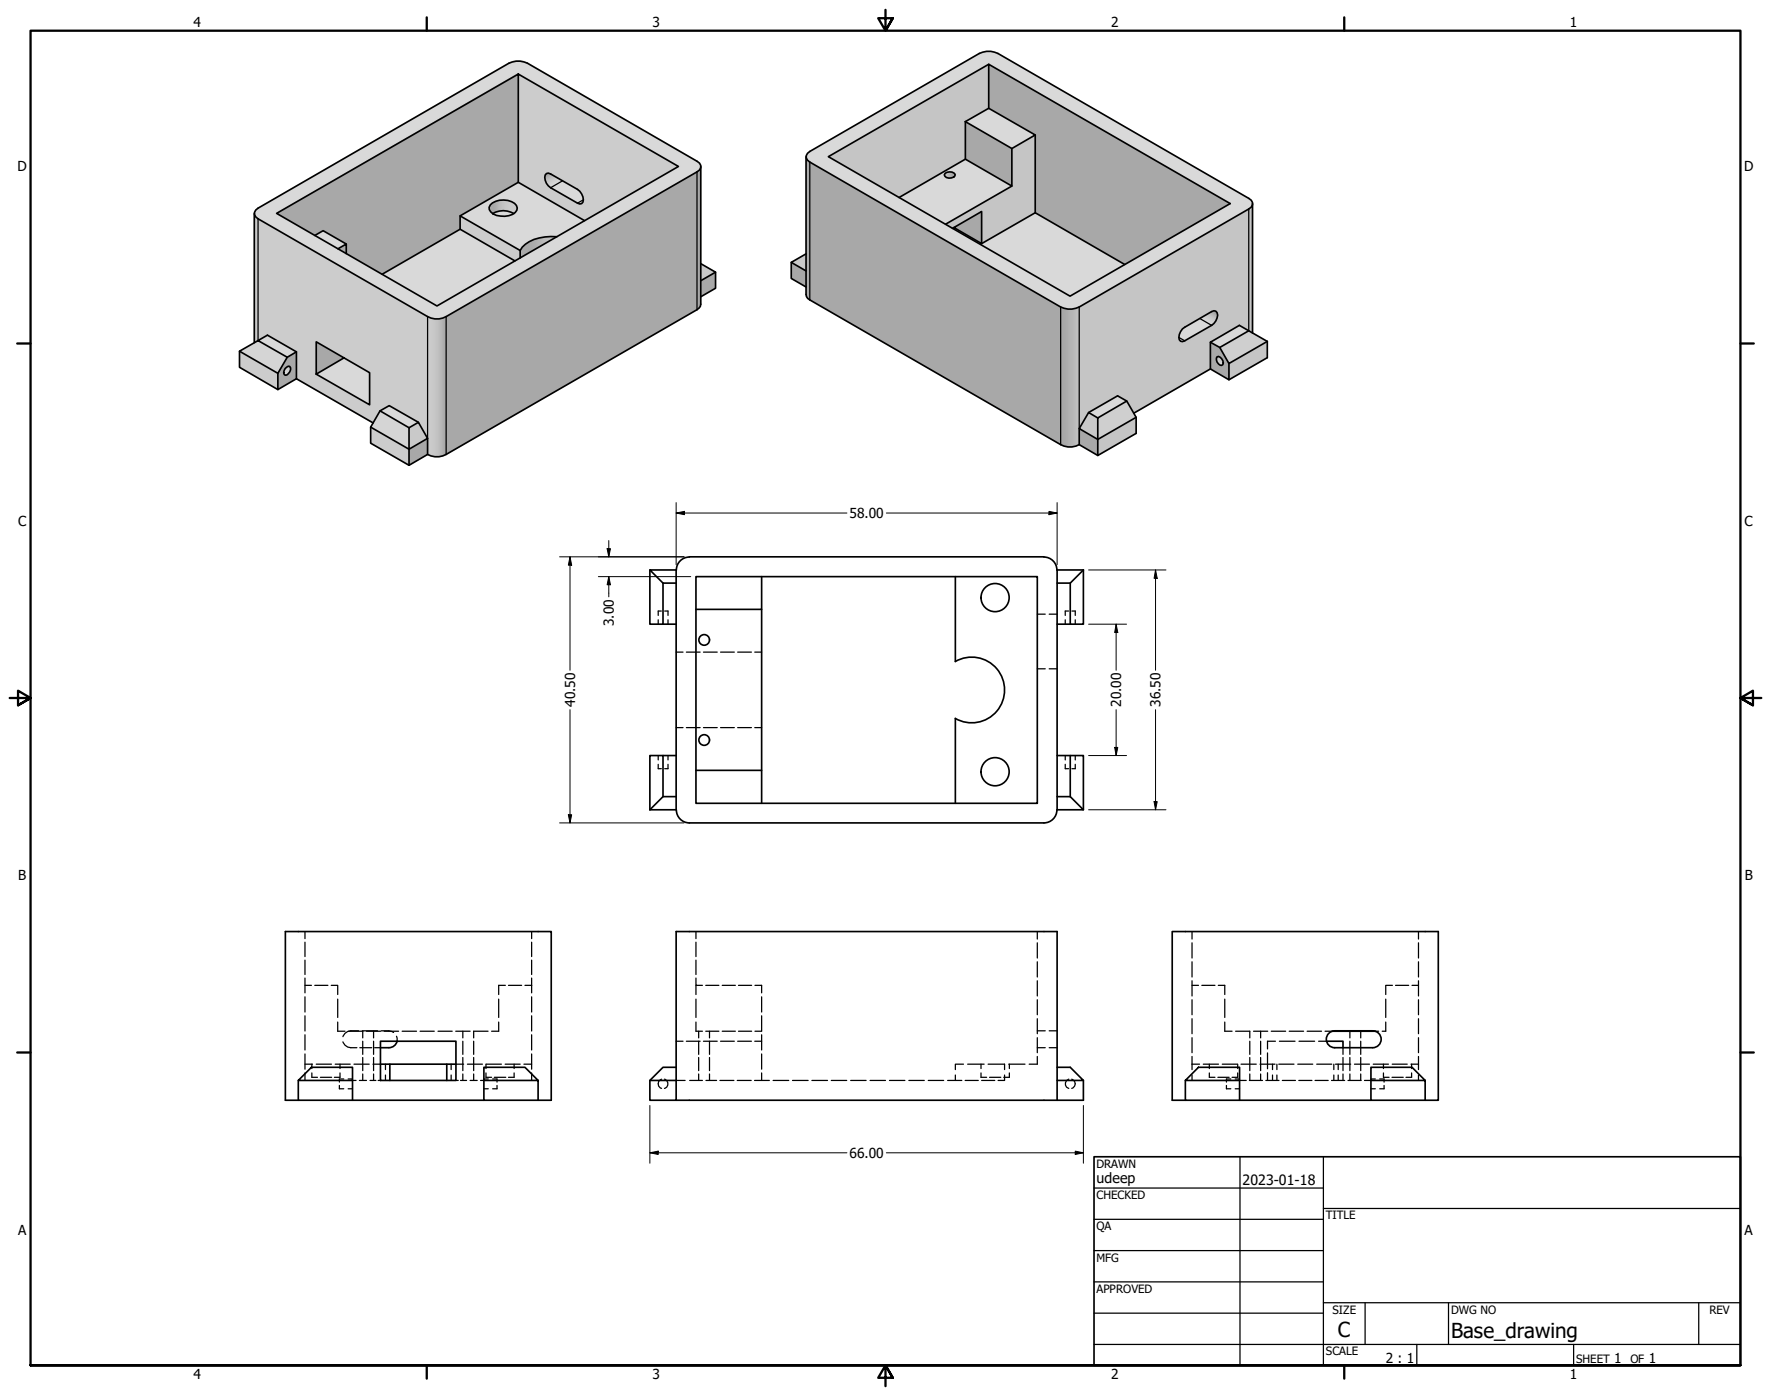
[picture p80: page 1]

DRAWN udeep | 2023-01-18

CHECKED

MFG

APPROVED

SIZE C | DWG NO Base_drawing | REV

SCALE 2 : 1 | | SHEET 1 OF 1
