jordanbierbrier/capstone/docs/SRS/UCD.pdf

# Synesthesia Wear

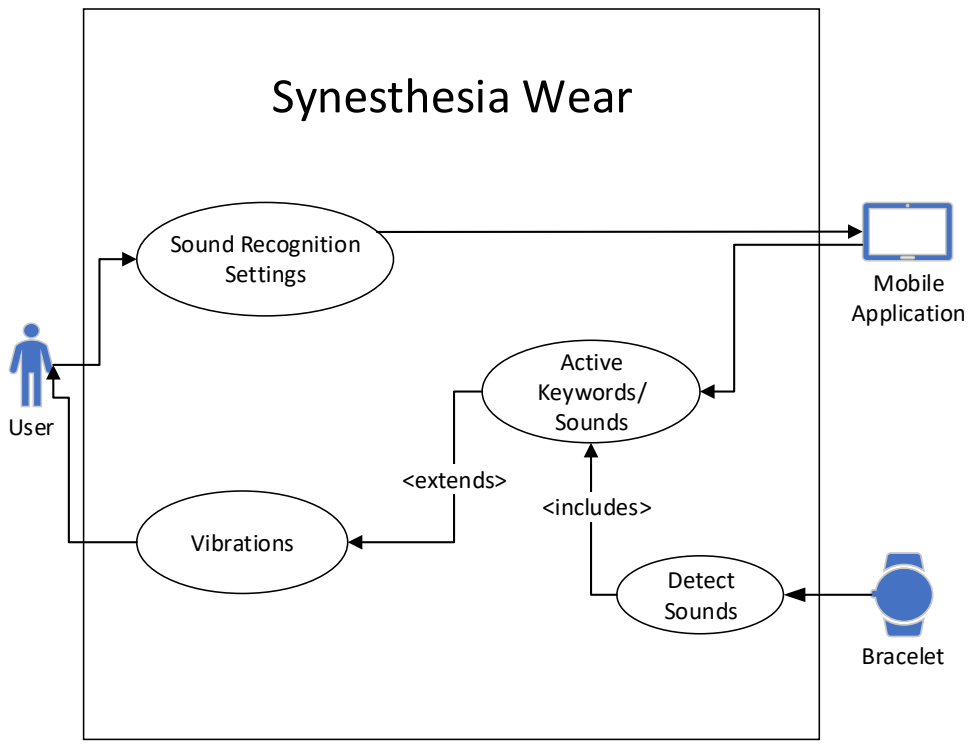
[picture p81: page 1]
User; Bracelet; Sound Recognition Settings; Detect Sounds; Vibrations; Mobile Application; Active Keywords/ Sounds

<extends>

<includes>
