jordanbierbrier/capstone/(commit log)

2022-10-05 Added Section1-Project Drivers
2022-10-06 Added Traceability section
2022-10-19 FMEA update
    Added sample table for FMEA
2022-11-03 added traceability table
2023-01-18 Created electrical schematic
2023-01-18 Inserted context dia
2023-03-09 Traceability added
2023-04-04 updated SRS
    - Matched dependencies
    - Need traceability
2023-04-05 Updated table content
    - content updated for tables
    - moved sound processing from mobile to device
    - Replaced NFRs with IIRs
2023-04-05 Updated SRS, VnV and Hazard to match
    - new FR in SRS
    - Massive changes in VnV
    -- Formatting
    -- SRTs
    -- Some test changes
    -- Trace
    -- Captions
    - Hazard - some SR removed.
2023-04-05 Updated Trace
    - Trace updated
    - Phase in updated
    - Out of scope updated
    - ref updated
2023-04-06 - Updated Formatting
    - Updated trace format
2023-04-06 Updated trace
